EricLeFort/Capstone-Project/README.md

Check out a [demo](https://www.youtube.com/watch?v=lD4AIjvDnsE) of the final project!
