EricLeFort/Capstone-Project/doc/requirements/requirements.tex

\documentclass[titlepage]{article}
\usepackage[left=15mm,right=15mm,top=1in,bottom=1in]{geometry}
\usepackage{framed}
\usepackage{caption}
\usepackage{imakeidx}
\usepackage{graphicx}
\usepackage{array}

\newcolumntype{C}[1]{>{\centering\arraybackslash} m{#1cm}}
\graphicspath{{./img/}}

\makeindex

\title{Autonomous Pool Playing Robot\\~\\\textbf{\Huge{Requirements Specification}}}
\author{
	Ernest Selman\\selmae@mcmaster.ca\\1201291\\~\\\and
	Eric Le Fort\\leforte@mcmaster.ca\\1308609\\~\\\and
	Guy Meyer\\meyerg@mcmaster.ca\\1320231\\~\\\and
	Andrew Danha\\danhaas@mcmaster.ca\\1223881\\~\\\and
	Max Moore\\moorem8@mcmaster.ca\\1320009\\~\\\and
	Derek Savery\\saverydj@mcmaster.ca\\1219142\\~\\
}
 
\begin{document}
\maketitle
\tableofcontents
~\\[15mm]
\listoftables

\vfill
\begin{table}[!htbp]
\centering
\begin{tabular}{| C{3} | C{2} | C{5} | C{2.5} |}\hline
	Date			&Revision \#	&Comments						&Authors\\\hline
	03/06/2016		&0				&- Initial document creation	&Eric Le Fort\newline Max Moore\newline Guy Meyer\newline Ernest Selman\newline Andrew Danha\newline Derek Savery\\\hline
	07/03/2017		&1				&- Added context and functional decomposition diagrams\newline -Added description of normal operation and error handling\newline -Revised requirements	&Eric Le Fort\\\hline
\end{tabular}
\caption{Revision History}
\end{table}
\newpage
 
\section{Introduction}
\subsection{Project Overview}
The purpose of this project is to provide the client with an autonomous solution for a pool playing partner. The system will utilize Visual Recognition (VR) to make its own decisions regarding shot selection and then move accordingly to take that shot.

\subsection{Product Perspective}
This section will outline various interfacing requirements as well as memory constraints of the system.
\subsubsection{System Interfaces}
The only system level interface in this project will be a simple user-facing one for obtaining commands such as: take a shot, move out of the way, or stop motion.
\subsubsection{Hardware Interfaces}
The user will have the ability to interface with the system using hardware either through buttons, sensors or other hardware solutions. This functionality will allow the user to give the system trivial commands relating to the status of the game.
\subsubsection{Software Interfaces}
The software will have two major interfacing requirements. The first will be in the formatting of the table state data that will be passed from the VR program to the core programming language. The second will be in the formatting of instruction sets to be used by the $\mu$C. These formats must be designed to be syntactically consistent so that they can be understood by both subsystems.
\subsubsection{Communications Interfaces}
This system will have two inter-system communication interfaces:
\begin{enumerate}
	\item VR to PC\\\\
	The communication between the VR and the PC will require the system to output the image takes by the VR to the PC for further computation.
	\item PC to $\mu$C\\\\
	This method of communications defines the method of transferring information from the PC to the $\mu$C that will control the hardware.
	\item $\mu$C to PC\\\\
	The $\mu$C will communicate a response back to the PC so that the PC can be sure that the message was both received and that the command is valid.
\end{enumerate}
\subsubsection{Memory Constraints}
The PC will not be very limited in terms of memory since it will have large memory storage. The limitations of the PC will arise from its RAM memory which may cause the computations to take time.\\\\
The $\mu$C is more heavily constrained by its memory since most $\mu$C use chip memory that is generally in the order of Kilobytes.

\subsection{Description of Operation}
This section will describe both normal operation and how the system will handle unexpected events.
\subsubsection{Normal Operation}
First the system must be started. This is done by starting the Android application, starting the PC program, and then starting the $\mu$C program (in that order). Once the system is ready, there are two standard events that this system can take: moving out of the way and taking a shot. Both of these will be described here.\\~\\
Moving involves receiving a request from the user indicating that a move is required. Once this request is received, the system will determine where to move and generate the appropriate control signals to move the machine to that location. After movement has finished, the system will return to an idle state.\\~\\
Taking a shot is the most complicated event that this system will handle. In this case, the machine will first receive a request from the user indicating that the machine should take a shot. The $\mu$C will receive that command and then communicate it to the PC. The PC will first acknowledge that request and then pass on the request to the camera application. The camera application will receive this request, capture an image, and communicate that image back to the PC. Upon receipt of the image, the PC will initiate the VR program. Once the VR program writes its results to the output file, the PC will read its contents into memory. The PC will then determine which shot is the best to take and communicate that shot to the $\mu$C. The $\mu$C will then acknowledge receipt of the shot. Once the $\mu$C has the shot specification, it will compute which signals will move the machine appropriately and then generate those signals.
\subsubsection{Error Handling}
As with all complicated systems, it is possible that certain errors may arise during operation. For example, successful inter-program communication is never taken for granted and so acknowledgements are in place to make sure the communication actually happens. Also, in case of danger or harm being caused by the physical machine, there will be emergency stops to force the machine to cease its operation at any stage of the process.

\newpage
\subsection{Naming Conventions \& Definitions}
This section outlines the various definitions, acronyms and abbreviations that will be used throughout this document in order to familiarize the reader prior to reading.
\subsubsection{Definitions}
Table \ref{tab:Definitions} lists the definitions used in this document. The definitions given below are specific to this document and may not be identical to definitions of these terms in common use. The purpose of this section is to assist the user in understanding the requirements for the system.
\begin{table}[h!]
\centering
\caption{Definitions}
\begin{tabular}{| C{6} | p{6cm} |}\hline
	\textbf{Term}	&\textbf{\centering Meaning}\\\hline
	X-axis					&Distance along length of pool table\\\hline
	Y-axis					&Distance across width of pool table\\\hline
	Z-axis					&Height above pool table\\\hline
	End-effector			&The end of the arm that will strike the cue ball.\\\hline
	$\theta$				&Rotational angle of end-effector\\\hline
	Cue 					&End-effector\\\hline
	Direct shot				&No obstacles between cue ball and target ball\\\hline
	Straight shot			&A direct shot in which the cue ball, target ball, and target hole form a straight line\\\hline
	Break					&This refers to the first shot at the beginning of a game of pool when the cue ball is used to strike and separate the rest of the arranged balls\\\hline
	Jump					&In reference to a pool ball, this means that the ball loses contact with the table surface\\\hline
	Personal Computer		&A laptop that will be used to run the more involved computational tasks such as visual recognition and the shot selection algorithm.\\\hline
	Camera					&Some form of image capture device (e.g. a digital camera, smartphone with a camera, etc.)\\\hline
	Table State				&The current positions of all the balls on the table.\\\hline
	Standard Shot			&A shot that does not involve backspin, jumps, curving, etc. (i.e. trick shots)\\\hline
\end{tabular}
\label{tab:Definitions}
\end{table}

\newpage
\subsubsection{Acronyms \& Abbreviations}
Table \ref{tab:Acronyms} lists the acronyms and abbreviations used in this document.
\begin{table}[h!]
\centering
\caption{Acronyms and Abbreviations}
\begin{tabular}{| p{6cm} | p{6cm} |}\hline
	\textbf{Acronym/Abbreviation}	&\textbf{Meaning}\\\hline
	VR								&Visual Recognition\\\hline
	PC								&Personal Computer\\\hline
	$\mu$C							&Micro-Controller\\\hline
\end{tabular}
\label{tab:Acronyms}
\end{table}

\section{Project Drivers}
\subsection{The Purpose of the Project}
The purpose of this project is to provide pool players with an automated system that they can play against.

\subsection{The Clients, the Customers, and Other Stakeholders}
\subsubsection{The Clients}
\begin{itemize}
	\item[-] Dr. Wassyng
\end{itemize}
\subsubsection{The Customers}
\begin{itemize}
	\item[-] Professional pool players
	\item[-] Amateur pool players
	\item[-] Pool hall owners
\end{itemize}
\subsubsection{Other Stakeholders}
\begin{itemize}
	\item[-] Team Members
	\item[-] Pool Table Manufacturers
\end{itemize}

\subsection{Users of the Product}
\begin{itemize}
	\item[-] Control test group
	\item[-] Professional pool players
	\item[-] Amateur pool players
	\item[-] Demonstrators
\end{itemize}

\section{Project Constraints}
\subsection{Mandated Constraints}
These are the constraints that are outside of the control of the development team:
\begin{itemize}
	\item[-] 750 dollars investment limit
	\item[-] Must create a functional prototype
	\item[-] The group will be required to complete the entirety of this project by April 4\textsuperscript{th}, 2017
\end{itemize}

\subsection{Other Constraints}
Other constraints that the development team decided would be necessary:
\begin{itemize}
	\item[-] System will be customized for a specific table
	\item[-] The system should not be required to break the balls
	\item[-] The system shall only perform standard shots
	\item[-] No motion further than 2ft away from table (in the plane of the table surface)
	\item[-] No motion/components further than 4ft above the table surface
	\item[-] Cannot move at a dangerous speed other than striking the pool ball
	\item[-] The system shall adhere to the rules of pool (e.g. only moving balls by taking shots with a cue, only striking the cue ball, etc.)
	\item[-] Application of chalk to the cue will be handled manually
	\item[-] The system will only operate in regular pool playing environments (i.e. indoors at room temperature with sufficient space and lighting)
\end{itemize}

\subsection{Scope}
The scope of the project includes only the components of pool that require the player to attempt and take a shot. In other words, the system will not handle freely placing a ball on the table, breaking at the beginning of the game, or automatically knowing when it should take its shot.

\subsection{Relevant Facts \& Assumptions}
This section will outline various facts and assumptions that will be leveraged in the design of this system.
\subsubsection{Facts}
\begin{itemize}
	\item[-] Weight, size, and colour of the balls
	\item[-] Table dimensions
	\item[-] Table-ball static and dynamic coefficients of friction
	\item[-] Ball-ball static coefficient of friction
	\item[-] The spring constant of the table wall
\end{itemize}
\subsubsection{Assumptions}
\begin{itemize}
	\item[-] Table surface and walls are uniform
	\item[-] Table plane is completely perpendicular to the force of gravity
	\item[-] Balls are uniform in shape and density
	\item[-] No interference will occur mid-shot (e.g. user moves a ball, stops a balls motion, etc.)
	\item[-] Balls never jump
\end{itemize}

\section{Context Diagram}
\begin{center}
	
\captionof{figure}{System Context Diagram}
\label{fig:context diagram}
\end{center}

\section{Functional Decomposition Diagram}
\begin{center}
	
\captionof{figure}{Functional Decomposition Diagram}
\label{fig:functional decomposition diagram}
\end{center}
\newpage

\section{Requirements}
The following section outlines the various requirements of this system. For each requirement, a description of the requirement, the rationale behind the requirement, and a fit criterion for when the requirement is satisfied are provided. The values given for customer satisfaction and dissatisfaction are from 0-5. The values for requirement priority are either high, medium or low.\\\\
Requirement types will correspond to the following table:
\begin{table}[!htbp]
\centering
\begin{tabular}{| C{2.2} | C{5} |}\hline
	\textbf{Requirement Type}	&\textbf{Description}\\\hline
	1							&Software Capability\\\hline
	2							&Software Communication\\\hline
 	3							&Mechanical\\\hline
	4							&Electrical\\\hline
	LF							&Look \& Feel\\\hline
	UH							&Usability \& Humanity\\\hline
 	P							&Performance\\\hline
	OE							&Operation \& Environmental\\\hline
	MS							&Maintainability \& Support\\\hline
	S							&Safety \& Security\\\hline
	CP							&Cultural \& Political\\\hline
	L							&Legal\\\hline
\end{tabular}
\caption{Requirement Types}
\end{table}
 
\subsection{Functional Requirements}
The following is a collection of the functional requirements of this system:
\begin{framed}
	\noindent\textbf{Requirement \#}: 1 \hfill \textbf{Requirement Type}: 1 \hfill\\\\
	\noindent\textbf{Description}: The system will capture an overhead image of the table.\\
	\textbf{Rationale}: The system must be able to take in data to be used in the VR algorithm.\\
	\textbf{Fit Criterion}: This requirement will be considered satisfied if the image obtained is of sufficient quality to be successfully used by the VR algorithm.\\\\
	\textbf{Originator}: Eric Le Fort\\\\
	\noindent\textbf{Customer Satisfaction}: 0 \hfill 	\textbf{Customer Dissatisfaction}: 0 \hfill\\
	\textbf{Priority}: High \hfill \textbf{Conflicts}: None \hfill 		\\
	\textbf{Supporting Material}: None\\\\
	\noindent\textbf{History}: Created 01-NOV-2016
\end{framed}

\newpage
\begin{framed}
	\noindent\textbf{Requirement \#}: 2 \hfill \textbf{Requirement Type}: 2 \hfill\\\\
	\noindent\textbf{Description}: The system will communicate image data from the camera to the PC.\\
	\textbf{Rationale}: The system will have a separate device for image capture. It is imperative that that device can communicate its data to the PC in order to be used in the VR algorithm.\\
	\textbf{Fit Criterion}: This requirement will be considered satisfied if the data received by the PC is 99.9\% identical to the data transmitted by the camera.\\\\
	\textbf{Originator}: Eric Le Fort\\\\
	\noindent\textbf{Customer Satisfaction}: 0 \hfill 	\textbf{Customer Dissatisfaction}: 0 \hfill\\
	\textbf{Priority}: High \hfill \textbf{Conflicts}: None \hfill\\
	\textbf{Supporting Material}: None\\\\
	\noindent\textbf{History}: Created 01-NOV-2016
\end{framed}

\begin{framed}
	\noindent\textbf{Requirement \#}: 3 \hfill \textbf{Requirement Type}: 1 \hfill\\\\
	\noindent\textbf{Description}: The system will create a model of the table state in software using VR.\\
	\textbf{Rationale}: The table must be modelled such that the shot selection algorithm has information to work off of.\\
	\textbf{Fit Criterion}: This requirement will be considered satisfied if the modelling of each ball on the table is accurate to within 1 centimetre of their actual position.\\\\
	\textbf{Originator}: Eric Le Fort\\\\
	\noindent\textbf{Customer Satisfaction}: 0 \hfill 	\textbf{Customer Dissatisfaction}: 0 \hfill\\
	\textbf{Priority}: High \hfill \textbf{Conflicts}: None \hfill\\
	\textbf{Supporting Material}: None\\\\
	\noindent\textbf{History}: Created 01-NOV-2016
\end{framed}

\begin{framed}
	\noindent\textbf{Requirement \#}: 4 \hfill \textbf{Requirement Type}: 1 \hfill\\\\
	\noindent\textbf{Description}: The system will select an optimal shot based off a series of simulations using the table state.\\
	\textbf{Rationale}: The system must be able to come up with a shot to make given the table state.\\
	\textbf{Fit Criterion}: This requirement will have various degrees of success. It will be considered satisfied on its simplest level if the system comes up with a shot that can sink a target ball. Further success includes selecting shots that are more likely to be successful, can sink multiple balls or can avoid sinking unwanted balls.\\\\
	\textbf{Originator}: Eric Le Fort\\\\
	\noindent\textbf{Customer Satisfaction}: 2 \hfill 	\textbf{Customer Dissatisfaction}: 4 \hfill\\
	\textbf{Priority}: Medium \hfill \textbf{Conflicts}: None \hfill\\
	\textbf{Supporting Material}: None\\\\
	\noindent\textbf{History}: Created 01-NOV-2016
\end{framed}

\newpage
\begin{framed}
	\noindent\textbf{Requirement \#}: 5 \hfill \textbf{Requirement Type}: 2 \hfill\\\\
	\noindent\textbf{Description}: The system will communicate the model of the table state from the VR program to the system's core programming language.\\
	\textbf{Rationale}: The VR program will only be used to compute VR calculations and a more suitable language will be utilized to handle the rest of the program's functionality. Therefore, the results that the VR program arrives at is likely to be passed to another language.\\
	\textbf{Fit Criterion}: This requirement will be considered satisfied if the data received by the core programming language is identical to that computed in the VR program.\\\\
	\textbf{Originator}: Eric Le Fort\\\\
	\noindent\textbf{Customer Satisfaction}: 0 \hfill 	\textbf{Customer Dissatisfaction}: 0 \hfill\\
	\textbf{Priority}: High \hfill \textbf{Conflicts}: None \hfill\\
	\textbf{Supporting Material}: None\\\\
	\noindent\textbf{History}: Created 01-NOV-2016
\end{framed}

\begin{framed}
	\noindent\textbf{Requirement \#}: 6 \hfill \textbf{Requirement Type}: 1 \hfill\\\\
	\noindent\textbf{Description}: The system will create an instruction set for the embedded system based on the selected shot.\\
	\textbf{Rationale}: Once a shot is selected, the system must then determine the necessary steps to take in order for the machine to be able to make the shot. This will include motion of all elements to position the end-effector at a suitable location from machine's current location as well as how the end-effector should strike the cue ball.\\
	\textbf{Fit Criterion}: This requirement will be considered satisfied if the instruction set provided contains all necessary information and that information does in fact instruct the embedded system on how to go about making the selected shot.\\\\
	\textbf{Originator}: Eric Le Fort\\\\
	\noindent\textbf{Customer Satisfaction}: 0 \hfill 	\textbf{Customer Dissatisfaction}: 0 \hfill\\
	\textbf{Priority}: High \hfill \textbf{Conflicts}: None \hfill\\
	\textbf{Supporting Material}: None\\\\
	\noindent\textbf{History}: Created 01-NOV-2016
\end{framed}

\newpage
\begin{framed}
	\noindent\textbf{Requirement \#}: 7 \hfill \textbf{Requirement Type}: 2 \hfill\\\\
	\noindent\textbf{Description}: The system will communicate the selected shot to the $\mu$C.\\
	\textbf{Rationale}: The PC must be able to communicate the selected shot to the $\mu$C in order to operate the machine.\\
	\textbf{Fit Criterion}: This requirement will be considered satisfied if the data received by the $\mu$C is identical to that computed in the PC 99.9\% of the time.\\\\
	\textbf{Originator}: Eric Le Fort\\\\
	\noindent\textbf{Customer Satisfaction}: 0 \hfill 	\textbf{Customer Dissatisfaction}: 0 \hfill\\
	\textbf{Priority}: High \hfill \textbf{Conflicts}: None \hfill\\
	\textbf{Supporting Material}: None\\\\
	\noindent\textbf{History}: Created 01-NOV-2016
\end{framed}

\begin{framed}
	\noindent\textbf{Requirement \#}: 8 \hfill \textbf{Requirement Type}: 2 \hfill\\\\
	\noindent\textbf{Description}: The $\mu$C will communicate an acknowledgement back to the PC.\\
	\textbf{Rationale}: The PC should be able to verify that the $\mu$C received the message.\\
	\textbf{Fit Criterion}: This requirement will be considered satisfied if the response received is identical to the response sent and if the response is correct given the current state of the system 99.9\% of the time.\\\\
	\textbf{Originator}: Eric Le Fort\\\\
	\noindent\textbf{Customer Satisfaction}: 0 \hfill 	\textbf{Customer Dissatisfaction}: 2 \hfill\\
	\textbf{Priority}: Low \hfill \textbf{Conflicts}: None \hfill\\
	\textbf{Supporting Material}: None\\\\
	\noindent\textbf{History}: Created 01-NOV-2016
\end{framed}

\begin{framed}
	\noindent\textbf{Requirement \#}: 9 \hfill \textbf{Requirement Type}: 1 \hfill\\\\
	\noindent\textbf{Description}: The $\mu$C will be able to interpret a shot instruction to control signals.\\
	\textbf{Rationale}: The embedded system must encode the instruction set it generates into the equivalent electrical signals.\\
	\textbf{Fit Criterion}: This requirement will be considered satisfied if the control signals generated from the instruction set would move the machine to the correct location.\\\\
	\textbf{Originator}: Eric Le Fort\\\\
	\noindent\textbf{Customer Satisfaction}: 0 \hfill 	\textbf{Customer Dissatisfaction}: 0 \hfill\\
	\textbf{Priority}: High \hfill \textbf{Conflicts}: None \hfill\\
	\textbf{Supporting Material}: None\\\\
	\noindent\textbf{History}: Created 01-NOV-2016
\end{framed}

\newpage
\begin{framed}
	\noindent\textbf{Requirement \#}: 10 \hfill \textbf{Requirement Type}: 4 \hfill\\\\
	\noindent\textbf{Description}: The system will be able to detect the machine's current physical state at certain locations.\\
	\textbf{Rationale}: If the system has a way of verifying the machine's current physical state, it will be able to detect unexpected disturbances. This will lead to higher accuracy of instructions being generated in certain cases as well as enabling the machine to self-correct as necessary.\\
	\textbf{Fit Criterion}: This requirement will have various degrees of success. It will be considered satisfied on its simplest level if it can be used to calibrate the system within negligible error (i.e. a default starting point to return to when in doubt). Other levels of success would include more set points that can be used as reference.\\\\
	\textbf{Originator}: Eric Le Fort\\\\
	\noindent\textbf{Customer Satisfaction}: 0 \hfill 	\textbf{Customer Dissatisfaction}: 0 \hfill\\
	\textbf{Priority}: Low \hfill \textbf{Conflicts}: None \hfill\\
	\textbf{Supporting Material}: None\\\\
	\noindent\textbf{History}: Created 01-NOV-2016
\end{framed}

\begin{framed}
	\noindent\textbf{Requirement \#}: 11 \hfill \textbf{Requirement Type}: 1 \hfill\\\\
	\noindent\textbf{Description}: The system will keep track of the machine's current physical state.\\
	\textbf{Rationale}: In order to determine how to move the machine to take its next shot, the system must know the starting physical state of the machine.\\
	\textbf{Fit Criterion}: This requirement will be considered satisfied if the physical state of the machine is updated correctly as expected movements are made by the machine.\\\\
	\textbf{Originator}: Eric Le Fort\\\\
	\noindent\textbf{Customer Satisfaction}: 0 \hfill 	\textbf{Customer Dissatisfaction}: 0 \hfill\\
	\textbf{Priority}: High \hfill \textbf{Conflicts}: None \hfill\\
	\textbf{Supporting Material}: None\\\\
	\noindent\textbf{History}: Created 01-NOV-2016
\end{framed}

\begin{framed}
	\noindent\textbf{Requirement \#}: 12 \hfill \textbf{Requirement Type}: 3 \hfill\\\\
	\noindent\textbf{Description}: The machine will be able to move the end-effector to the determined location and orientation.\\
	\textbf{Rationale}: The system must be able to relocate the end-effector in order to make a shot.\\
	\textbf{Fit Criterion}: This requirement will be considered satisfied if the machine moves close enough to the location specified by the system such that the shot can be made successfully 95\% of the time.\\\\
	\textbf{Originator}: Eric Le Fort\\\\
	\noindent\textbf{Customer Satisfaction}: 5 \hfill 	\textbf{Customer Dissatisfaction}: 5 \hfill\\
	\textbf{Priority}: High \hfill \textbf{Conflicts}: None \hfill\\
	\textbf{Supporting Material}: None\\\\
	\noindent\textbf{History}: Created 01-NOV-2016
\end{framed}

\begin{framed}
	\noindent\textbf{Requirement \#}: 13 \hfill \textbf{Requirement Type}: 3 \hfill\\\\
	\noindent\textbf{Description}: The machine will be able to actuate the end-effector to strike the cue ball, taking a shot.\\
	\textbf{Rationale}: The system must be able to strike the cue ball in order to actually take a shot. The force required will likely vary and therefore the system must be able to adjust accordingly.\\
	\textbf{Fit Criterion}: This requirement will be considered satisfied if the machine actuates the end-effector within 5\% of the specified speed and the maximum force is powerful enough to have the cue ball travel the full length of the table, bounce off the far wall, and then return halfway.\\\\
	\textbf{Originator}: Eric Le Fort\\\\
	\noindent\textbf{Customer Satisfaction}: 5 \hfill 	\textbf{Customer Dissatisfaction}: 5 \hfill\\
	\textbf{Priority}: High \hfill \textbf{Conflicts}: None \hfill\\
	\textbf{Supporting Material}: None\\\\
	\noindent\textbf{History}: Created 01-NOV-2016
\end{framed}

\begin{framed}
	\noindent\textbf{Requirement \#}: 14 \hfill \textbf{Requirement Type}: 3 \hfill\\\\
	\noindent\textbf{Description}: The machine will be able to take user input to indicate options such as: take a shot, move out of the way, or stop operation.\\
	\textbf{Rationale}: The user will need to indicate to the system what it needs it to do. Automatically knowing what the user would desire from the machine is outside of the scope of this project.\\
	\textbf{Fit Criterion}: This requirement will be considered satisfied if the embedded system can react to signals from the user signifying the specified functionalities within 5 seconds 90\% of the time.\\\\
	\textbf{Originator}: Eric Le Fort\\\\
	\noindent\textbf{Customer Satisfaction}: 2 \hfill 	\textbf{Customer Dissatisfaction}: 5 \hfill\\
	\textbf{Priority}: High \hfill \textbf{Conflicts}: None \hfill\\
	\textbf{Supporting Material}: None\\\\
	\noindent\textbf{History}: Created 01-NOV-2016
\end{framed}

\begin{framed}
	\noindent\textbf{Requirement \#}: 15 \hfill \textbf{Requirement Type}: 3 \hfill\\\\
	\noindent\textbf{Description}: The machine will be capable of moving out of the way to pre-determined locations upon user request.\\
	\textbf{Rationale}: The system must be able to move the machine out of the way if the machine is in the user's way while they are attempting to make a shot.\\
	\textbf{Fit Criterion}: This requirement will be considered satisfied if after the machine is instructed to move out of the user's way it moves to a pre-determined location.\\\\
	\textbf{Originator}: Eric Le Fort\\\\
	\noindent\textbf{Customer Satisfaction}: 4 \hfill 	\textbf{Customer Dissatisfaction}: 3 \hfill\\
	\textbf{Priority}: Low \hfill \textbf{Conflicts}: None \hfill\\
	\textbf{Supporting Material}: None\\\\
	\noindent\textbf{History}: Created 01-NOV-2016
\end{framed}

\begin{framed}
	\noindent\textbf{Requirement \#}: 16 \hfill \textbf{Requirement Type}: 3 \hfill\\\\
	\noindent\textbf{Description}: The system will be able to move the machine around the table as necessary. \\
	\textbf{Rationale}: In order to make shots, the machine must first be able to move into place.\\
	\textbf{Fit Criterion}: This requirement is satisfied if the system is able to move into any position required to take a shot.\\\\
	\textbf{Originator}: Ernest Selman\\\\
	\noindent\textbf{Customer Satisfaction}: 0 \hfill 	\textbf{Customer Dissatisfaction}: 0 \hfill\\
	\textbf{Priority}: Medium \hfill \textbf{Conflicts}: None \hfill\\
	\textbf{Supporting Material}: None\\\\
	\noindent\textbf{History}: Created 03-NOV-2016
\end{framed}

\begin{framed}
	\noindent\textbf{Requirement \#}: 17 \hfill \textbf{Requirement Type}: 3 \hfill\\\\
	\noindent\textbf{Description}: The machine will be able to take a shot regardless of the table state.\\
	\textbf{Rationale}: The machine needs to hit the cue ball without moving the other balls even if the cue ball is on the edge of the table or surrounded by other balls.\\
	\textbf{Fit Criterion}: This requirement is satisfied if the machine is able to hit the cue ball in 99\% of situations while adhering to the rules of the game.\\\\
	\textbf{Originator}: Ernest Selman\\\\
	\noindent\textbf{Customer Satisfaction}: 3 \hfill 	\textbf{Customer Dissatisfaction}: 4 \hfill\\
	\textbf{Priority}: Medium \hfill \textbf{Conflicts}: None \hfill\\
	\textbf{Supporting Material}: None\\\\
	\noindent\textbf{History}: Created 03-NOV-2016
\end{framed}

\begin{framed}
	\noindent\textbf{Requirement \#}: 18 \hfill \textbf{Requirement Type}: 4 \hfill\\\\
	\noindent\textbf{Description}: The power supply for the system must be transformed from AC to DC as necessary.\\
	\textbf{Rationale}: Certain components will rely on DC power and the power source will only provide AC current.\\
	\textbf{Fit Criterion}: This requirement will be considered satisfied if the necessary components can be successfully powered using an AC to DC converter.\\\\
	\textbf{Originator}: Andrew Danha\\\\ 
	\noindent\textbf{Customer Satisfaction}: 0 \hfill 	\textbf{Customer Dissatisfaction}: 0 \hfill\\
	\textbf{Priority}: High \hfill \textbf{Conflicts}: None \hfill\\
	\textbf{Supporting Material}: None\\\\
	\noindent\textbf{History}: Created 02-NOV-2016
\end{framed}

\newpage
\subsection{Non-Functional Requirements}
The following is a collection of the non-functional requirements of this system:
\subsubsection{Look \& Feel Requirements}
\begin{framed}
	\noindent\textbf{Requirement \#}: 2 \hfill \textbf{Requirement Type}: LF \hfill\\\\
	\noindent\textbf{Description}: The general look and feel of the setup must sufficiently resemble a standard pool table.\\
	\textbf{Rationale}: The setup must be familiar to the player such that they feel comfortable playing against the robot.\\
	\textbf{Fit Criterion}: 90\% of users should conclude that the look and feel of the setup sufficiently resembles a standard pool table.\\\\
	\textbf{Originator}: Derek Savery\\\\
	\noindent\textbf{Customer Satisfaction}: 1\hfill 	\textbf{Customer Dissatisfaction}: 4 \hfill\\
	\textbf{Priority}: Low \hfill \textbf{Conflicts}: None \hfill\\
	\textbf{Supporting Material}: None\\\\
	\noindent\textbf{History}: Created 04-NOV-2016
\end{framed}

\subsubsection{Usability \& Humanity Requirements}
\begin{framed}
	\noindent\textbf{Requirement \#}: 1 \hfill \textbf{Requirement Type}: UH \hfill\\\\
	\noindent\textbf{Description}: Players must be able to see the table setup upon their turn.\\
	\textbf{Rationale}: The users must be able to see the table in order to make decisions about future shots.\\
	\textbf{Fit Criterion}: 90\% of users should conclude that the position of the machine does not inhibit their ability to see the game-state when it is their turn.\\\\
	\textbf{Originator}: Maxwell Moore\\\\
	\noindent\textbf{Customer Satisfaction}: 2 \hfill 	\textbf{Customer Dissatisfaction}: 4 \hfill\\
	\textbf{Priority}: High \hfill \textbf{Conflicts}: None \hfill\\
	\textbf{Supporting Material}: None\\\\
	\noindent\textbf{History}: Created 03-NOV-2016
\end{framed}

\newpage
\begin{framed}
	\noindent\textbf{Requirement \#}: 2 \hfill \textbf{Requirement Type}: UH \hfill\\\\
	\noindent\textbf{Description}: The design of the machine shall not greatly inhibit a players ability to make a shot.\\
	\textbf{Rationale}: The users must be able to play alongside the machine.\\
	\textbf{Fit Criterion}: 90\% of users should conclude that the position of the machine does not inhibit their ability to make shots as well as they would be able to on a regular pool table.\\\\
	\textbf{Originator}: Maxwell Moore\\\\
	\noindent\textbf{Customer Satisfaction}: 1 \hfill 	\textbf{Customer Dissatisfaction}: 5 \hfill\\
	\textbf{Priority}: High \hfill \textbf{Conflicts}: None \hfill\\
	\textbf{Supporting Material}: None\\\\
	\noindent\textbf{History}: Created 03-NOV-2016
\end{framed}

\begin{framed}
	\noindent\textbf{Requirement \#}: 3 \hfill \textbf{Requirement Type}: UH \hfill\\\\
	\noindent\textbf{Description}: The robot should not interrupt the player's turn.\\
	\textbf{Rationale}: If the user chooses to stop the robot, or if the robot has completed its movement, the robot should remain stopped until activated by the user.\\
	\textbf{Fit Criterion}: The robot shall not interrupt the player's turn 99.9\% of the time.\\\\
	\textbf{Originator}: Derek Savery\\\\
	\noindent\textbf{Customer Satisfaction}: 1 \hfill 	\textbf{Customer Dissatisfaction}: 3 \hfill\\
	\textbf{Priority}: Medium \hfill \textbf{Conflicts}: Possibly with enforcing rules of game \hfill\\
	\textbf{Supporting Material}: None\\\\
	\noindent\textbf{History}: Created 04-NOV-2016
\end{framed}

\subsubsection{Performance Requirements}
\begin{framed}
	\noindent\textbf{Requirement \#}: 1 \hfill \textbf{Requirement Type}: P\hfill\\\\
	\noindent\textbf{Description}: The system will take shots within a reasonable amount of time.\\
	\textbf{Rationale}: The user should not have to wait too long to play their turn.\\
	\textbf{Fit Criterion}: The machine will make a shot in under 90 seconds after being instructed to 90\% of the time.\\\\
	\textbf{Originator}: Maxwell Moore\\\\
	\noindent\textbf{Customer Satisfaction}: 1 \hfill 	\textbf{Customer Dissatisfaction}: 4 \hfill\\
	\textbf{Priority}: Medium \hfill \textbf{Conflicts}: None \hfill\\
	\textbf{Supporting Material}: None\\\\
	\noindent\textbf{History}: Created 03-NOV-2016
\end{framed}

\newpage
\begin{framed}
	\noindent\textbf{Requirement \#}: 2 \hfill \textbf{Requirement Type}: P\hfill\\\\
	\noindent\textbf{Description}: The system will take shots precisely.\\
	\textbf{Rationale}: The user should feel challenged by the system.\\
	\textbf{Fit Criterion}: This requirement will be considered satisfied if the system performs to the minimum standards in terms of successful shots as set forth in the \textit{Summary and Goals} document associated with this project.\\\\
	\textbf{Originator}: Maxwell Moore\\\\
	\noindent\textbf{Customer Satisfaction}: 4 \hfill 	\textbf{Customer Dissatisfaction}: 3\hfill\\
	\textbf{Priority}: Low \hfill \textbf{Conflicts}: None \hfill\\
	\textbf{Supporting Material}: Summary and Goals document.\\\\
	\noindent\textbf{History}: Created 03-NOV-2016
\end{framed}

\begin{framed}
	\noindent\textbf{Requirement \#}: 3 \hfill \textbf{Requirement Type}: P \hfill\\\\
	\noindent\textbf{Description}: The machine will be light.\\
	\textbf{Rationale}: If the machine is light it will be easier to relocate, be handled by the user, and it will require less power to move components.\\
	\textbf{Fit Criterion}: This requirement is satisfied if the components are light enough to be moved by the system fast enough to meet timing requirements.\\\\
	\textbf{Originator}: Ernest Selman\\\\
	\noindent\textbf{Customer Satisfaction}: 0 \hfill 	\textbf{Customer Dissatisfaction}: 5 \hfill\\
	\textbf{Priority}: High \hfill \textbf{Conflicts}: None \hfill\\
	\textbf{Supporting Material}: None\\\\
	\noindent\textbf{History}: Created 03-NOV-2016
\end{framed}

\begin{framed}
	\noindent\textbf{Requirement \#}: 4 \hfill \textbf{Requirement Type}: P \hfill\\\\
	\noindent\textbf{Description}: The body of the machine will be rigid. \\
	\textbf{Rationale}: The body of the machine will be rigid in order to support the components necessary for taking shots.\\
	\textbf{Fit Criterion}: This requirement is satisfied if the machine is rigid enough not to buckle excessively or be displaced by taking a shot.\\\\
	\textbf{Originator}: Ernest Selman\\\\
	\noindent\textbf{Customer Satisfaction}: 0 \hfill 	\textbf{Customer Dissatisfaction}: 4 \hfill\\
	\textbf{Priority}: High \hfill \textbf{Conflicts}: None \hfill\\
	\textbf{Supporting Material}: None\\\\
	\noindent\textbf{History}: Created 03-NOV-2016
\end{framed}

\newpage
\subsubsection{Operational \& Environmental Requirements}
\begin{framed}
	\noindent\textbf{Requirement \#}: 1 \hfill \textbf{Requirement Type}: OE \hfill\\\\
	\noindent\textbf{Description}: The system will be able to be powered by a standard 120V AC 60Hz outlet.\\
	\textbf{Rationale}: The system should be simple to power.\\
	\textbf{Fit Criterion}: This requirement will be considered satisfied if all components of the system can be powered using a standard outlet.\\\\
	\textbf{Originator}: Andrew Danha\\\\
	\noindent\textbf{Customer Satisfaction}: 4 \hfill 	\textbf{Customer Dissatisfaction}: 5 \hfill\\
	\textbf{Priority}: Medium \hfill \textbf{Conflicts}: None \hfill\\
	\textbf{Supporting Material}: None\\\\
	\noindent\textbf{History}: Created 02-NOV-2016
\end{framed}

\subsubsection{Maintainability \& Support Requirements}
\begin{framed}
	\noindent\textbf{Requirement \#}: 1 \hfill \textbf{Requirement Type}: MS \hfill\\\\
	\noindent\textbf{Description}: The system software should separate safety critical components from other components.\\
	\textbf{Rationale}: The system will be designed to allow for updates without compromising previously tested safety-critical software components.\\
	\textbf{Fit Criterion}: All safety critical operations are encapsulated within their own modules.\\\\
	\textbf{Originator}: Eric Le Fort\\\\
	\noindent\textbf{Customer Satisfaction}: 0 \hfill 	\textbf{Customer Dissatisfaction}: 0\hfill\\
	\textbf{Priority}: Low \hfill \textbf{Conflicts}: None\hfill\\
	\textbf{Supporting Material}: None\\\\
	\noindent\textbf{History}: Created 02-NOV-2016
\end{framed}

\begin{framed}
	\noindent\textbf{Requirement \#}: 2 \hfill \textbf{Requirement Type}: MS \hfill\\\\
	\noindent\textbf{Description}: The machine will be able to stay in full working order over a reasonable amount of time.\\
	\textbf{Rationale}: The machine is not of much use if it cannot last for some amount of time.\\
	\textbf{Fit Criterion}: The machine remains in full working order or can be sufficiently repaired 6 months after construction.\\\\
	\noindent\textbf{Customer Satisfaction}: 3 \hfill 	\textbf{Customer Dissatisfaction}: 5\hfill\\
	\textbf{Priority}: High \hfill \textbf{Conflicts}: None\hfill\\
	\textbf{Supporting Material}: None\\\\
	\noindent\textbf{History}: Created 02-NOV-2016
\end{framed}
\newpage

\subsubsection{Security \& Safety Requirements}
\begin{framed}
	\noindent\textbf{Requirement \#}: 1 \hfill \textbf{Requirement Type}: S \hfill\\\\
	\noindent\textbf{Description}: High voltage components will be safely secured from users.\\
	\textbf{Rationale}: The system should not present electrical hazards.\\
	\textbf{Fit Criterion}: This requirement will be considered satisfied if all high voltage components are not readily accessible to users without tampering.\\\\
	\textbf{Originator}: Andrew Danha\\\\
	\noindent\textbf{Customer Satisfaction}: 0 \hfill 	\textbf{Customer Dissatisfaction}: 5 \hfill\\
	\textbf{Priority}: High \hfill \textbf{Conflicts}: None \hfill\\
	\textbf{Supporting Material}: None\\\\
	\noindent\textbf{History}: Created 02-NOV-2016
\end{framed}

\begin{framed}
	\noindent\textbf{Requirement \#}: 2 \hfill \textbf{Requirement Type}: S \hfill\\\\
	\noindent\textbf{Description}: Users will not be able to modify system to perform unsafe actions such as setting the power of a shot beyond a certain safe value.\\
	\textbf{Rationale}: The machine will not be able to be used in a dangerous fashion.\\
	\textbf{Fit Criterion}: This requirement is satisfied if 99.9\% of users must not be able to figure out a way of making the system perform an unsafe action.\\\\
	\textbf{Originator}: Maxwell Moore\\\\
	\noindent\textbf{Customer Satisfaction}: 0 \hfill 	\textbf{Customer Dissatisfaction}: 0 \hfill\\
	\textbf{Priority}: Low \hfill \textbf{Conflicts}: none \hfill\\
	\textbf{Supporting Material}: None\\\\
	\noindent\textbf{History}: Created 03-NOV-2016
\end{framed}

\begin{framed}
	\noindent\textbf{Requirement \#}: 3 \hfill \textbf{Requirement Type}: S \hfill\\\\
	\noindent\textbf{Description}: Sensitive electrical equipment will be isolated from high voltage.\\
	\textbf{Rationale}: Certain equipment like the $\mu$C and sensors can be damaged if connected to high voltage sources.\\
	\textbf{Fit Criterion}: This requirement is satisfied if sensitive electrical equipment is not connected to high voltage sources that would cause damage.\\\\
	\textbf{Originator}: Ernest Selman\\\\
	\noindent\textbf{Customer Satisfaction}: 0 \hfill 	\textbf{Customer Dissatisfaction}: 0 \hfill\\
	\textbf{Priority}: High \hfill \textbf{Conflicts}: None \hfill\\
	\textbf{Supporting Material}: None\\\\
	\noindent\textbf{History}: Created 03-NOV-2016
\end{framed}

\begin{framed}
	\noindent\textbf{Requirement \#}: 4 \hfill \textbf{Requirement Type}: S \hfill\\\\
	\noindent\textbf{Description}: All high voltage components will have circuit breakers.\\
	\textbf{Rationale}: The system should be safe to use.\\
	\textbf{Fit Criterion}: This requirement will be considered satisfied if the power supply is cut to all high voltage components of the system when the circuit is overloaded.\\\\
	\textbf{Originator}: Andrew Danha\\\\
	\noindent\textbf{Customer Satisfaction}: 0 \hfill 	\textbf{Customer Dissatisfaction}: 3 \hfill\\
	\textbf{Priority}: High \hfill \textbf{Conflicts}: None \hfill\\
	\textbf{Supporting Material}: None\\\\
	\noindent\textbf{History}: Created 13-NOV-2016
\end{framed}

\begin{framed}
	\noindent\textbf{Requirement \#}: 5 \hfill \textbf{Requirement Type}: S \hfill\\\\
	\noindent\textbf{Description}:The $\mu$C will have a voltage regulator.\\
	\textbf{Rationale}: The $\mu$C requires sufficient voltage/current to operate but may be damaged if too much voltage or current is supplied.\\
	\textbf{Fit Criterion}: This requirement will be considered satisfied if the $\mu$C is provided with a regulated amount of voltage and current to operate.\\\\
	\textbf{Originator}: Andrew Danha\\\\ 
	\noindent\textbf{Customer Satisfaction}: 0 \hfill 	\textbf{Customer Dissatisfaction}: 5 \hfill\\
	\textbf{Priority}: High \hfill \textbf{Conflicts}: None \hfill\\
	\textbf{Supporting Material}: None\\\\
	\noindent\textbf{History}: Created 13-NOV-2016
\end{framed}

\begin{framed}
	\noindent\textbf{Requirement \#}: 6 \hfill \textbf{Requirement Type}: S \hfill\\\\
	\noindent\textbf{Description}: Users standing at least 2ft outside the perimeter of the setup will be in no danger of being harmed by any action taken by the mechanism.\\
	\textbf{Rationale}: The robot shall not be able to harm users.\\
	\textbf{Fit Criterion}: No user standing at least 2ft outside of the perimeter of the setup shall come to harm by any action taken by the mechanism.\\\\
	\textbf{Originator}: Derek Savery\\\\
	\noindent\textbf{Customer Satisfaction}: 1 \hfill 	\textbf{Customer Dissatisfaction}: 5 \hfill\\
	\textbf{Priority}: High \hfill \textbf{Conflicts}: none \hfill\\
	\textbf{Supporting Material}: None\\\\
	\noindent\textbf{History}: Created 04-NOV-2016
\end{framed}
\newpage

\begin{framed}
	\noindent\textbf{Requirement \#}: 7 \hfill \textbf{Requirement Type}: S \hfill\\\\
	\noindent\textbf{Description}: There will be shutdown buttons located near any moving parts.\\
	\textbf{Rationale}: Users should be able to signal the system to stop if they feel they are in danger.\\
	\textbf{Fit Criterion}: Shutdown switches are located within reach of any possible dangerous location.\\\\
	\textbf{Originator}: Derek Savery\\\\
	\noindent\textbf{Customer Satisfaction}: 1 \hfill 	\textbf{Customer Dissatisfaction}: 4 \hfill\\
	\textbf{Priority}: High \hfill \textbf{Conflicts}: none \hfill\\
	\textbf{Supporting Material}: None\\\\
	\noindent\textbf{History}: Created 04-NOV-2016
\end{framed}

\subsubsection{Cultural \& Political Requirements}
\begin{framed}
	\noindent\textbf{Requirement \#}: 1 \hfill \textbf{Requirement Type}: CP \hfill\\\\
	\noindent\textbf{Description}: There will be no direct references to any political or religious groups.\\
	\textbf{Rationale}: This will avoid accidentally offending certain members of society.\\
	\textbf{Fit Criterion}: This requirement will be considered satisfied if 99\% of users say there is no noticeable political or cultural relevance.\\\\
	\textbf{Originator}: Maxwell Moore\\\\
	\noindent\textbf{Customer Satisfaction}: 0 \hfill 	\textbf{Customer Dissatisfaction}: 2 \hfill\\
	\textbf{Priority}: low \hfill \textbf{Conflicts}: none \hfill\\
	\textbf{Supporting Material}: None\\\\
	\noindent\textbf{History}: Created 03-NOV-2016
\end{framed}

\subsubsection{Legal Requirements}
\begin{framed}
	\noindent\textbf{Requirement \#}: 1 \hfill \textbf{Requirement Type}: L\hfill\\\\
	\noindent\textbf{Description}: There will be no copyright infringement, unlicensed usage of software, or services that have not been properly licensed.\\
	\textbf{Rationale}: This will avoid academic dishonesty and maintain the moral integrity of the group.\\
	\textbf{Fit Criterion}: An outside consultant will verify that there has been no copyright infringement, unlicensed usage of software, or services that have not been properly licensed.\\\\
	\textbf{Originator}: Maxwell Moore\\\\
	\noindent\textbf{Customer Satisfaction}: 1 \hfill 	\textbf{Customer Dissatisfaction}: 1 \hfill\\
	\textbf{Priority}: low \hfill \textbf{Conflicts}: none \hfill\\
	\textbf{Supporting Material}: None\\\\
	\noindent\textbf{History}: Created 03-NOV-2016
\end{framed}

\section{Project Issues}
The issues to be addressed consider marketability, competition, safety, liabilities, or any other noticeable concerns.\\
Furthermore, visual recognition, creating a pool table and the structural stability of the machine will be major challenges that must be overcome.
\subsection{Existing Products}
All known existing products are not publicly available. Nevertheless, these projects may affect the clients' view of the product and the overall marketability of the product.

\subsection{Off-the-Shelf Solutions}
Certain concerns involved in the development of this project can be addressed by using what has been created by others. There are various libraries that can be leveraged in order to aid in the visual recognition segment of this project. A pool table can be purchased to avoid difficulties in creating a high quality table environment. The structure of the system can be optimized by purchasing high quality metals that are already machined in the appropriate fashion.

\subsection{Risks}
The risks found in this project generally describe the safety considerations found with both the creation and operation of the product. This machine may have quite strong motor and actuators that may be high current or high voltage devices. It is imperative that the user's safety is taken into account and that even a player without any electrical experience will be able to at least be around the table. Another risk is achieving high enough precision to actually make successful shots.

\subsection{User Documentation \& Training}
In order to market the product the user will need to be provided with documentation regarding the operation, safety, and maintenance of the system. Although the product should be designed in a way that promotes ease of use, there must be some form of training required before the user can comfortably use the product. This may include a user manual or videos.
\end{document}
