EricLeFort/Capstone-Project/doc/Presentation/Electrical Presentation.pptx

## Electrical and Controls Summary

- Arduino Mega 2560 interfaced with RAMPS 1.4
  - Design is simplified with modular motor drives
- Endstops for controlling motors within bounds
- Simple UI
  - 2 buttons: user control button and move button
  - Colour changing LED to indicate system’s current mode

## White Line Sensors

- 2 used in the rotational system
  - 1 for each gear
  - When both sensors read low rotational system is at origin

## Pneumatic End-effector

- BJTs used to control extension
and retraction motion of piston

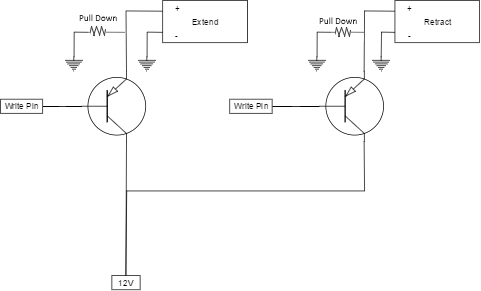
[picture p22: figure]

## Electrical and Controls Improvements

- Speed Up Slow Down

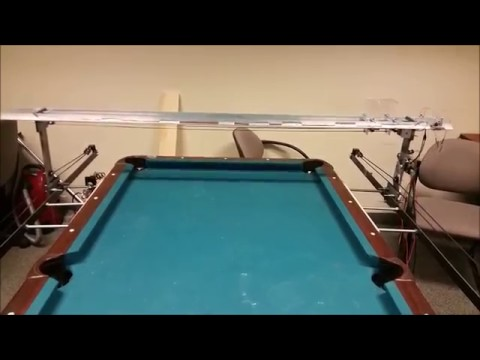
[picture p23: figure]

- End Stop Anticipation

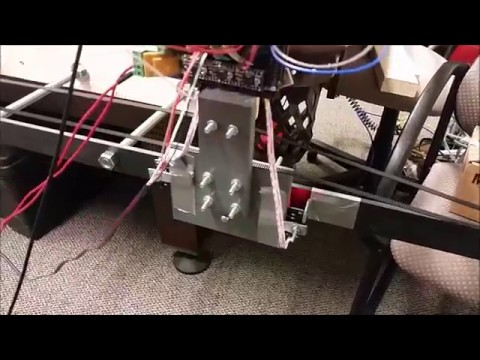
[picture p24: figure]

## Electrical and Controls Improvements #2

- Simultaneous Motion

## Electrical and Controls Hurdles

- Wire management → MCU

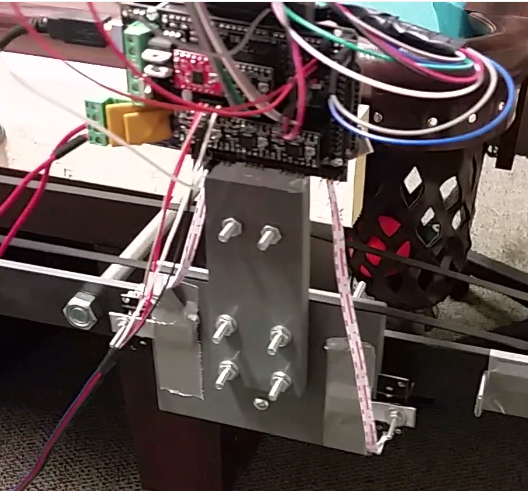
[picture p25: figure]

- Wire management → X rails

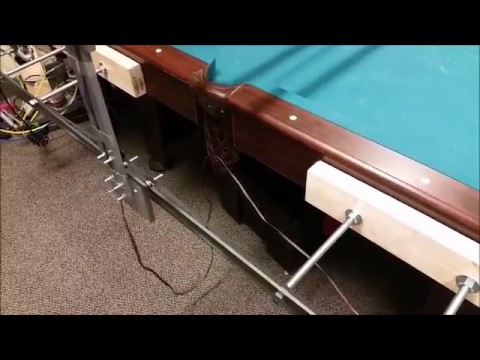
[picture p26: figure]
