EricLeFort/Capstone-Project/doc/SoftwareDesign/fullDesign/softwareDesign.pdf

# Autonomous Pool Playing Robot

# Software Design

Eric Le Fort
leforte@mcmaster.ca
1308609

March 27, 2017

## Contents

1 Introduction | 4
2 Use Cases | 7
3 Architectural Design | 8
4 Class Responsibility Collaboration (CRC) Cards | 11
5 Module Guide | 16
6 Program Diagrams | 28
7 Physics Simulations | 33

8 Error Handling | 34
8.1 µC Error Handling | 34
8.1.1 | Pseudo-Simultaneous Button Presses | 34
8.1.2 | Dangerous Physical Operation | 34
8.1.3 | Button Cooldown | 34
8.1.4 | Improper Shot Specifications | 34
8.2 PC Error Handling | 35
8.2.1 | Invalid Table State | 35
8.2.2 | Unsuccessful Shot Selection | 35
9 Communication Protocols | 35
9.1 µC - PC Controller | 35
9.2 PC VR - PC Controller | 35
9.3 Camera - PC Controller | 36
10 Scheduling of Tasks | 36
10.1 Allocation of Time | 36
10.2 Sequence Diagrams | 37

## List of Tables

1 | Revision History | | 3
2 | Definitions | | 6
3 | Acronyms and Abbreviations | | 6

## List of Figures

1 | System Block Diagram | | 4
2 | Use Case Diagram | | 7
3 | Sensor-Controller-Actuator Architecture | | 9
4 | PC VR Architecture | 11
5 | A state chart for the EventHandler module | 17
6 | A state chart for the TableStateVR module | 18
7 | A state chart for the InferenceEngine module | 20
8 | A state chart for the PCCommunicator module | 23
9 | A state chart for the Controller module | 25
10 | A state chart for the SensorMonitor module | 26
11 | A state chart for the ShotInterpreter module | 27
12 | A state chart for the µCCommunicator module | 28
13 | The system’s detailed class diagram | 29
14 | µC Program Uses Hierarchy Diagram | 30
15 | PC Controller Program Uses Hierarchy Diagram | 30
16 | PC VR Program Uses Hierarchy Diagram | 31
17 | Android Program Uses Hierarchy Diagram | 31
18 | µC Analysis Class Diagram | 32
19 | PC Controller Analysis Class Diagram | 32
20 | A sequence diagram for the “move” operation | 37
21 | A sequence diagram for the “cancel” operation | 37
22 | A sequence diagram for the “take shot” operation | 38

Date | Revision # | Comments | Authors
14/11/2016 | 0 | - High Level Design document creation | Eric Le Fort
28/11/2016 | 0 | - High Level Design first draft completion | Eric Le Fort
16/12/2016 | 0 | - Added System Block Diagram | Eric Le Fort
25/12/2016 | 0 | - Low Level Design document creation | Eric Le Fort
14/01/2017 | 0 | - Low Level Design first draft completion | Eric Le Fort
17/01/2017 | 0 | - Added Physics and Communication sections | Eric Le Fort
20/03/2017 | 1 | - Consolidated design document creation | Eric Le Fort

Table 1: Revision History

## 1 Introduction

This document’s purpose is to describe the architectural and low-level design of the software controlling the Autonomous Pool Playing Robot. Both the architecture for the encompassing system as well as architectures for distinct subsystems will be discussed. The purpose of this document will be to document the decisions made concerning the system’s design as well as provide enough detail so that the programming of the system can be as trivial as possible.

### 1.1 System Description

This system will provide a control system for an autonomous pool playing robot. It will include three separate computational units and four separate programs.

The first computational unit will be a camera (likely a camera phone). This device will be responsible for reacting to a request, taking an image and then relaying that image.

The next computational unit will be the PC. This device will have two separate programs that must execute for the system to be successful. One program will handle the VR and the other will handle shot selection as well as message passing between devices. The VR program will handle processing the image from the camera into a table state that can be used by the shot selection algorithm. The other program on the PC will handle performing an algorithm to determine which shot should be taken, where to move the cue in order to take that shot, instructing the camera to take pictures, receiving the image from the camera, receiving a signal to take a shot from the µC and communicating the shot that must be taken back to the µC.

The last computational unit, the µC, will be responsible for interpreting the shot instructions provided by the PC into signals to control the machine accordingly, receiving control signals from the system, providing signals to move the machine out of the way to predetermined locations when requested, and sending the signal to take a shot back to the PC.

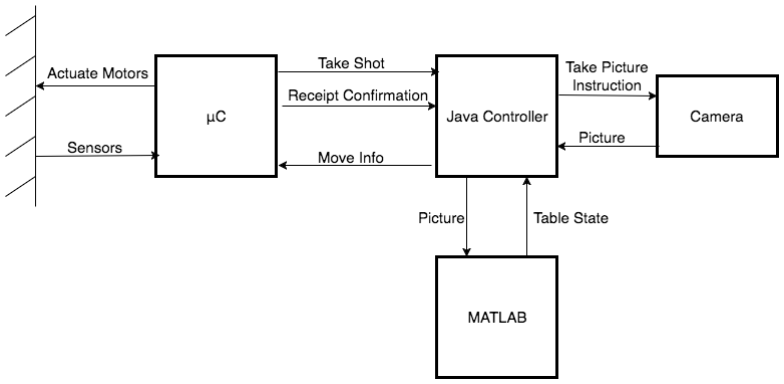
[picture p35: figure]

Figure 1: System Block Diagram

### 1.2 Overview

This document has nine sections not including this one. Each section contains either design diagrams or further explana-tions to further describe the architecture of this system and is intended to prepare the software team to implement the design.

- Use Cases: This section describes possible user interactions with the system as well as the intended results of those interactions through the use of simple diagrams. A Use Case Diagram is also provided for reference.
- Architectural Design: This section defines the overall system architecture as well as the architectures of all sub-programs. It will also discuss which components are likely to change in future versions.
- CRC Cards: Each program will be broken up into their specific classes. The responsibilities of each class as well as any collaboration required with other classes to fulfill each responsibility (if any) will be listed.
- Module Guide: This section will outline the responsibilities and secrets of each module as well as each module’s MIS and MID. Lastly, for each module, a state chart will be provided to illustrate the flow of that module.
- Program Diagrams: The section will provide a detailed class diagram to define the contents of each class in the program as well as uses hierarchy diagrams and analysis class diagrams for each program. The detailed class diagram will provide a breakdown of the contents of each class and program as well as how the various classes and programs are interconnected. The uses hierarchy diagrams will illustrate the hierarchy among the different programs, modules, and hardware. The analysis class diagrams define the various classes in each program, the direction of the flow of data between them, and their type (boundary, controller, or entity).
- Physics Simulations: This section will describe the method by which the pool table physics simulations will be performed as well as the various equations and constants involved.
- Communication Protocols: This section will describe inter-process communication protocols necessary in this system.
- Scheduling of Tasks: This section defines various timing constraints for various operations as well as sequence diagrams for the typical use cases.

### 1.3 Naming Conventions & Definitions

This section outlines the various definitions, acronyms and abbreviations that will be used throughout this document in order to familiarize the reader prior to reading.

### 1.3.1 Definitions

Table 2 lists the definitions used in this document. The definitions given below are specific to this document and may not be identical to definitions of these terms in common use. The purpose of this section is to assist the user in understanding the requirements for the system.

Table 2: Definitions

Term | Meaning
X-axis | Distance along the length of the pool table
Y-axis | Distance across the width of the pool table
Z-axis | Height above the pool table
End-effector | The end of the arm that will strike the cue ball
θ | Rotational angle of end-effector
Cue | End-effector
Personal Computer | A laptop that will be used to run the more involved computational tasks such as visual recognition and the shot selec-tion algorithm
Camera | Some form of image capture device (e.g. a digital camera, smartphone with a camera, etc.)
Table State | The current positions of all the balls on the table
Entity | Classes that have a state, behaviour and identity (e.g. Book, Car, Person, etc.)
Boundary | Classes that interact with users or ex-ternal systems
Double | Double-precision floating point num-bers

### 1.3.2 Acronyms & Abbreviations

Table 3 lists the acronyms and abbreviations used in this document.

Table 3: Acronyms and Abbreviations

Acronym/Abbreviation | Meaning
VR | Visual Recognition
PC | Personal Computer
µC | Micro-Controller
CRC | Class Responsibility Collaboration

## 2 Use Cases

This section will outline the use cases that this system will be expected to handle. A Use Case Diagram will also be provided to help illustrate these cases. All use cases are initiated by the user interacting with a physical interface that will send a signal to the µC. Between operations, the various programs will revert to a dormant state to await the next instruction.

### 2.1 Use Case Diagram

The following diagram depicts the use cases of this system.

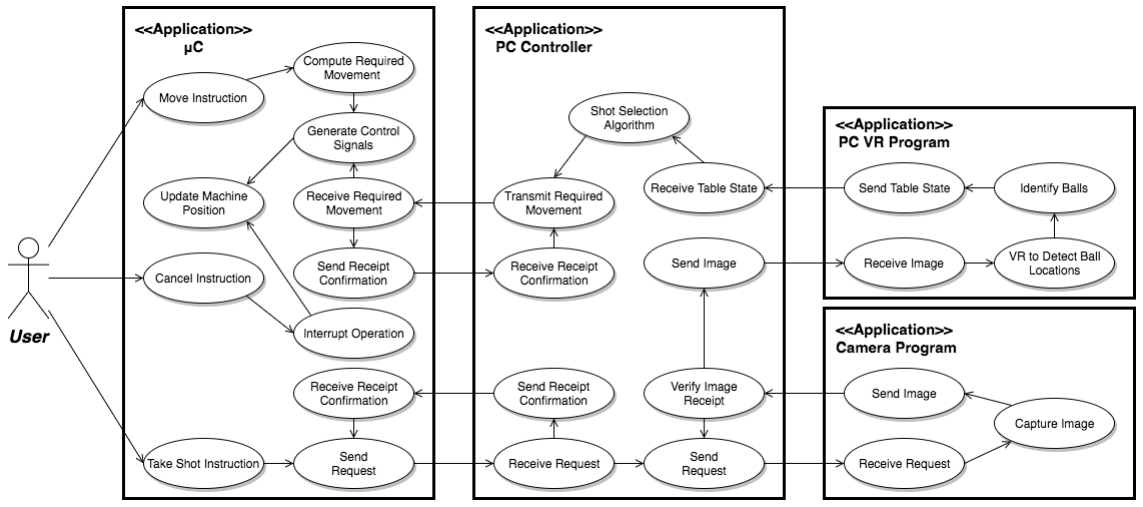
[picture p36: figure]

Figure 2: Use Case Diagram

### 2.2 Move Instruction

This use case involves only the µC. The user presses the move button. Once the signal has been received, the µC will decide which predetermined set point to move to based on the current position of the machine that is stored in its memory. The µC will then determine the signals required to relocate the machine to the appropriate location and then send them to the machine. Once those signals are sent, the µC will update its memory to store the new position of the machine.

### 2.3 Cancel Instruction

This use case involves only the µC. The user presses the cancel button. Once the signal has been received, the µC will immediately stop the machine’s motion. It will then update its memory to store the current position of the machine.

### 2.4 Take a Shot Instruction

This use case involves all four programs: the µC, the PC Controller Program, the Camera Program, and the PC VR Program in that order. The user presses the take a shot button. Once the signal has been received, the µC will send a request to the PC to begin its process and wait a small amount of time for the PC to send a receipt response. If the µC does not receive a response within the specified timeframe, it will resend its request. This process will be repeated until a response is received. The PC Controller Program will then send a signal to the camera to take a photo. Upon receiving this signal, the camera will take a picture of the table and send this back to the PC. If the picture was received correctly, the PC Controller Program will then start the PC VR Program and provide the picture to be used. Otherwise, the PC Controller Program will continue to resend the request to take a picture as necessary. The PC VR Program will utilize object detection to determine where the balls are on the table and which ball is which. Once collecting this information, it is provided to the PC Controller Program through an intermediate file. The PC Controller Program will then use its shot selection algorithm to determine how to strike the pool ball to take based on the table state provided and transmit that shot to the µC. After that, the µC will send a receipt signal back to the PC Controller Program. The µC will interpret the shot information to create an instruction set of signals to move the machine appropriately and take the shot.

### 2.5 Take a Shot Operation Interrupted During PC Computation

This use case involves all four programs: the µC, the PC Controller Program, the Camera Program, and the PC VR Program in that order. The user presses the take a shot button. Once the signal has been received, the µC will send a request to the PC to begin its process and wait a small amount of time for the PC to send a receipt response. If the µC does not receive a response within the specified timeframe, it will resend its request. This process will be repeated until a response is received. Sometime between this point and getting the selected shot communicated back to the µC, the user presses the cancel button. The PC will complete its normal operation but once the shot is communicated back to the µC, it will simply be ignored.

## 3 Architectural Design

This section will discuss the architectures that are to be used while designing this system. The goal of these architectures is to promote the overall quality of the software for this system. In particular, the software should be more efficient, robust, and maintainable as a result of this architectural design.

### 3.1 System Architecture

The architecture of this system as a whole will be modelled using the Batch Sequential style. This architecture involves sending chunks of data after each program is completely done processing and promotes simple division of subsystems that can operate as independent programs. This creates a strong separation of concerns within the larger system.

The shortcomings of this system are that it does not allow for concurrency and it has low throughput. Luckily, in this situation, the throughput is not intended to be very high. Also, each subsystem must wait for the previous system to fully complete its task in order to proceed regardless. Therefore, since this system does not even allow for concurrent operation, there is no loss in potential efficiency.

### 3.2 Subsystems

The subsystems will follow the batch sequential architecture on a system level but that architecture does not make sense for the subsystems themselves. This section will discuss the architectures that will be utilized on the subsystem level.

### 3.2.1 µC Architecture

This subsystem will utilize a Sensor-Controller-Actuator architecture style. This style is well-suited to embedded systems that deal with hardware which is optimal for this subsystem. The style breaks the subsystem up into four types of components: interfaces, sensors, actuators, and a controller. An illustration of the architecture is provided below:

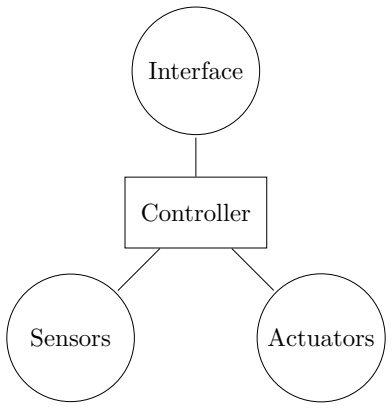
[picture p37: figure]
Controller; Interface; Sensors; Actuators

Figure 3: Sensor-Controller-Actuator Architecture

In the case of this subsystem, the breakdown of the components into these types will be as follows:

- Sensors - System State

– Calibration sensors (quantity yet to be determined)

- Sensors - Interface

– Stop buttons (multiple located throughout machine, quantity yet to be determined)

– Move button

– Take shot button

- Logic

– Motion logic

– Current state info

- Actuators

– Translational motors (×2)

– Rotational motor

– Pneumatic end-effector

### 3.2.2 PC Controller Architecture

This subsystem will utilize a Rule-Based architecture style. This style is well suited to making strategic moves while playing a game with rigid rules constraining actions. In other words, for deciding which shot is the best to take given the current state of table and the rules of the game of pool. This style breaks down the subsystem into four types of modules: an interface, a rule-set, working memory, and an inference engine. The interface will be where the system gets its input and sends its output. The rule-set is a particular sort of knowledge base that contains the rules constraining the acceptable actions. The working memory is temporary memory used by the subsystem. Lastly, the inference engine is what ties the subsystem together. Its job is to apply the rules appropriately and, using the working memory as a tool, generate the appropriate result to send as output.
In the case of this subsystem, the breakdown of these modules into these types will be as follows:
- Interface

– Input – table state
– Output – specification of shot (position, angle, and force)
- Rule-Set

– Rules of pool

– Mechanical constraints
– Physical constants (i.e. ball weight, table friction, spring constant of table cushions, etc.)
- Working Memory

– Table state

– Current optimal shot

- Inference Engine

– Simulate results of shots

– Check rules against shot simulations at some incremental angle

– Score shots based on weighted application of rules

### 3.2.3 Camera Architecture

This subsystem will utilize an Event-Driven architectural style. This will likely be the simplest subsystem present in the system. The role of this program is to sit idle waiting for a request to take a picture. Once it receives that request, it should take a picture and then communicate that image back to the PC Controller program. This request is the only event this program must respond to.

### 3.2.4 PC VR Program Architecture

This subsystem will also utilize a Batch Sequential architecture style. This style has already been discussed in the system architecture and so will not be discussed again here. In this subsystem, the process is begun upon receipt of the request to start operation. The subsystem will then utilize a VR library to detect the balls as objects on the table using the image provided. The results of this will be passed to the next step which will use the positions of the identified objects to determine which specific ball is which using colour comparison. Once this step completes, the table state has been computed and is then sent back to the PC Controller program. The issues of low throughput and lack of concurrency are not an issue in this case as the system would have to wait for the previous step to complete in order to begin the next step anyway.

An illustration of the specific implementation of this architecture is provided below:

in image
−−−−→ object detection

image &
object positions
−−−−−−−−−−→ ball identification table state −−−−−−−→ out

Figure 4: PC VR Architecture

### 3.3 Likely Changes

Due to the nature of this project and the condensed time frame in which the development team must produce a prototype, certain aspects in this document are likely to change. Firstly, regarding the physics engine, various physical constants require the system be complete in order to be accurately measured. Currently, any marked TBM are filled with estimated “placeholder” values. Also, the method of determining the parallel velocity component after a ball-wall collision should be improved. Secondly, regarding inter-program communication, either a module to adapt given the user’s internet settings or a different method of communication would likely be necessary to improve the modularity of the system.

## 4 Class Responsibility Collaboration (CRC) Cards

This section provides CRC cards for all classes in each of the programs. Each card will list the responsibilities as well as any classes the must be collaborated with to perform that responsibility.

### 4.1 µC CRC Cards

The following are the CRC cards for the µC program:

SensorMonitor

Responsibilities | Collaborators
- Sensing signals from buttons - Sensing signals from calibration sensors | (None) (None)

Communicator

Responsibilities | Collaborators
- Send shot calculation request to the PC Controller Program - Receive request receipt confirmation from PC Controller Program - Send shot receipt confirmation to PC Controller Program - Receive shot specification from PC Controller Program | Communicator (PC) Communicator (PC) Communicator (PC) Communicator (PC)

SignalGenerator

Responsibilities | Collaborators
- Control translational motors - Control rotational motor - Control pneumatic end-effector | Shot Interpreter Shot Interpreter Shot Interpreter

ShotInterpreter

Responsibilities | Collaborators
Translate shot instruction into list of appropriate signals | State, Communicator (µC)

State

Responsibilities | Collaborators
Store and allow access to data regarding the current physical position of the machine | Communicator (µC)

Controller

Responsibilities | Collaborators
Interrupt operation if that instruction is received Control flow of program operation | SensorMonitor (None)

### 4.2 PC Controller CRC Cards

The following are the CRC cards for the PC Controller program:

Communicator

Responsibilities | Collaborators
- Listens for request from µC - Sends confirmation of receipt to µC - Sends shot specification to µC - Listen for receipt confirmation from µC - Sends image capture request to camera - Listens for response from camera - Initiate the PC VR program - Read table state from file | Communicator (µC) Communicator (µC) Communicator (µC), Shot, Vector Communicator (µC) EventHandler EventHandler (None) (None)

Vector

Responsibilities | Collaborators
- Stores and allows access to an x- and y-component of a vector | (None)

Ball

Responsibilities | Collaborators
- Store and allow access to its position - Store and allow access to the value representing its identity | Vector (None)

Shot

Responsibilities | Collaborators
- Store and allow access to the position from which to take this shot - Store and allow access to the angle from which to take this shot - Store and allow access to the amount of power to use to take this shot - Store and allow access to the scoring assigned to this shot | Vector (None) (None) (None)

TableState

Responsibilities | Collaborators
- Store and allow access to the positions of the balls present on the table - Store and allow access to the number of both types of ball on the table | Ball, Vector Ball

SimulationInstance

Responsibilities | Collaborators
- Maintain the positions and velocities of balls on the table at the current time step - Update the positions and velocities of balls after one time step - Keep track of whether there is still movement occurring - Keep track of the scoring of the simulation (of a shot) | TableState, Vector TableState, Vector Vector TableState

InferenceEngine

Responsibilities | Collaborators
- Calculate the shot to be made | SimulationInstance, TableState, Shot, Vector

### 4.3 Camera CRC Cards

The following is the CRC card for the Camera program:

Event Handler

Responsibilities | Collaborators
- Listen for request from PC Controller - Take a photo - Communicate the photo | Communicator (PC) (None) Communicator (PC)

### 4.4 PC VR Program CRC Cards

The following is the CRC card for the PC VR program:

TableStateVR

Responsibilities | Collaborators
- Read image from a file - Locate balls using VR - Determine ball identities - Write table state to a file | (None) (None) (None) (None)

## 5 Module Guide

This section discusses the various modules that this system is comprised of. The modules are divided based on which program they belong to. For each module, its responsibilities, secrets, MIS, and MID will be outlined.

### 5.1 Camera Modules

The following is the module contained within the Camera subsystem.

### 5.1.1 EventHandler

Responsibilities

- Listen for request from PC Communicator
- Take a photo
- Communicate photo to PC Communicator

Secrets

- Picture-taking process

MIS

This module is an always-running program which executes the function of taking a picture and communicating it back to the requesting program. It’s only “input” is the request to take a picture. While this module is not performing the previous function, it will be listening for a request to be made.

MID

The state chart below provide a succinct depiction of this module’s internal design.

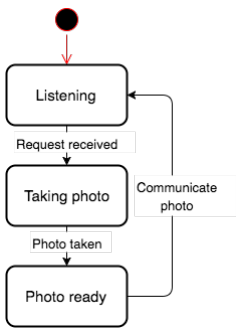
[picture p38: figure]

Figure 5: A state chart for the EventHandler module.

### 5.2 PC VR Program Modules

The following is the module contained within the PC VR subsystem.

### 5.2.1 TableStateVR

Responsibilities

- Read image from a file
- Locate balls using VR
- Determine ball identities
- Write table state to a file

Secrets

- Object detection algorithm
- Ball identification algorithm

MIS

This module takes in an image of a pool table and analyzes it in order to return the locations and identities of each of the pool balls on the table. This is returned in the form of an output file where the nth line contains the x- and y-coordinates for the nth ball.

MID

This module has 4 main steps. First it must read in the image from a predetermined file location. Then it locates the pool balls in that picture using a Visual Recognition object detection algorithm (supplied by a VR library). Next, it will identify which ball is which according to comparing pixel colours within the detected objects to the colours of different pool balls using a LAB colour space. Lastly it will write these results to a file.

The following pseudocode better describes this process:

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

r e t u r n r e s u l t s ;

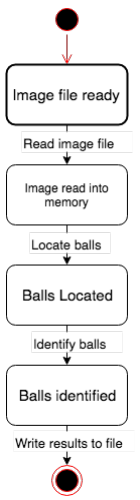
[picture p39: figure]

Figure 6: A state chart for the TableStateVR module.

### 5.3 PC Controller Modules

The following are the modules contained within the PC Controller subsystem.

### 5.3.1 InferenceEngine

Responsibilities

- Calculate the best shot to be made

Secrets

- Algorithm to choose which shots to simulate
- The computer’s ball type (i.e. stripes or solids)
- The rules of pool

MIS

This module allows for specification of a TableState through the use of a 2-D array of doubles. Using that TableState, the module will simulate various potential shots in order to determine an optimal one which is then accessible to other classes in the form of a Shot object.

MID

This module iterates through shots that are to be simulated by SimulationInstances. In order to minimize computation, it only looks at shots that have a hope of directly hitting another legal ball (e.g. the eight ball cannot be struck first unless all of the player’s other balls are already sunk). Furthermore, it is assumed that there will only be three discrete power options available to select from. At the end of this computation, this module returns the specification of the optimal shot.

The following pseudocode better describes this process:

de te rmine b a l l s t o s h o o t ;

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

w hil e ( sim ul a ti o n not f i n i s h e d ){
sim ul a ti o n . update ( ) ; }

update c u r r e n t shot ’ s s c o r e ;

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

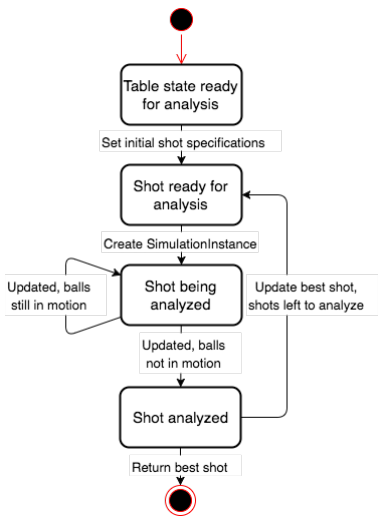
[picture p40: figure]

Figure 7: A state chart for the InferenceEngine module.

### 5.3.2 PCCommunicator

Responsibilities

- Listens for request from µC
- Sends confirmation of receipt to µC
- Sends shot specification to µC
- Listens for confirmation of receipt from µC
- Sends image capture request to camera
- Listens for response from camera
- Initiate the PC VR program
- Read table state from file

Secrets

- Receipt confirmation message contents
- Maximum time awaiting a response

MIS

This module is an always-running process which communicates with the various programs in this system while also providing control flow for the PC Controller program. The only “inputs” it receives is requests from the µC program and its “output” is the shot specification

MID

The state charts below provide a succinct depiction of this module’s internal design.

### 5.3.3 SimulationInstance

Responsibilities

- Maintain the positions and velocities of the balls on the table at the current time step
- Update the positions and velocities of the balls on the table after a time step
- Keep track of whether there is still movement happening
- Keep track of the scoring of the simulation (of a shot)

Secrets

- The method of calculating a shot’s score
- Shot simulation algorithm
- Physical constants
- Simulation time step

MIS

This module handles the physics simulation involved with taking a shot while also scoring the shot according to various criteria. It receives a 2-D array of doubles as ball positions, a double for the angle of the shot, and a double for the power of the shot. These inputs define the initial state of the physical system to simulate. The state is updated for a new time step by calling the appropriate command and an integer representing the resulting change in score from that time step is returned. The Once it returns false, there is no further motion and the simulation is complete.

MID

This module handles performing a discrete time step simulation of a shot according to a shot and initial state of the table. In order to achieve this, it updates to the next snapshot of the simulation until every ball remaining on the table is stationary.

First, the following pseudocode describes how this object is created:

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

inMotion = t r u e ;
s c o r e = 0 ;

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

The following pseudocode assumes a very fine time step but may not not be feasible given the imposed time constraints (which will be tested empirically):

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

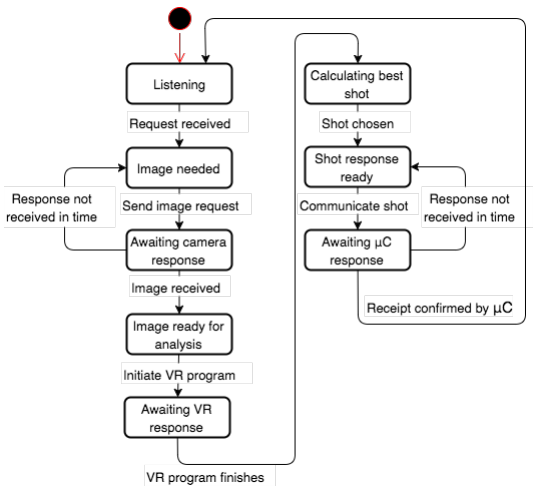
[picture p41: figure]

Figure 8: A state chart for the PCCommunicator module.

### 5.4 µC Modules

The following are the modules contained within the µC subsystem.

### 5.4.1 Controller

Responsibilities

- Control flow of program operation
- Interrupt operation if cancel instruction is received

Secrets

- Set movement positions (for “move” commands)
- Instruction dispatch process

MIS

This module handles the control flow for the µC Program including determining appropriate movement and creation of interrupts when necessary. Its “inputs” are when it is notified of state changes such as button presses or position updates from the Sensor Monitor or Signal Generator modules as well as shot specifications (doubles holding the x- and y-coordinates, angle, and power) from the Communicator. Its “outputs” are sending the shot request to the Communicator as well as passing on the shot specification to the Signal Generator.

MID

The state chart below provides a succinct depiction of most of this module’s internal design. The only other notable component in this module is how it selects where to move when a “move” command is received. In that event, it compares the current location to the two set locations at either end of the table. Whichever one is furthest is the one which the machine is moved towards. This is designed in a way such that the machine moves as far away as possible from where it was in the way of the user.

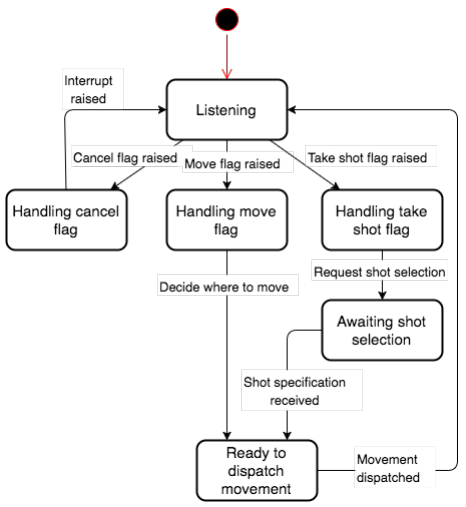
[picture p42: figure]

Figure 9: A state chart for the Controller module.

### 5.4.2 SensorMonitor

Responsibilities

- Sensing signals from buttons
- Sensing signals from calibration sensors

Secrets

- The method of noticing signals

MIS

This module monitors the control signals coming from the buttons and calibration sensors and notifies the Controller when one of these sensors are activated. It’s “inputs” are the control signals and its “outputs” are flags that are raised.

MID

The state chart below provides a succinct depiction of this module’s internal design.

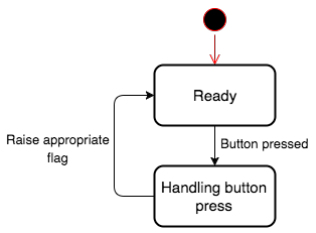
[picture p43: figure]

Figure 10: A state chart for the SensorMonitor module.

### 5.4.3 ShotInterpreter

Responsibilities

- Translate shot instruction into list of appropriate signals
- Control translational motors
- Control rotational motor
- Control pneumatic end-effector

Secrets

- Algorithm to determine appropriate movement
- Method of transmitting signals to machine

MIS

This module receives a shot specification (doubles holding the x- and y-coordinates, angle, and power) in order to compute and generate the signals necessary to have the machine perform the required motion. It’s “outputs” are the control signals that it generates.

MID

The state chart below provides a succinct depiction of this module’s internal design.

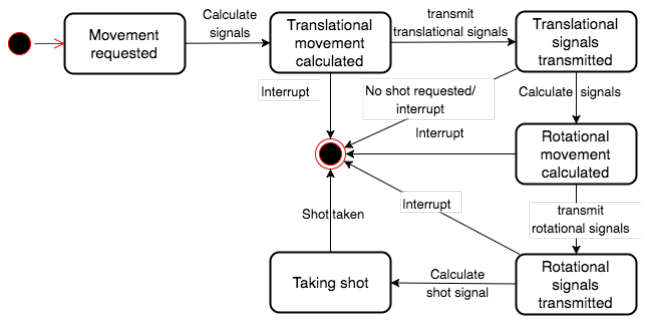
[picture p44: figure]

Figure 11: A state chart for the ShotInterpreter module.

### 5.4.4 µCCommunicator

Responsibilities

- Send shot calculation request to the PC Controller program
- Receive confirmation of receipt from PC Controller program
- Receive shot specification from PC Controller program
- Send confirmation of receipt to PC Controller program

Secrets

- Receipt confirmation message contents
- Maximum time awaiting a response

MIS

This module handles communicating with the PC Controller Program in order to compute the optimal shot to take. It’s “inputs” are the request from the Controller and the shot specification (doubles holding the x- and y-coordinates, angle, and power) from the PC. It then passes that shot specification on to the Controller.

MID

The state charts below provide a succinct depiction of this module’s internal design.

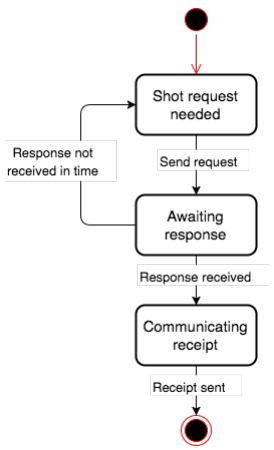
[picture p45: figure]

Figure 12: A state chart for the µCCommunicator module.

## 6 Program Diagrams

### 6.1 Detailed Class Diagram

(found on the next page)

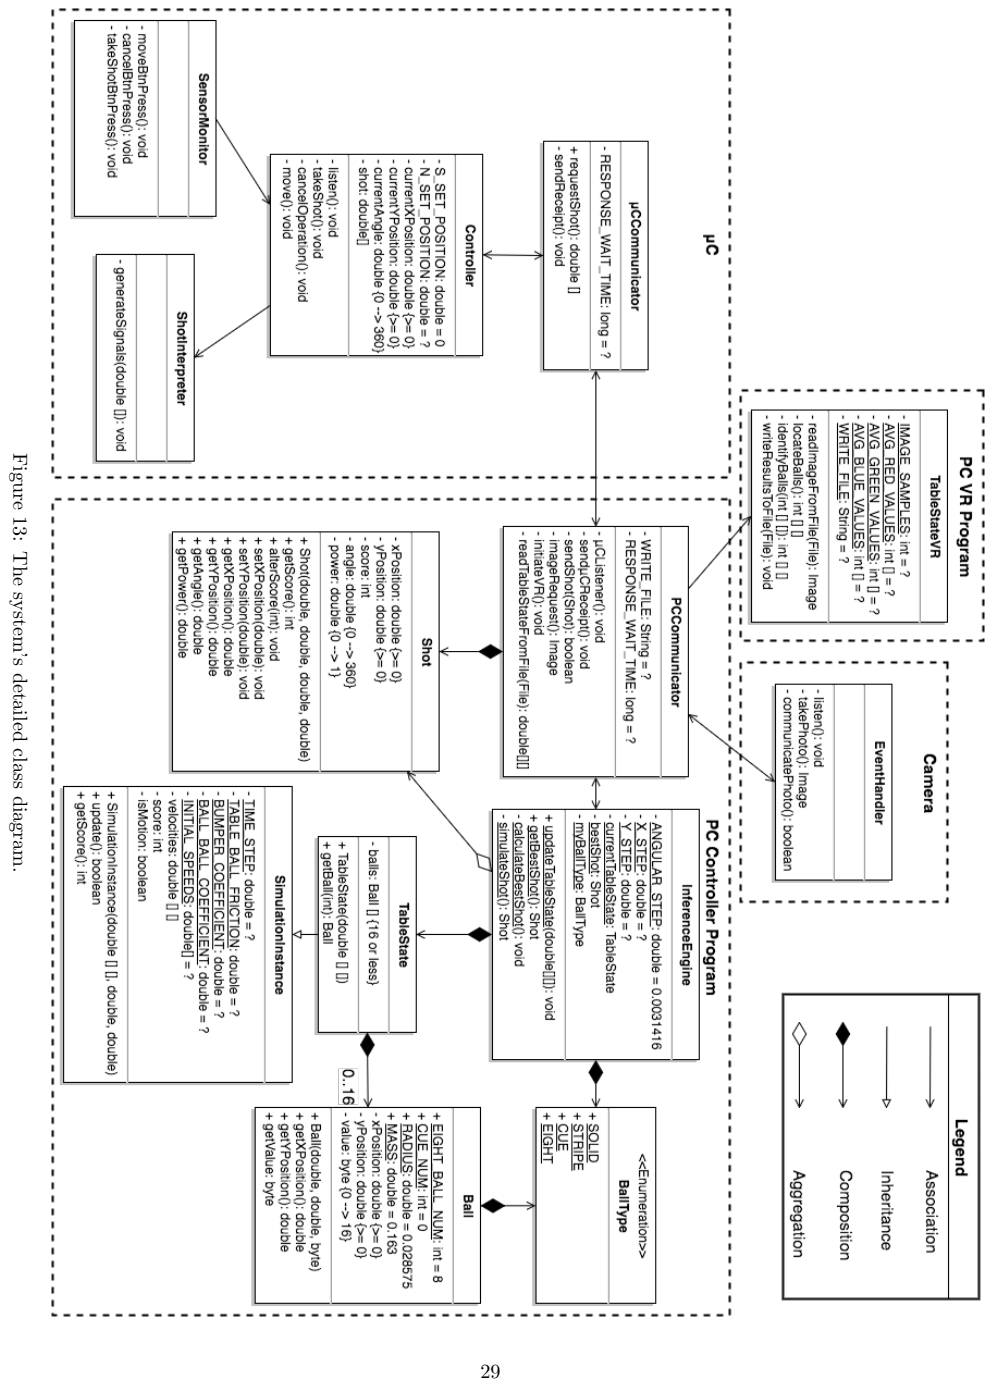
[picture p46: page 30]

Figure 13: The system’s detailed class diagram.

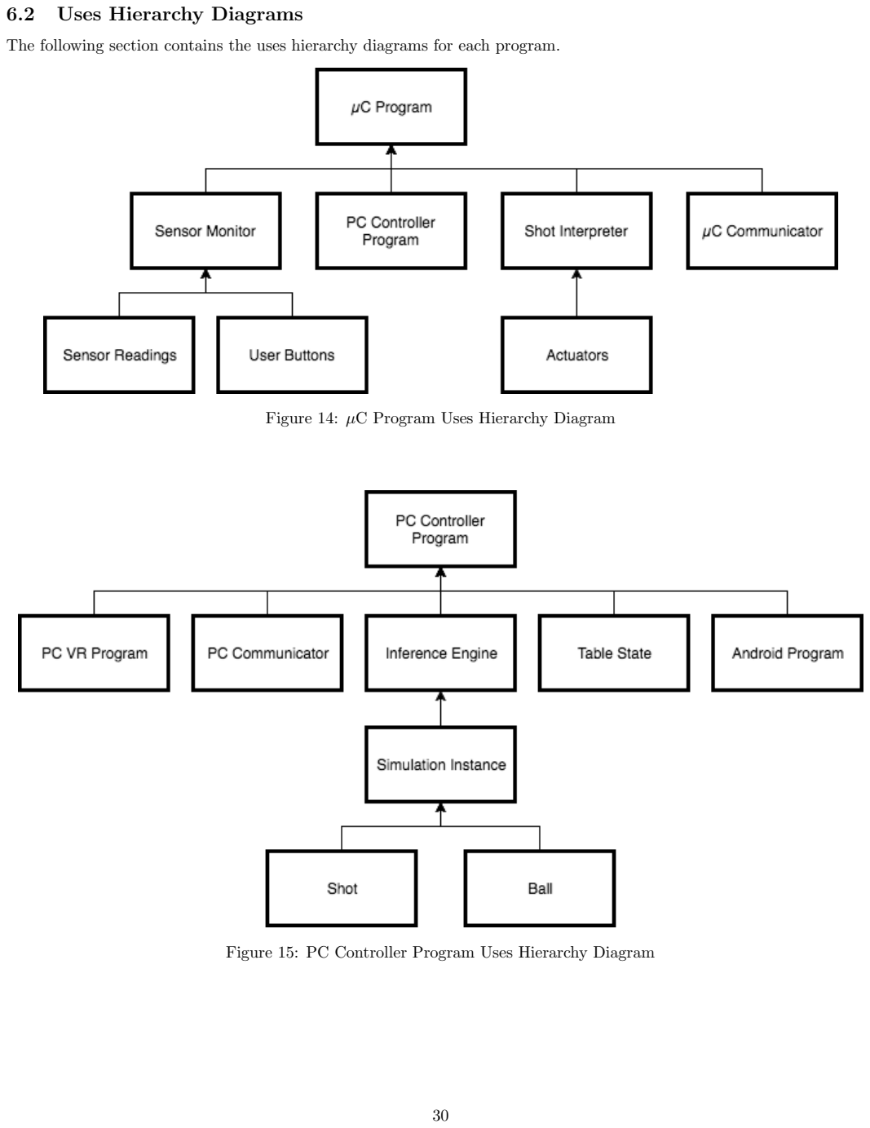
[picture p47: page 31]

### 6.2 Uses Hierarchy Diagrams

The following section contains the uses hierarchy diagrams for each program.

Figure 14: µC Program Uses Hierarchy Diagram

Figure 15: PC Controller Program Uses Hierarchy Diagram

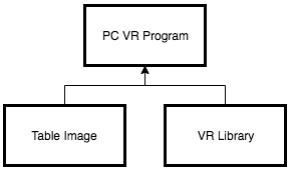
[picture p48: figure]

Figure 16: PC VR Program Uses Hierarchy Diagram

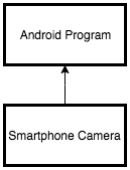
[picture p49: figure]

Figure 17: Android Program Uses Hierarchy Diagram

### 6.3 Analysis Class Diagrams

The following section contains the analysis class diagrams for the µC and the PC Controller program. The PC VR program and Camera are not complicated enough to require the inclusion of these diagrams.

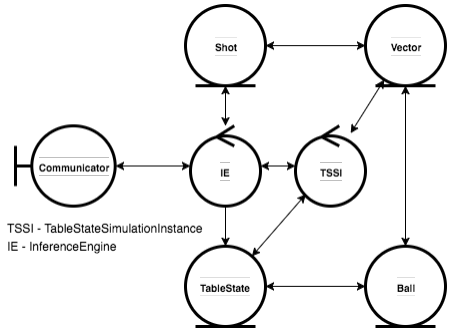
[picture p50: figure]

Figure 18: µC Analysis Class Diagram

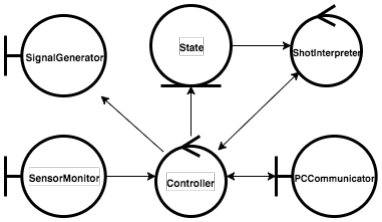
[picture p51: figure]

Figure 19: PC Controller Analysis Class Diagram

## 7 Physics Simulations

A substantial component of this system will be the ability to simulate and score a shot. Scoring will be determined by which balls are sunk (if any).

### 7.1 Constants

The following constants will be used by this system’s simulation engine. Certain values must be measured empirically and will be marked To Be Measured (TBM). All values will be in standard SI units.

Constant | Description | Value
CRb | Coefficient of Restitution, ball - ball | 0.96
CRw | Coefficient of Restitution, ball - wall | 0.866
g | Gravitational Acceleration | 9.807
vi1 | Initial Speed, soft hit | TBM
vi2 | Initial Speed, medium hit | TBM
vi3 | Initial Speed, hard hit | TBM
µk | Kinetic Friction, ball - cloth | TBM
mb | Mass, ball | 0.163
vsink | Maximum Speed to Sink Ball | TBM
xmax | Maximum x-coordinate | 1.848
ymax | Maximum y-coordinate | 0.921
rball | Radius (ball) | 0.0286
µs | Static Friction, ball - cloth | TBM
T | Time Step | 0.01
wc | Width, mouth of corner pocket | 0.1
ws | Width, mouth of side pocket | 0.114

### 7.2 Equations

The program will utilize the following equations to predict the evolution of the simulation.

Ball - Ball Collision

vaf =

CRbmb(vai − vbi

) + mavai + mbvbi
ma + mb

Since the masses are equivalent, this simplifies to..

vaf =

1
2

## (CRb

(vbi − vai

) + vai + vbi

) | (1)

Ball - Wall Collision (perpendicular component)

vf = −CRw vi | (2)

Ball - Wall Collision (parallel component)

Currently, this equation will not affect the velocity of the balls however this is just a simplification and is likely to be altered.

vf = vi | (3)

Ball Velocity Update

vf = vi

- µk · T | (4)

Ball Position Update
df = di + vT | (5)

## 8 Error Handling

This section will define how dangerous and/or erroneous operation will be handled. Any errors will be handled by the µC or the PC as appropriate. Any dangerous errors in the camera operation or in the VR program can be handled safely once the PC receives them. Errors such as incomplete image capture or an incorrect object detection would be very hard to detect and are not safety critical so they will be ignored at runtime. Obviously errors of this nature will hopefully be minimized if discovered during the testing phase.

Furthermore, both the µC and the PC rely on several different inter-program communications and so if any given process takes longer than the allowable timeout, the request will just be resent. If five unsuccessful requests are sent in a row, the system will cease attempting and the user will be notified of the issue.

### 8.1 µC Error Handling

### 8.1.1 Pseudo-Simultaneous Button Presses

In the case that multiple buttons are pressed before the software can register which was first (i.e. two or more flags are raised at a scheduled check), both flags will be reset and no operation will be performed. This will prevent accidental operation. However, if one of those flags is the cancel flag, that command will still be registered. In order to make the user aware of this functionality, it shall be described in the user manual.

### 8.1.2 Dangerous Physical Operation

In case of unsafe physical operation, stop buttons will be provided in strategic locations on the machine (as detailed in the hardware documentation). Before any step is signalled in the motors, the cancel flag is checked and if it has been raised the machine will not take another step until further commands are received.

### 8.1.3 Button Cooldown

To prevent accidental button presses, once the cancel button has been pressed, the system will wait a moment before accepting a new command. This allows the user to blindly activate the cancel button safely in the case of strenuous circumstances.In order to make the user aware of this functionality, it shall be described in the user manual.

### 8.1.4 Improper Shot Specifications

If a shot specification contains coordinates that are not reachable, an angle that is not between 0 and 2π, or a power that is not one of the allowed options, the µC will not attempt the shot. The user will be notified of this error.

### 8.2 PC Error Handling

### 8.2.1 Invalid Table State

It is possible that the camera will have returned an unusable image or perhaps the VR algorithm cannot correctly locate the balls on the table. In such a case where too many balls are found, if no balls are found, or if balls are found in impossible locations (such as off the table or excessively on top of another ball), the user will be notified of the error. The user will be provided troubleshooting instructions in the user manual such as ensuring there is sufficient lighting, there are no obstructions in the camera’s line of sight, that there are no balls in the camera’s line of sight but off the table, and so on. If none of these correct the issue, it is likely that the system cannot handle the specific case and must be improved when possible.

### 8.2.2 Unsuccessful Shot Selection

If the shot selection algorithm is unable to select a shot to make for whatever reason, the PC will simply not respond to the µC. The µC already operates upon a timeout system and so it can continue its normal operation. The user will be notified of this error and informed that they can press the cancel button in order to prematurely stop the process. This functionality should also be described in the user manual.

## 9 Communication Protocols

This section will outline the protocols used for communicating between the various devices and programs within this system. This is crucial as the different programs will rely on standard formats in order to understand the contents of messages.

### 9.1 µC - PC Controller

These programs must both be able to communicate message receipts, the µC must be able to make a shot request to the PC Controller, and the PC Controller program must be able to send shot specifications back to the µC. The receipts will be very simple messages, just containing an unsigned integer byte with the value 200. The shot request will also be an unsigned integer byte holding the value 55. Lastly, the shot specification will be sent as follows:

170, x, y, angle, power

where the number 170 is stored as an unsigned integer byte, x and y are the coordinates for the shot in double-precision floating point (8 bytes), angle is the angle of the shot in double-precision floating point, and power is the power of the shot stored in a single byte (either 1, 2, or 3).

The various numbers at the beginning of messages act as both checksums and indicators of the message’s contents. The numbers were chosen purposefully in a manner such that they have very different one byte binary representations (they share at most 4 common digits).

Communication will occur wirelessly using either bluetooth or Wi-Fi as determined by availability of hardware and software resources.

### 9.2 PC VR - PC Controller

The PC VR program must be able to communicate the table state to the PC Controller. This will be accomplished by writing results to a file with the following format:

Cue Ball x-coordinate, Cue Ball y-coordinate 1 Ball x-coordinate, 1 Ball y-coordinate 2 Ball x-coordinate, 2 Ball y-coordinate .
15 Ball x-coordinate, 15 Ball y-coordinate

where each set of coordinates is separated by a newline character and there are exactly 16 lines.

### 9.3 Camera - PC Controller

The PC Controller must be able to request a picture be taken and the camera must be able to communicate the image back to the PC Controller. Similar to the protocol between the µC and the PC Controller, the request will be a single unsigned integer byte holding the value 55 and the image data being sent will be preceded by a single unsigned integer byte holding the value 170. As mentioned previously, these values will act as checksums.

## 10 Scheduling of Tasks

The goal of this section is to outline the ordering and maximum allowable time frames of tasks in this program.

### 10.1 Allocation of Time

From the requirements document, there is only 90 seconds allowed between pressing a button and a shot being made. The most difficult computational step will be the shot simulations and so this section will deduce how much time the machine will have for that step.

Firstly we must account for how long the physical machine would need in the worst case (moving all the way across both axes and rotating 180 degrees). To be fair, we will allocate 20 seconds to this operation.

From here we can divvy up the remaining time among the various computational blocks. The smaller tasks such as communication, recognizing the button press, and other such operations will be allocated a total of 5 seconds. The process of object detection and identification will be given 15 seconds. This leaves 50 seconds to process the necessary simulations.

### 10.2 Sequence Diagrams

The following are various sequence diagrams for different actions the system is required to perform. These diagrams are meant to provide better context for how the classes interact with each other to perform certain tasks.

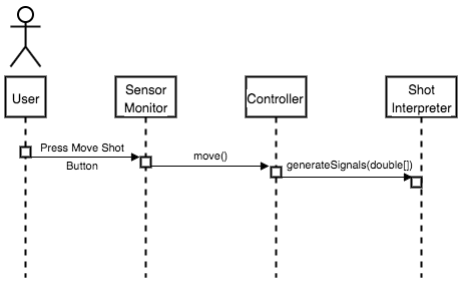
[picture p52: figure]

Figure 20: A sequence diagram for the “move” operation.

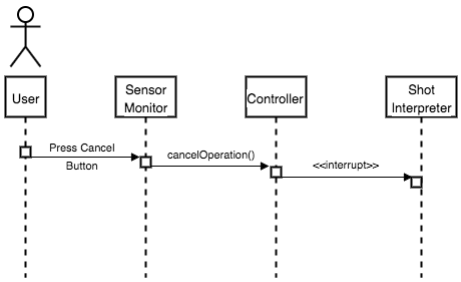
[picture p53: figure]

Figure 21: A sequence diagram for the “cancel” operation.

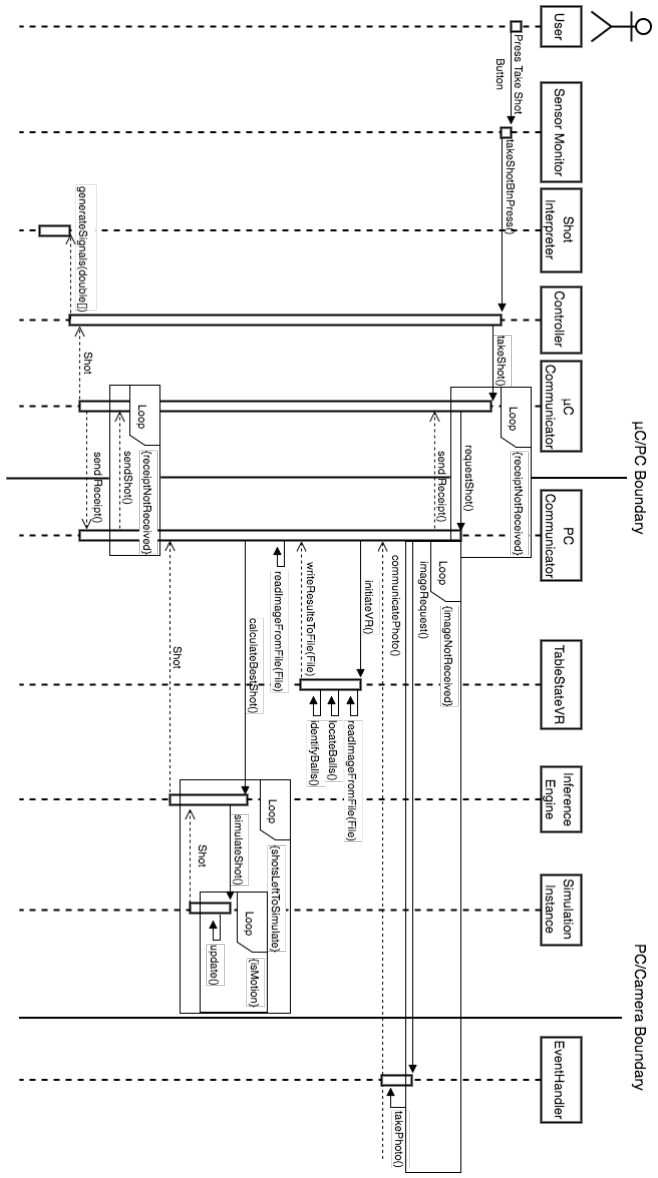
[picture p54: figure]

Figure 22: A sequence diagram for the “take shot” operation.
