EricLeFort/Capstone-Project/doc/CAD/Drawings/PDFs/EE_base_laser_cut.pdf

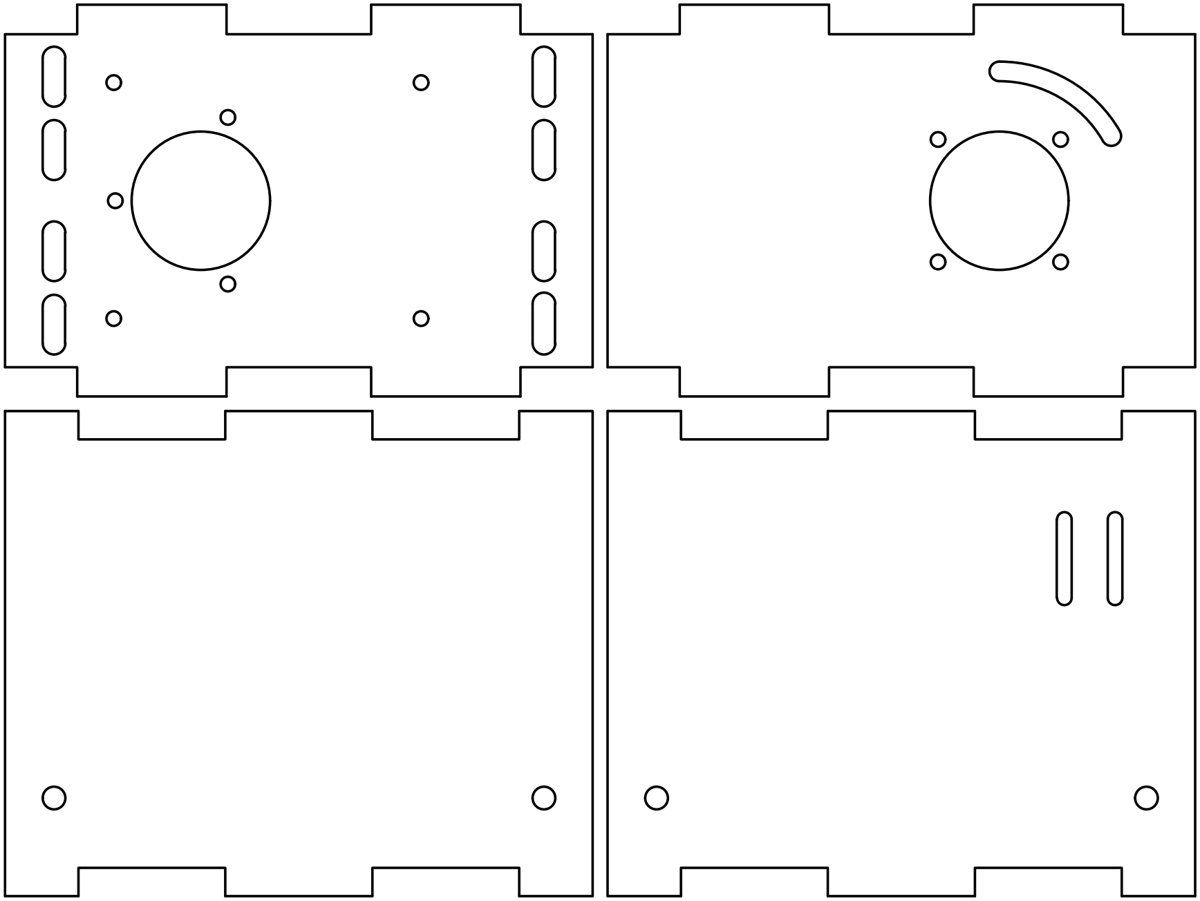
[picture p65: figure]
