EricLeFort/Capstone-Project/doc/CAD/Stepper Motor/NEMA 23/IMG_2020.JPG

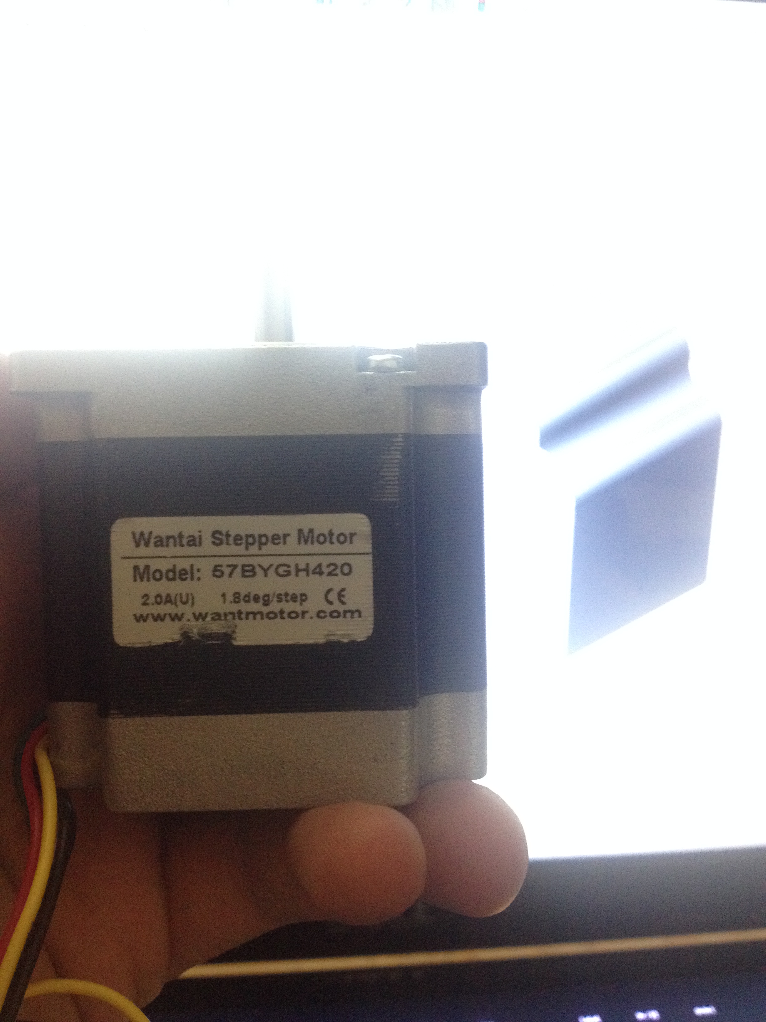
doc/CAD/Stepper Motor/NEMA 23/IMG_2020.JPG
