EricLeFort/Capstone-Project/doc/CAD/Stepper Motor/NEMA 23/NEMA23.png

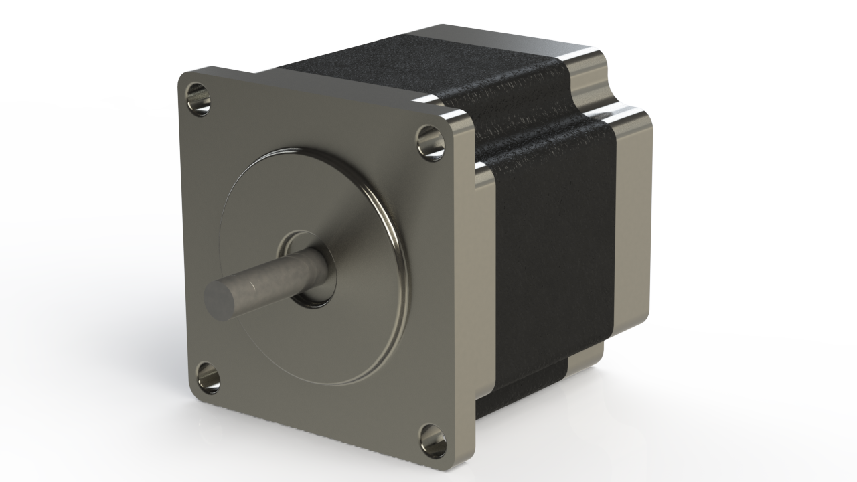
doc/CAD/Stepper Motor/NEMA 23/NEMA23.png
