EricLeFort/Capstone-Project/doc/HardwareDesign/fullDesign/img/exploded/sm2_exploded.PNG

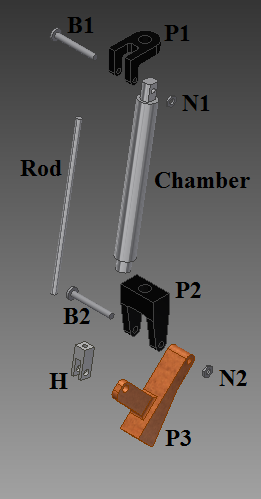
doc/HardwareDesign/fullDesign/img/exploded/sm2_exploded.PNG
