EricLeFort/Capstone-Project/doc/HardwareDesign/fullDesign/img/exploded/X_Rail/Arm_base__arm__xrail_exploded.PNG

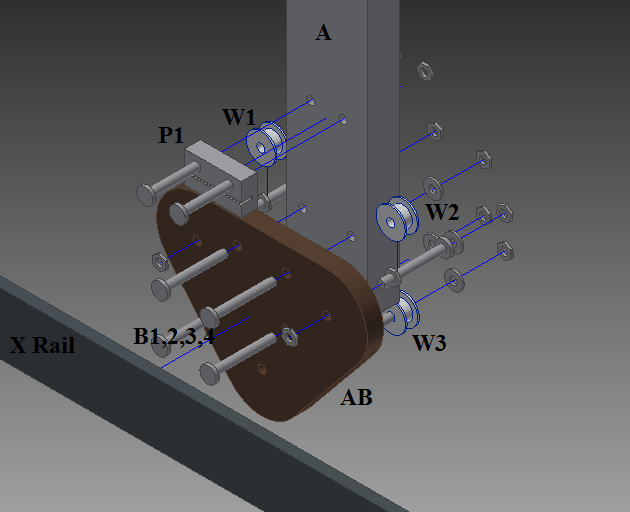
doc/HardwareDesign/fullDesign/img/exploded/X_Rail/Arm_base__arm__xrail_exploded.PNG
