EricLeFort/Capstone-Project/doc/HardwareDesign/fullDesign/img/exploded/X_Rail/Arm_base__yrail_exploded.PNG

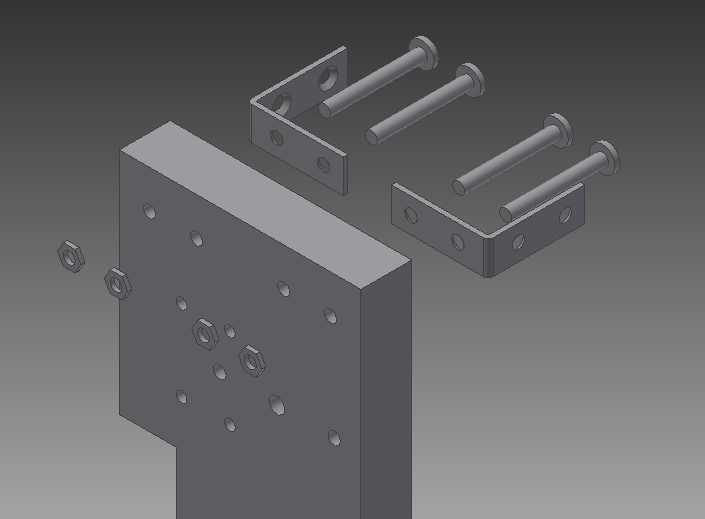
doc/HardwareDesign/fullDesign/img/exploded/X_Rail/Arm_base__yrail_exploded.PNG
