EricLeFort/Capstone-Project/doc/HardwareDesign/fullDesign/img/exploded/X_Rail/Pulley_holder_exploded.PNG

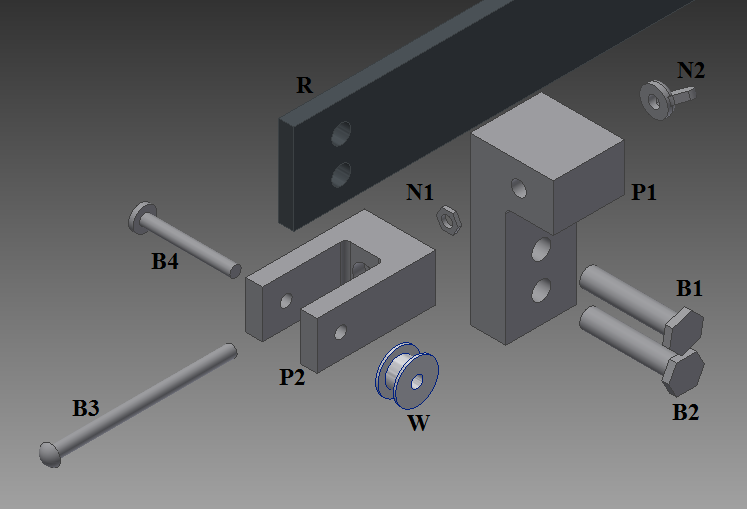
doc/HardwareDesign/fullDesign/img/exploded/X_Rail/Pulley_holder_exploded.PNG
