EricLeFort/Capstone-Project/doc/HardwareDesign/fullDesign/img/exploded/Y_Rail/yrail_standard.PNG

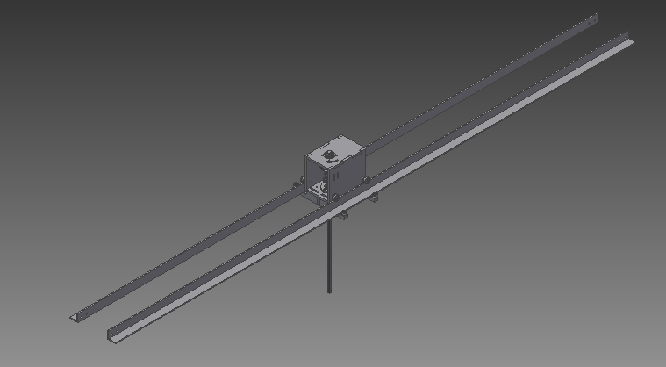
doc/HardwareDesign/fullDesign/img/exploded/Y_Rail/yrail_standard.PNG
