EricLeFort/Capstone-Project/doc/HardwareDesign/fullDesign/img/piston_visual.gif

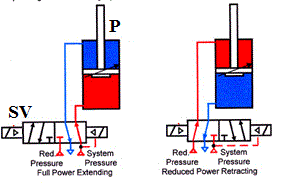
doc/HardwareDesign/fullDesign/img/piston_visual.gif
