EricLeFort/Capstone-Project/doc/HardwareDesign/fullDesign/img/shooting_mechanism_full.png

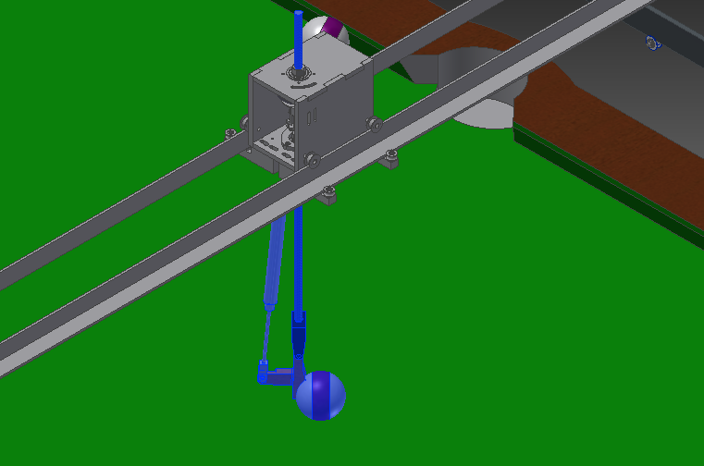
doc/HardwareDesign/fullDesign/img/shooting_mechanism_full.png
