EricLeFort/Capstone-Project/doc/HardwareDesign/fullDesign/img/sm2_standard.png

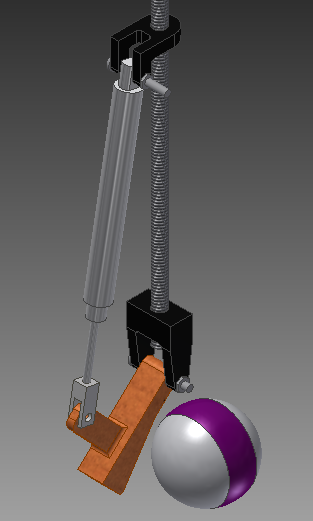
doc/HardwareDesign/fullDesign/img/sm2_standard.png
