EricLeFort/Capstone-Project/doc/HardwareDesign/fullDesign/img/system.png

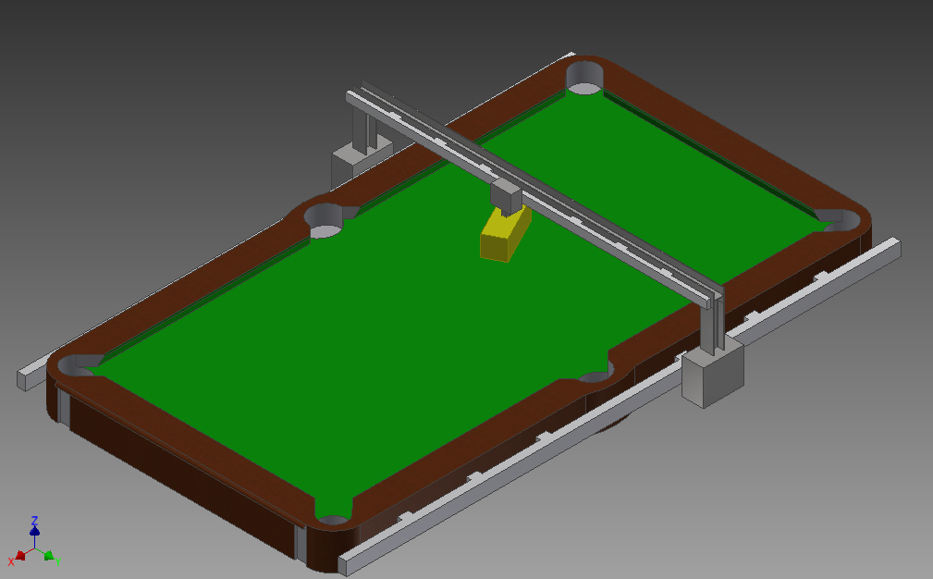
doc/HardwareDesign/fullDesign/img/system.png
