EricLeFort/Capstone-Project/doc/HardwareDesign/fullDesign/img/xrail_full.png

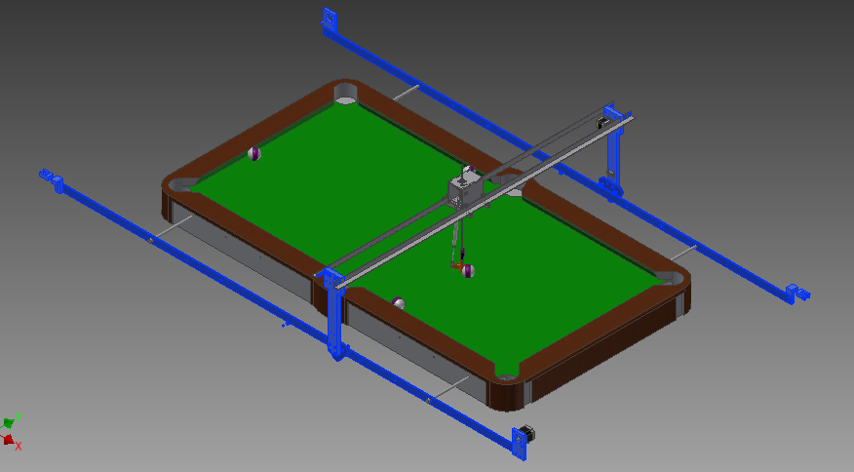
doc/HardwareDesign/fullDesign/img/xrail_full.png
