EricLeFort/Capstone-Project/doc/HardwareDesign/fullDesign/img/yrail_and_eebase_full.png

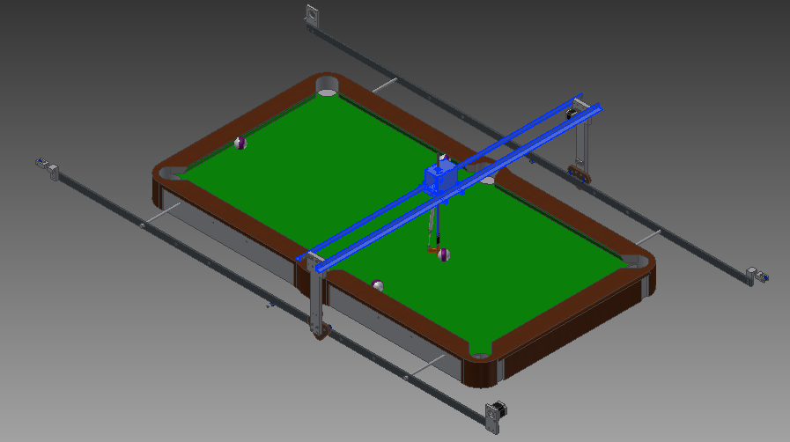
doc/HardwareDesign/fullDesign/img/yrail_and_eebase_full.png
