EricLeFort/Capstone-Project/doc/Presentation/Poster/pics/arudino mega.jpg

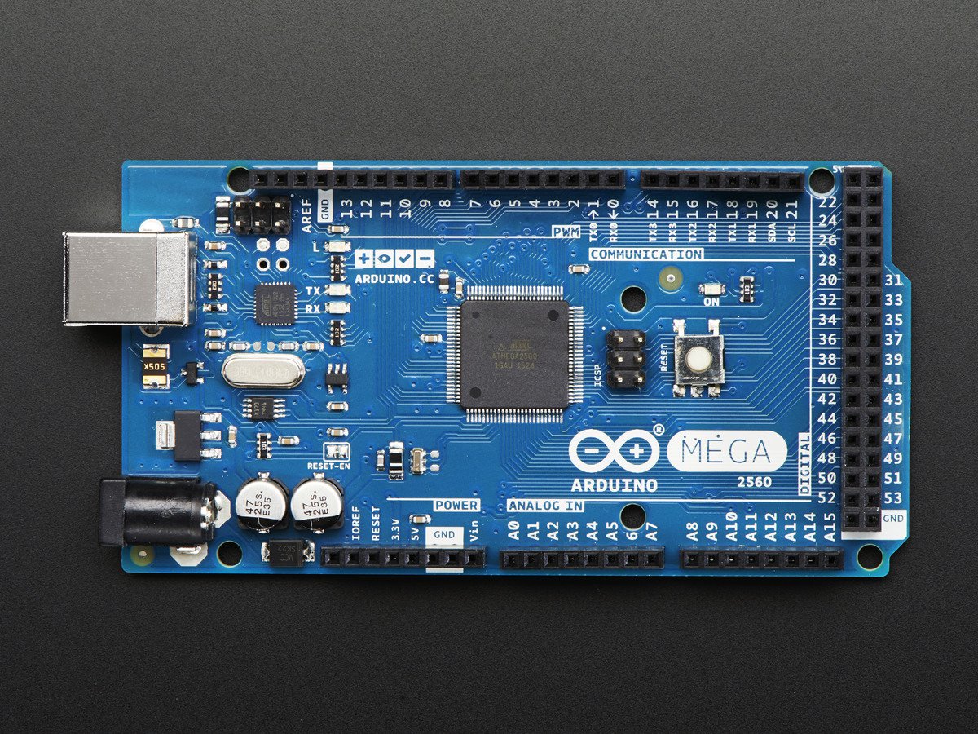
doc/Presentation/Poster/pics/arudino mega.jpg
