EricLeFort/Capstone-Project/doc/Presentation/Poster/pics/ee_1.PNG

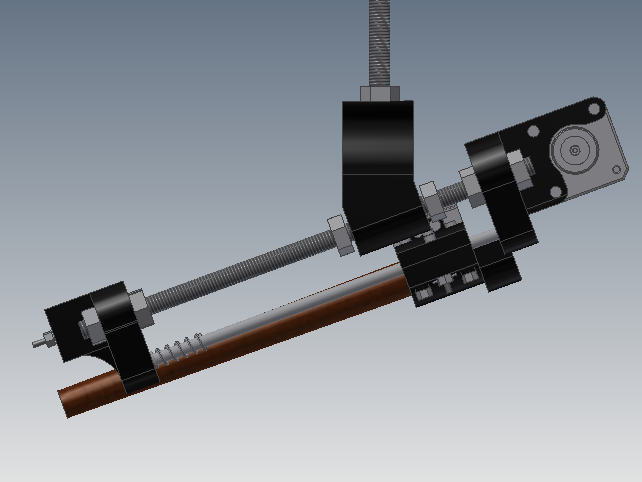
doc/Presentation/Poster/pics/ee_1.PNG
