EricLeFort/Capstone-Project/doc/Presentation/Poster/pics/ee_2.PNG

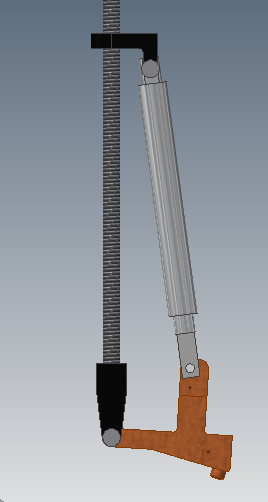
doc/Presentation/Poster/pics/ee_2.PNG
