EricLeFort/Capstone-Project/doc/Presentation/Poster/pics/piston _cut_out.jpg

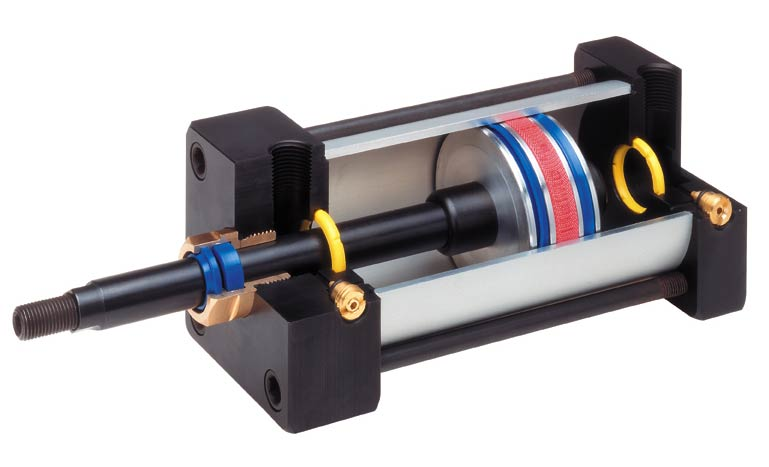
doc/Presentation/Poster/pics/piston _cut_out.jpg
