EricLeFort/Capstone-Project/doc/Presentation/Poster/pics/piston_animation.jpg

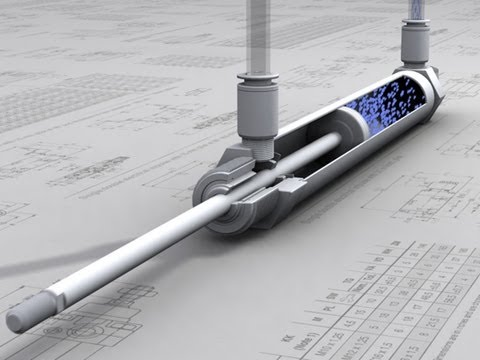
doc/Presentation/Poster/pics/piston_animation.jpg
