EricLeFort/Capstone-Project/doc/Presentation/Resources/16780697_10211921161642358_1690849625_n.png

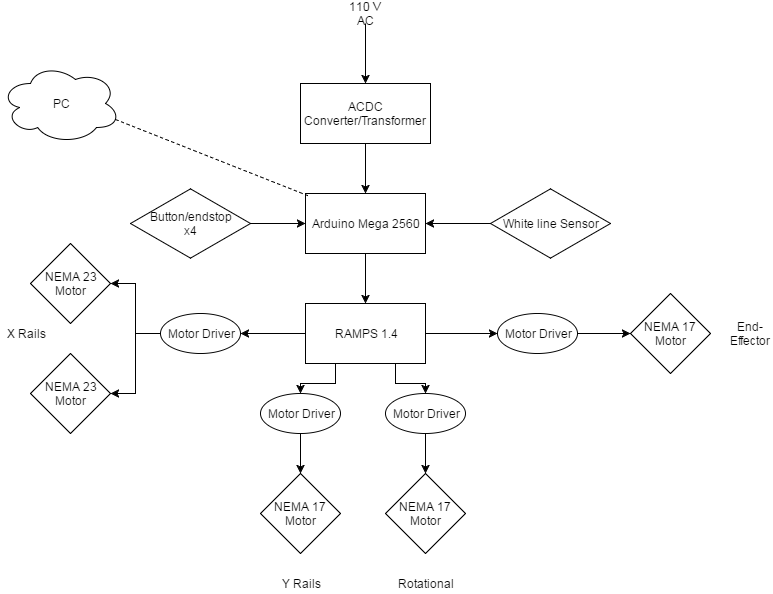
doc/Presentation/Resources/16780697_10211921161642358_1690849625_n.png
