EricLeFort/Capstone-Project/doc/Presentation/Resources/17758173_10209231515730378_519180243_n.jpg

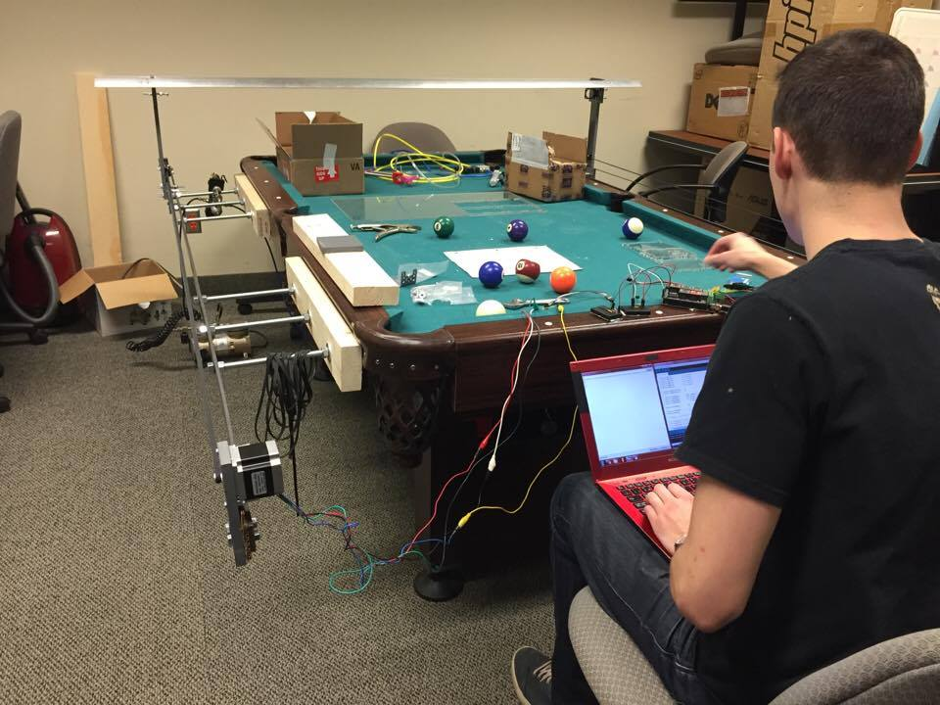
doc/Presentation/Resources/17758173_10209231515730378_519180243_n.jpg
