EricLeFort/Capstone-Project/doc/Presentation/Resources/17761676_1632188416799166_859378286_o.png

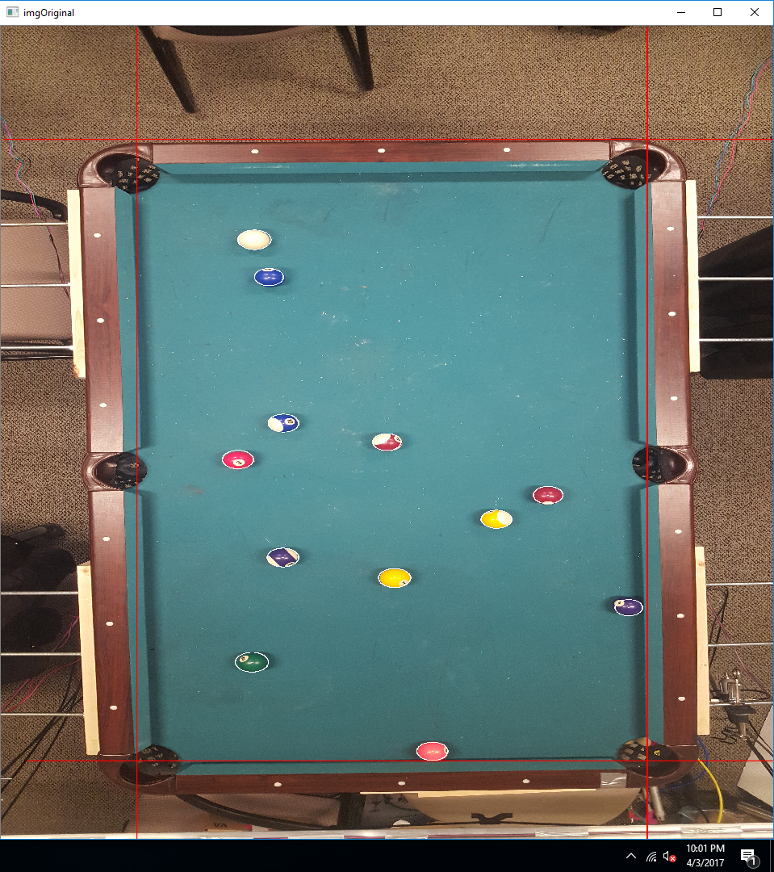
doc/Presentation/Resources/17761676_1632188416799166_859378286_o.png
