EricLeFort/Capstone-Project/doc/Presentation/Resources/android crash.jpg

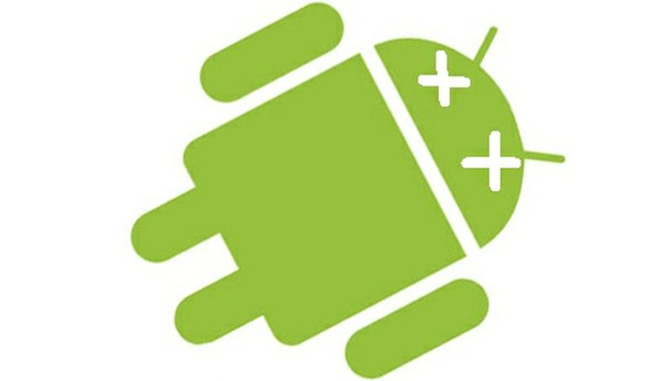
doc/Presentation/Resources/android crash.jpg
