EricLeFort/Capstone-Project/doc/Presentation/Resources/Arm_base.PNG

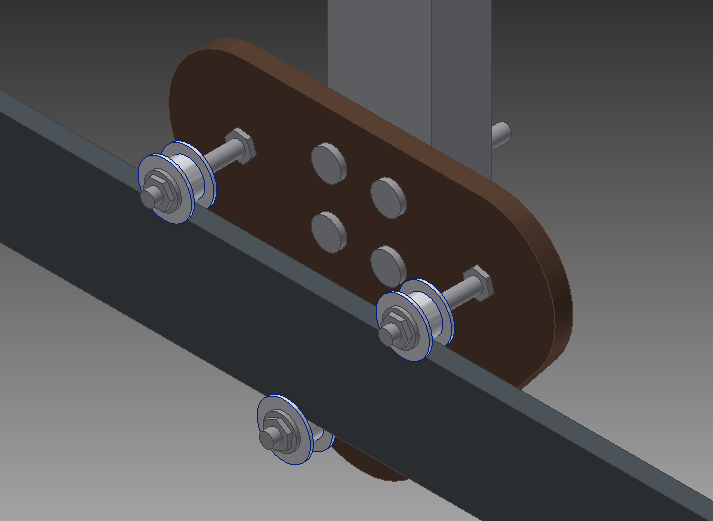
doc/Presentation/Resources/Arm_base.PNG
