EricLeFort/Capstone-Project/doc/Presentation/Resources/badballpic.png

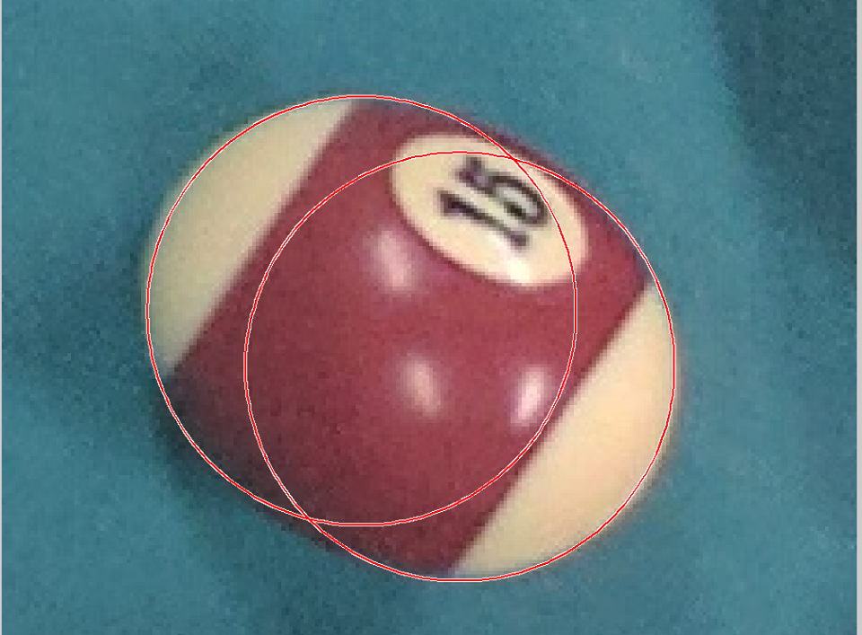
doc/Presentation/Resources/badballpic.png
