EricLeFort/Capstone-Project/doc/Presentation/Resources/billiard-table-and-balls.jpg

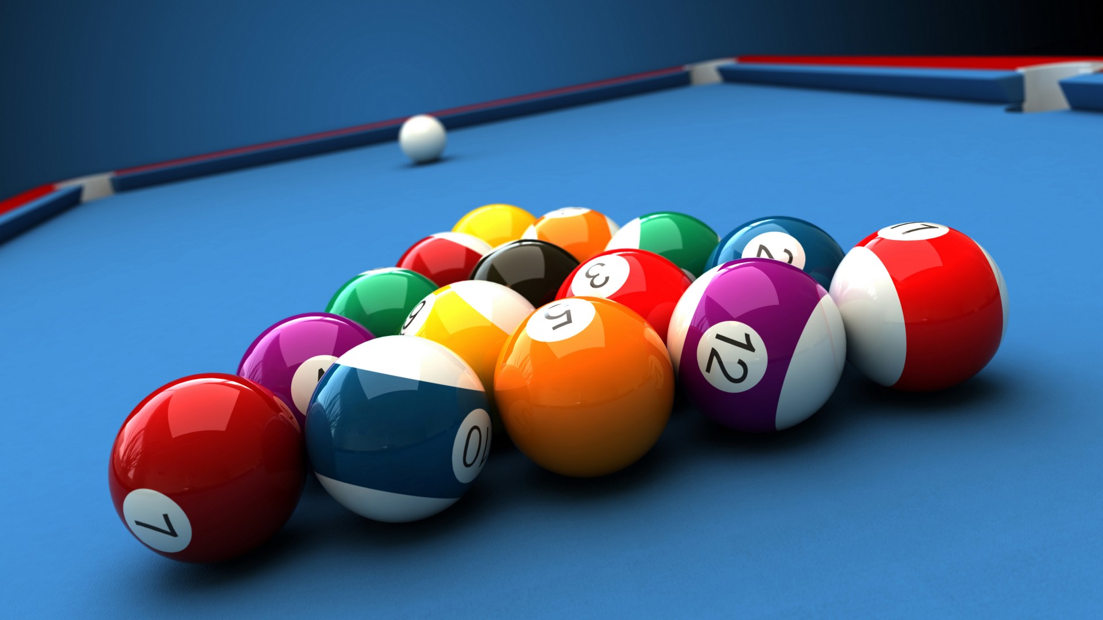
doc/Presentation/Resources/billiard-table-and-balls.jpg
