EricLeFort/Capstone-Project/doc/Presentation/Resources/eebase.PNG

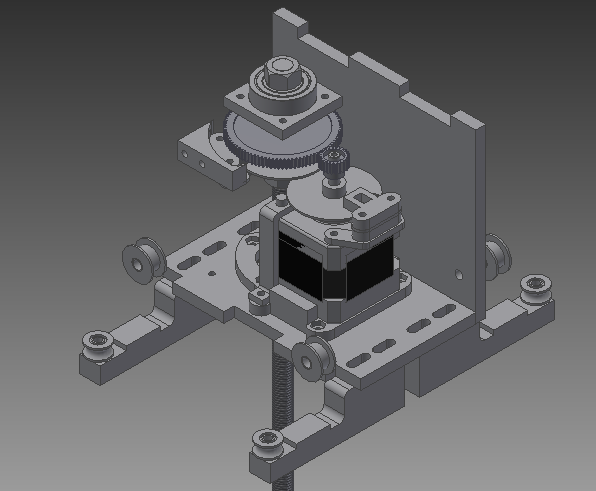
doc/Presentation/Resources/eebase.PNG
