EricLeFort/Capstone-Project/doc/Presentation/Resources/laptop_phone.jpg

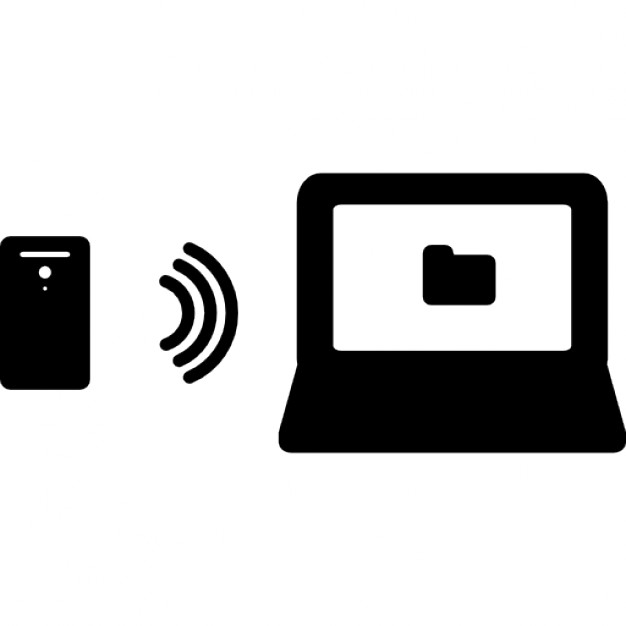
doc/Presentation/Resources/laptop_phone.jpg
