EricLeFort/Capstone-Project/doc/Presentation/Resources/Pic_overall.PNG

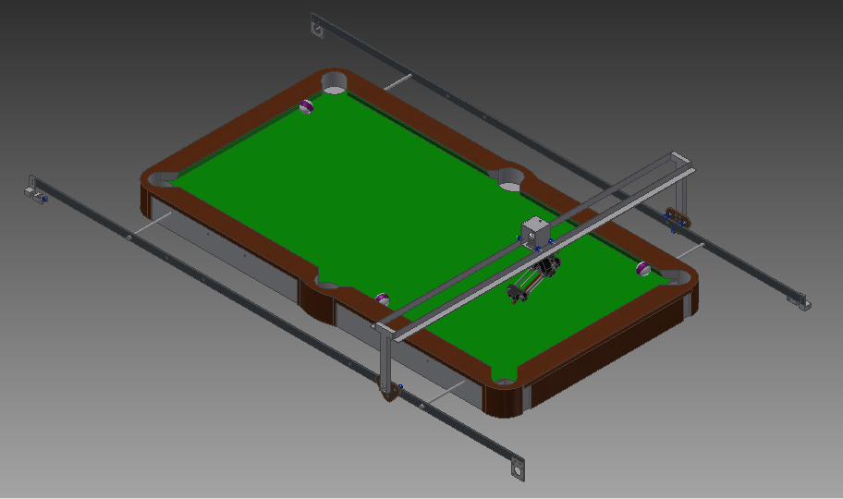
doc/Presentation/Resources/Pic_overall.PNG
