EricLeFort/Capstone-Project/doc/Presentation/Resources/rotating_mechanism.PNG

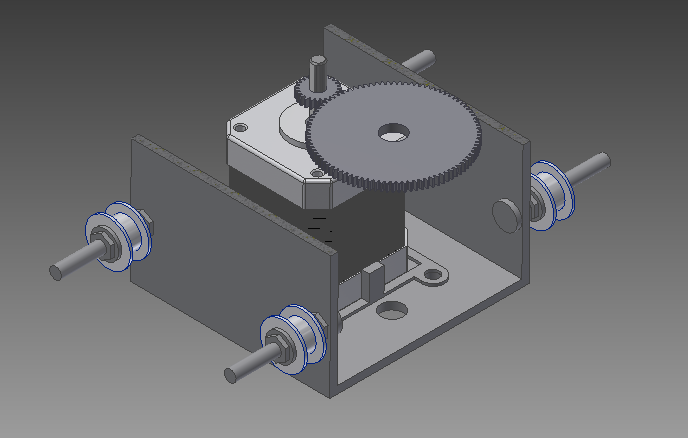
doc/Presentation/Resources/rotating_mechanism.PNG
