EricLeFort/Capstone-Project/doc/Presentation/Resources/set table.jpg

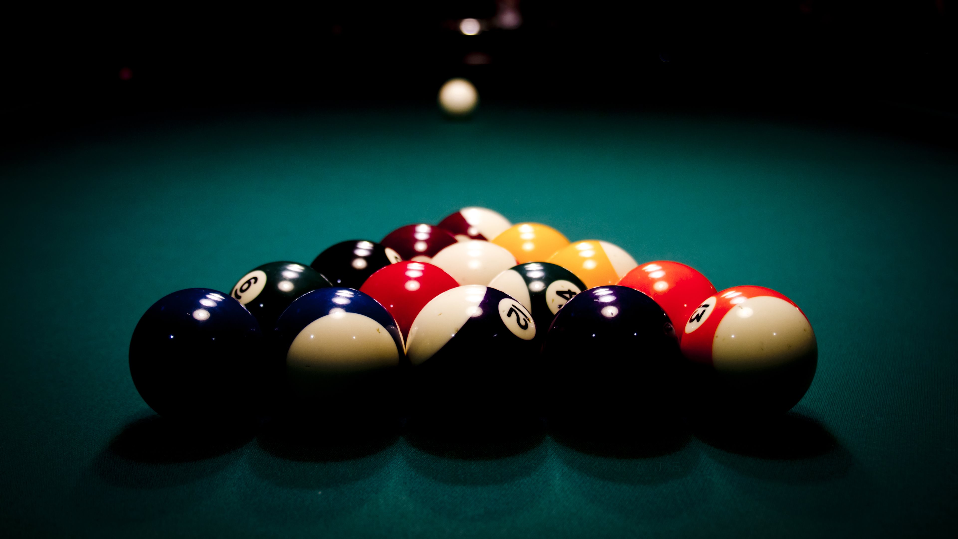
doc/Presentation/Resources/set table.jpg
