EricLeFort/Capstone-Project/doc/Presentation/Resources/Shooting_mechanism.PNG

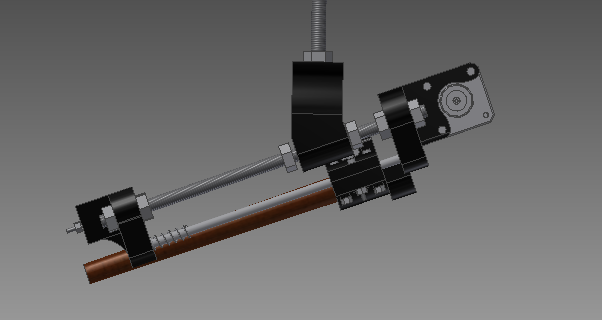
doc/Presentation/Resources/Shooting_mechanism.PNG
