EricLeFort/Capstone-Project/doc/Presentation/Resources/sm2.PNG

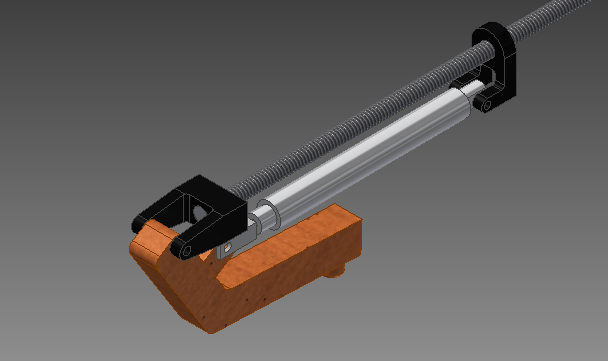
doc/Presentation/Resources/sm2.PNG
