EricLeFort/Capstone-Project/doc/Presentation/Resources/team_pic2.jpg

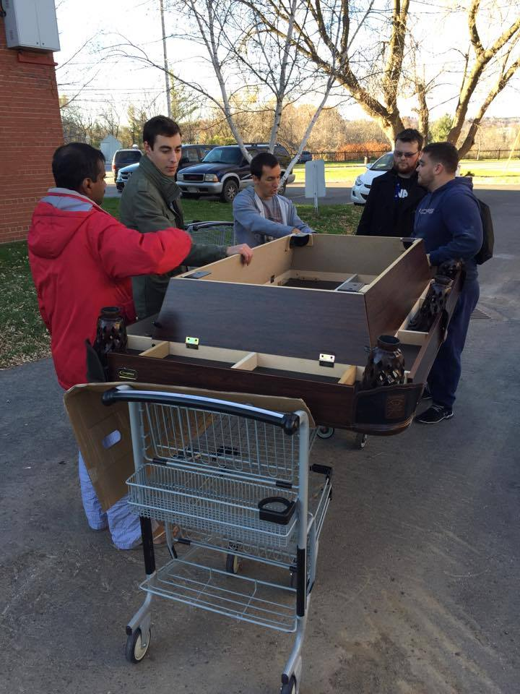
doc/Presentation/Resources/team_pic2.jpg
