EricLeFort/Capstone-Project/doc/Presentation/Resources/team_pic.jpg

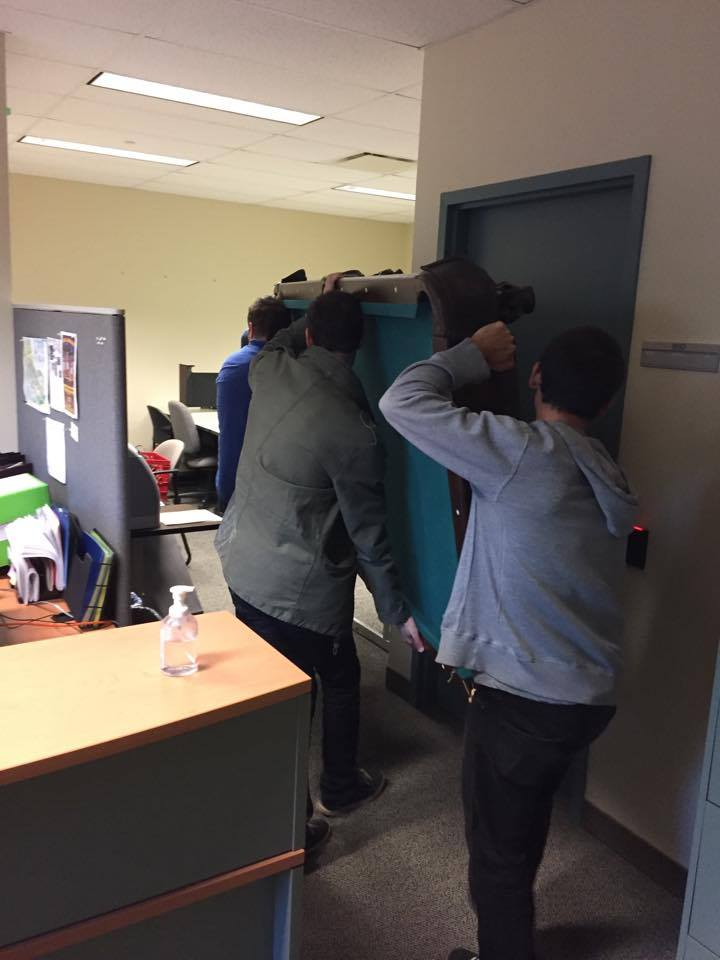
doc/Presentation/Resources/team_pic.jpg
