EricLeFort/Capstone-Project/doc/Presentation/Resources/VR pic.png

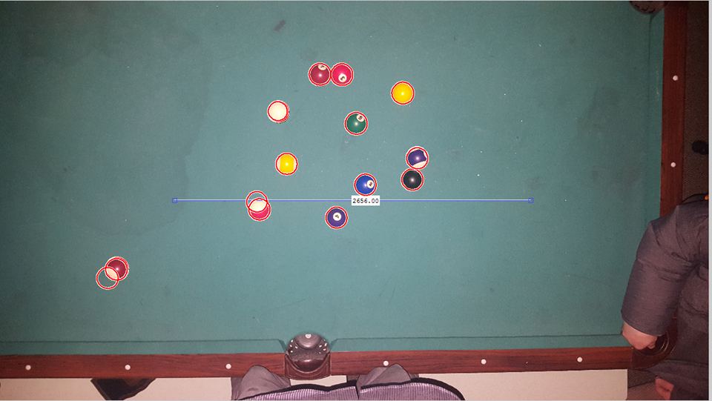
doc/Presentation/Resources/VR pic.png
