EricLeFort/Capstone-Project/doc/Presentation/Resources/white line sensor.jpg

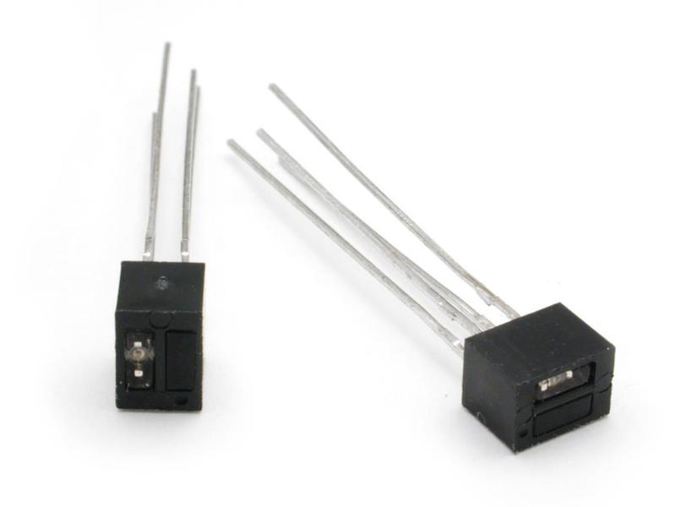
doc/Presentation/Resources/white line sensor.jpg
