EricLeFort/Capstone-Project/resources/referenceImages/1ball.jpg

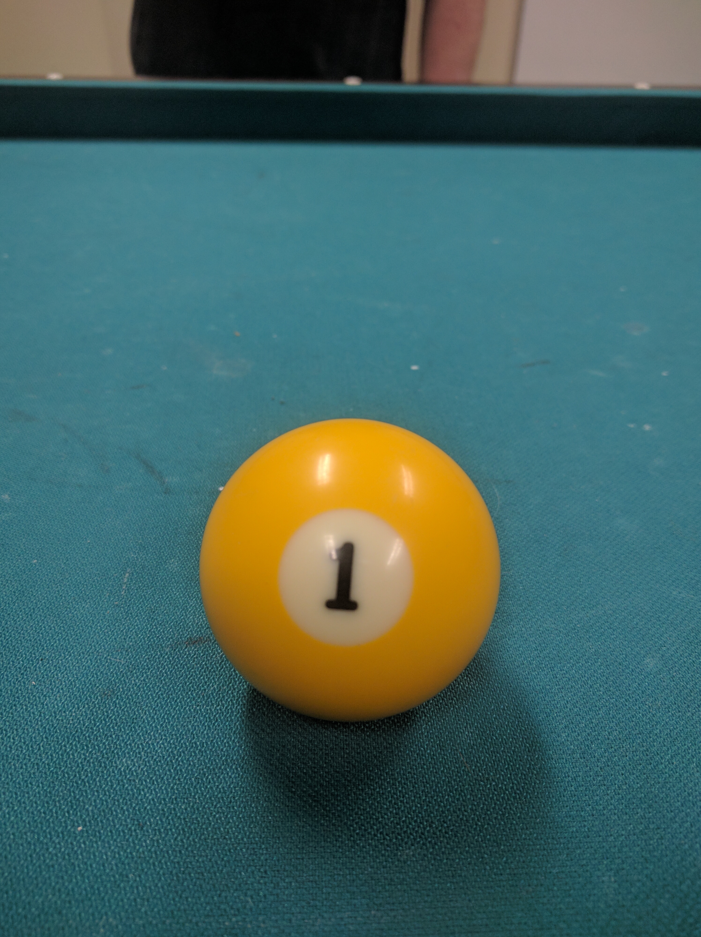
resources/referenceImages/1ball.jpg
