EricLeFort/Capstone-Project/resources/referenceImages/2ball.jpg

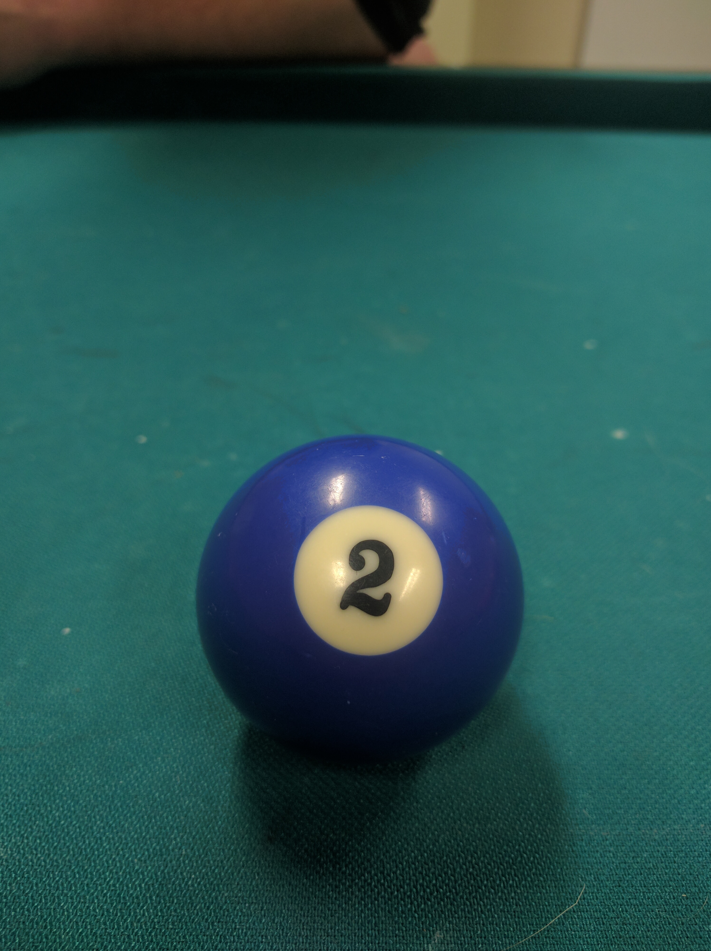
resources/referenceImages/2ball.jpg
