EricLeFort/Capstone-Project/resources/referenceImages/3ball.jpg

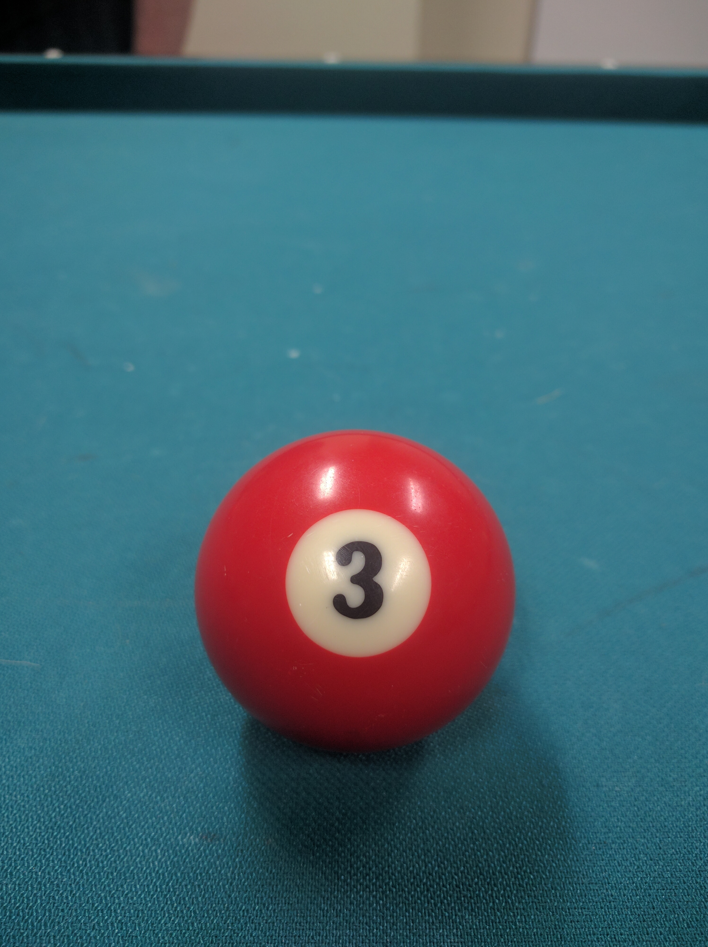
resources/referenceImages/3ball.jpg
