EricLeFort/Capstone-Project/resources/referenceImages/4ball.jpg

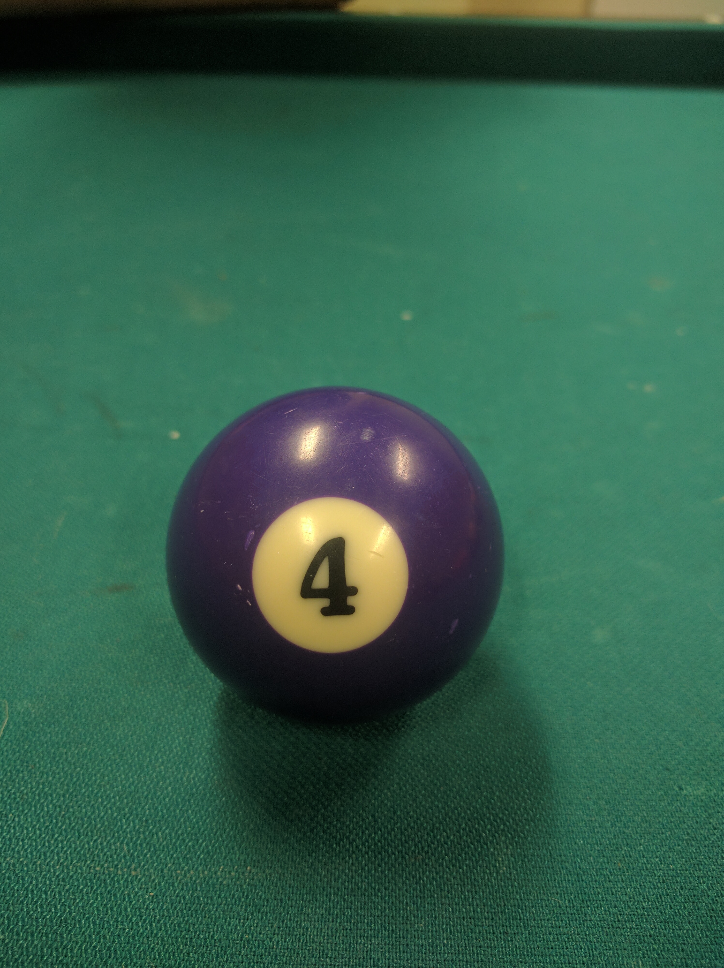
resources/referenceImages/4ball.jpg
