EricLeFort/Capstone-Project/resources/referenceImages/5ball.jpg

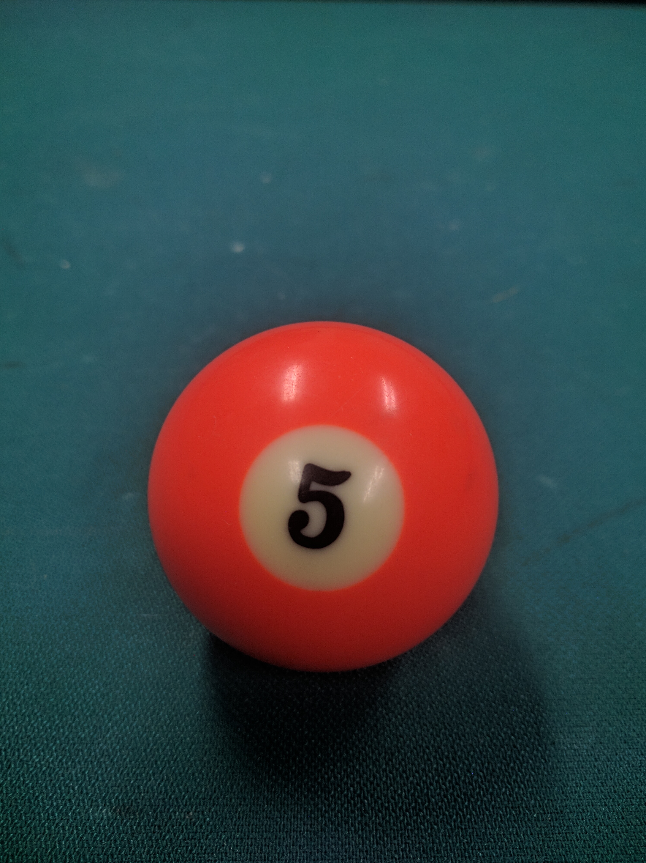
resources/referenceImages/5ball.jpg
