EricLeFort/Capstone-Project/resources/referenceImages/6ball.jpg

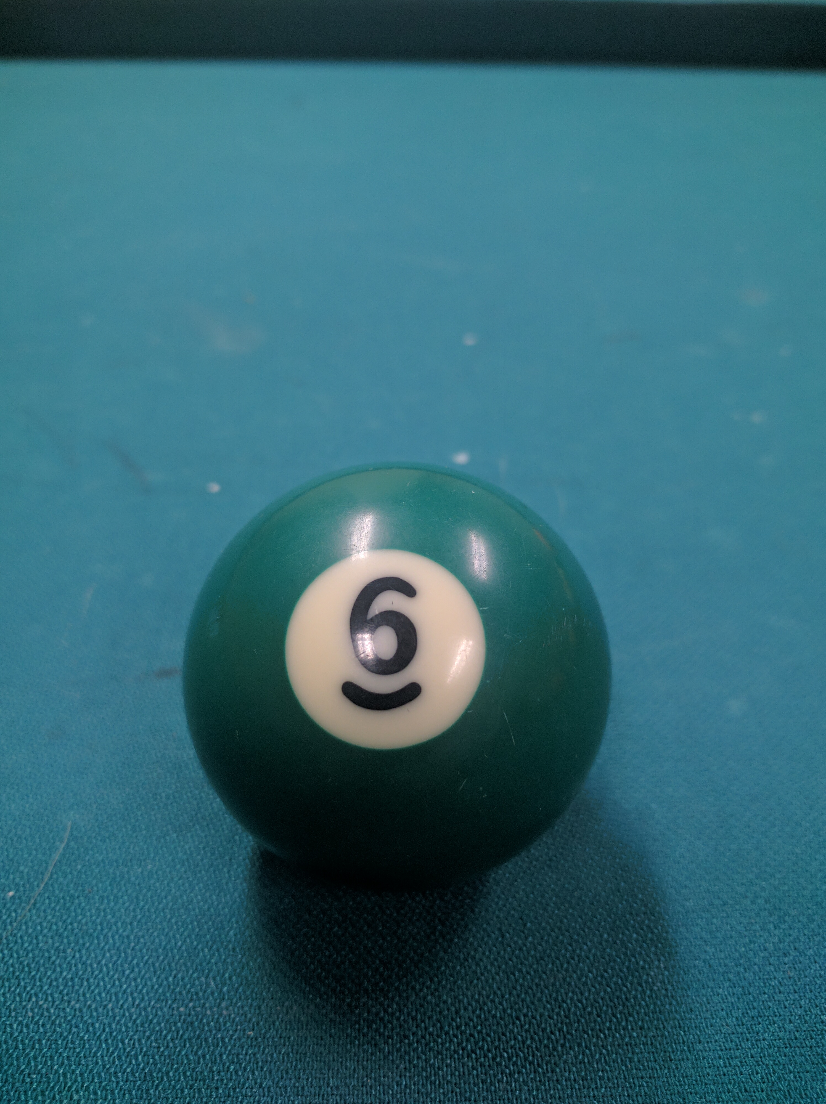
resources/referenceImages/6ball.jpg
