EricLeFort/Capstone-Project/resources/referenceImages/7ball.jpg

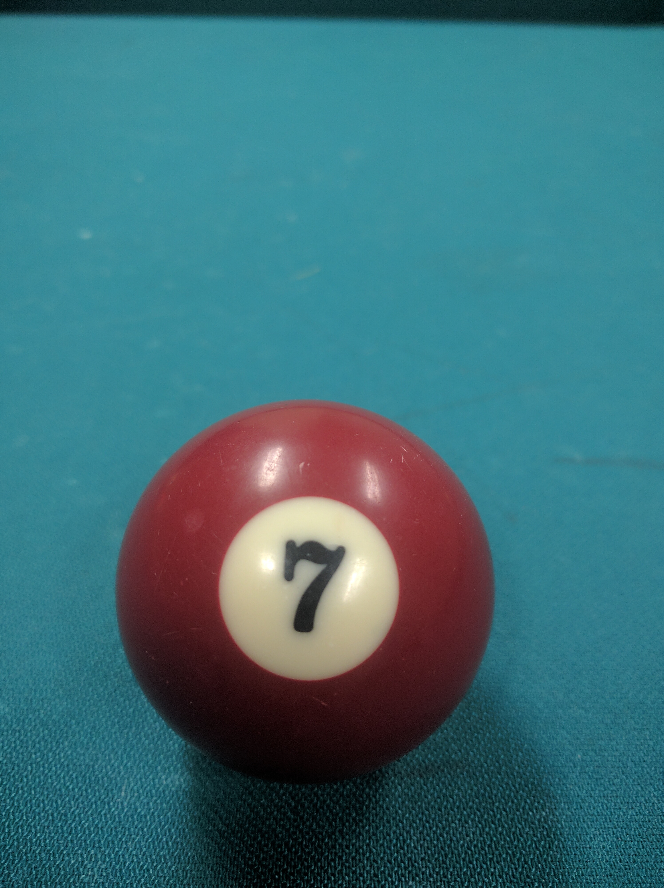
resources/referenceImages/7ball.jpg
