EricLeFort/Capstone-Project/resources/referenceImages/8ball.jpg

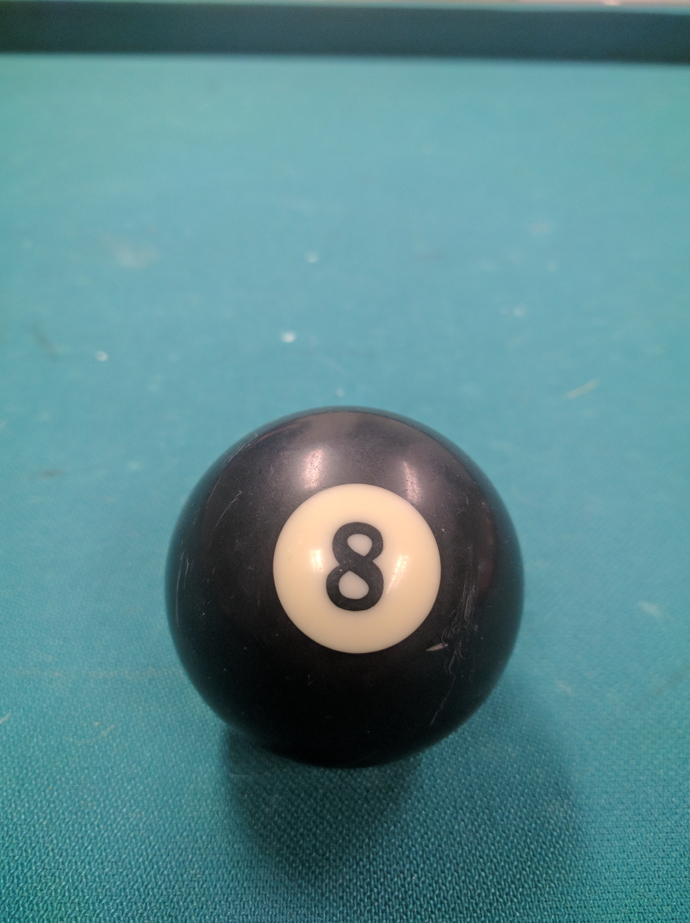
resources/referenceImages/8ball.jpg
