EricLeFort/Capstone-Project/resources/referenceImages/9ball.jpg

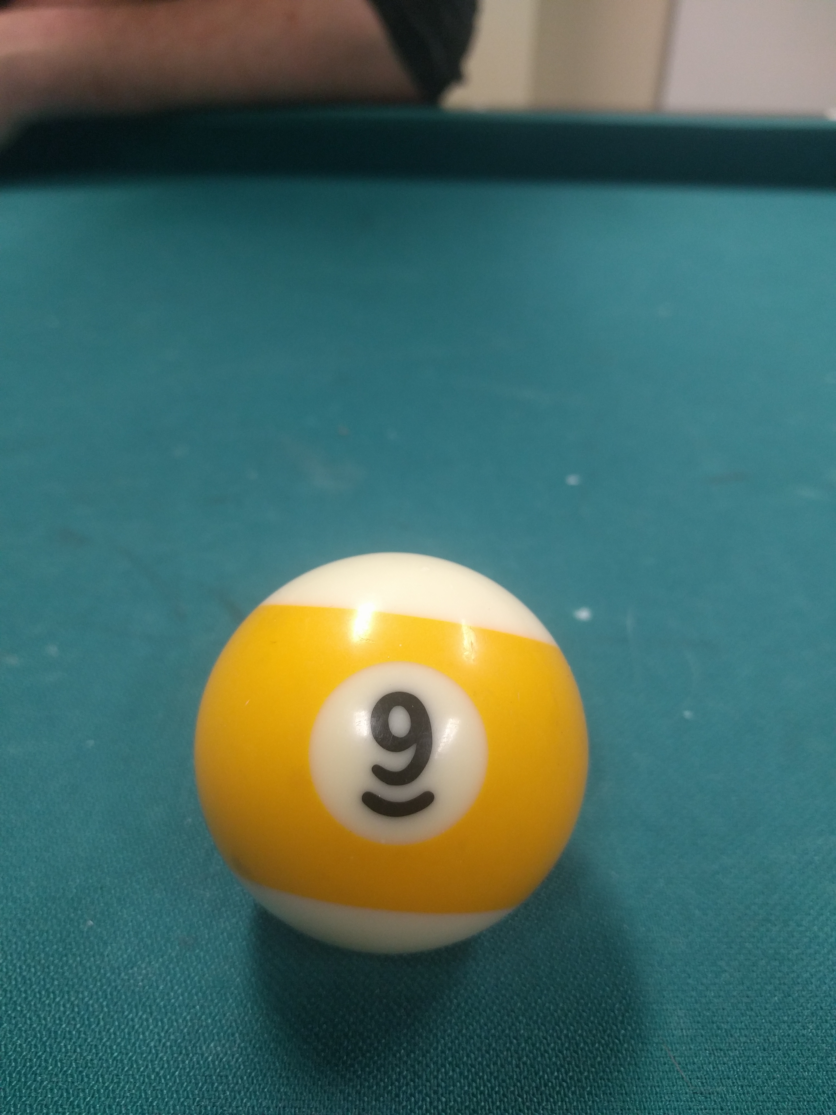
resources/referenceImages/9ball.jpg
