EricLeFort/Capstone-Project/resources/referenceImages/10ball.jpg

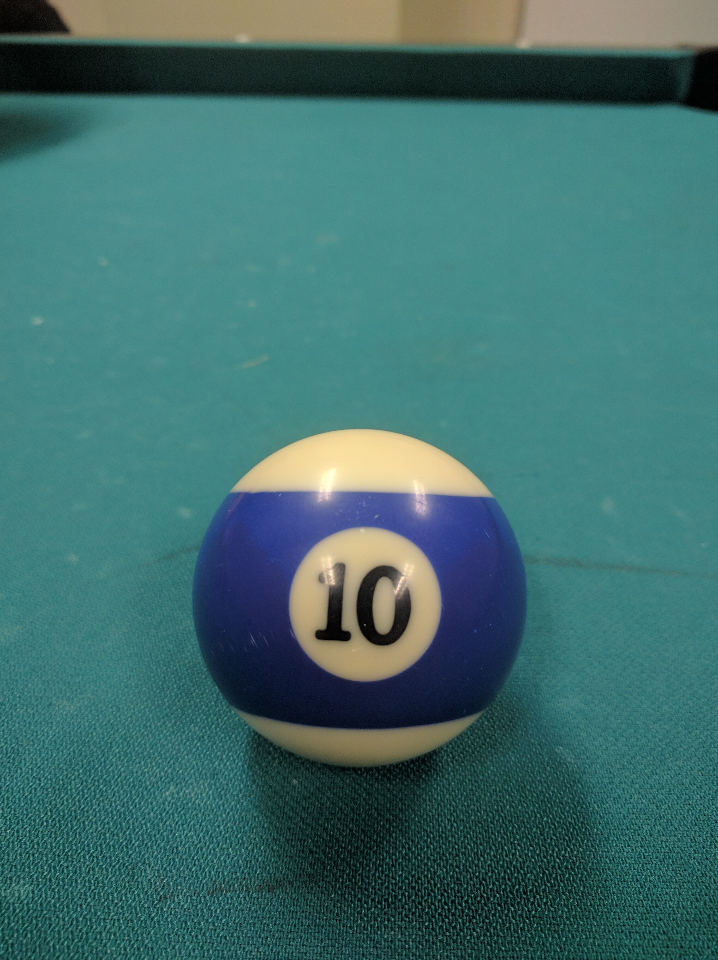
resources/referenceImages/10ball.jpg
