EricLeFort/Capstone-Project/resources/referenceImages/11ball2.jpg

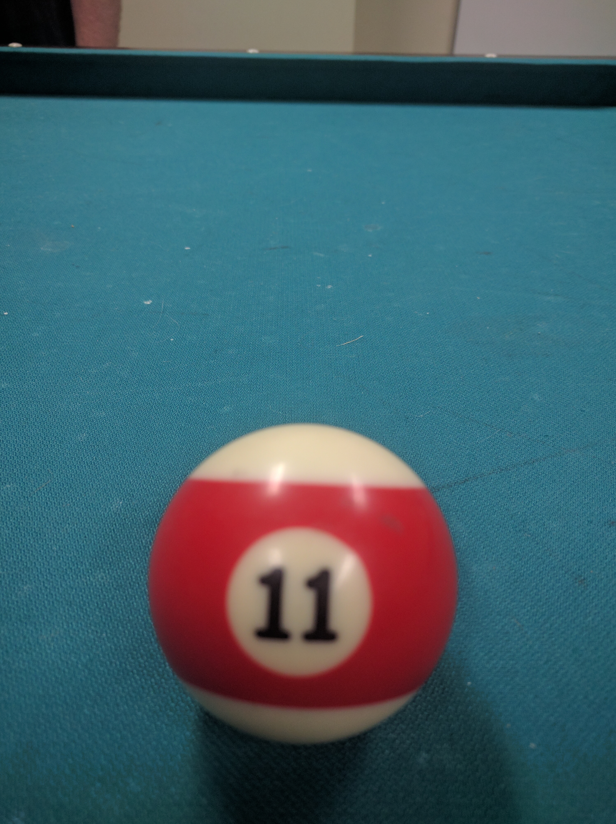
resources/referenceImages/11ball2.jpg
