EricLeFort/Capstone-Project/resources/referenceImages/11ball3.jpg

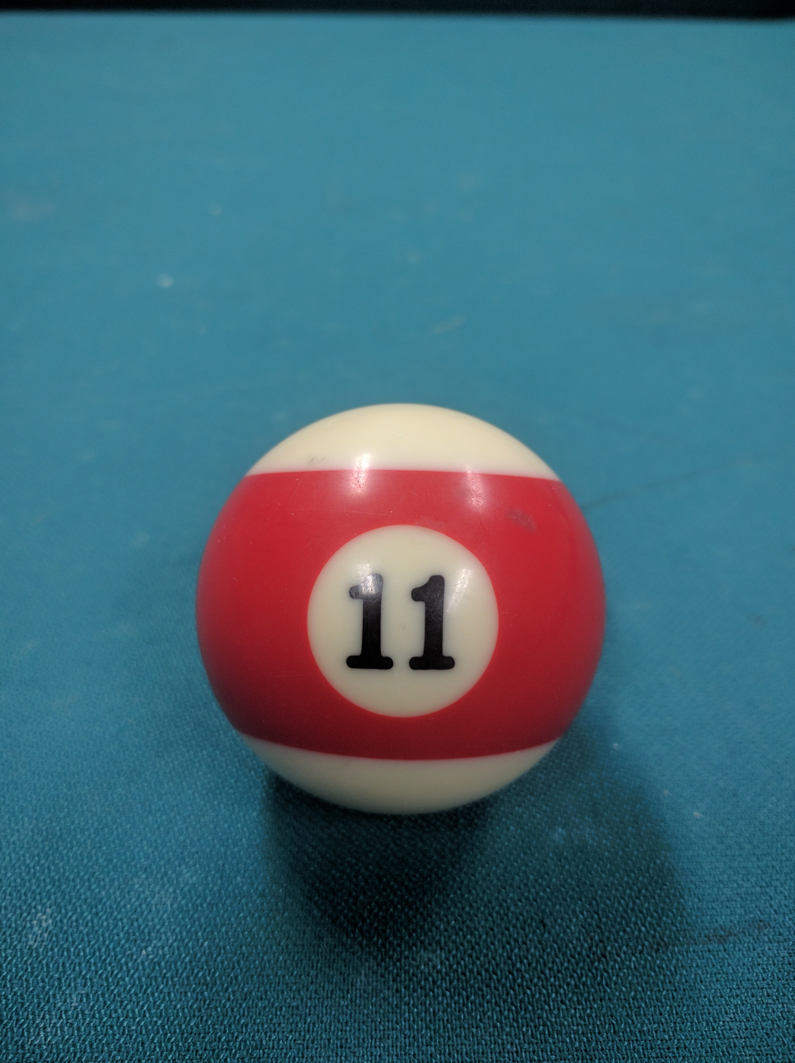
resources/referenceImages/11ball3.jpg
