EricLeFort/Capstone-Project/resources/referenceImages/12ball.jpg

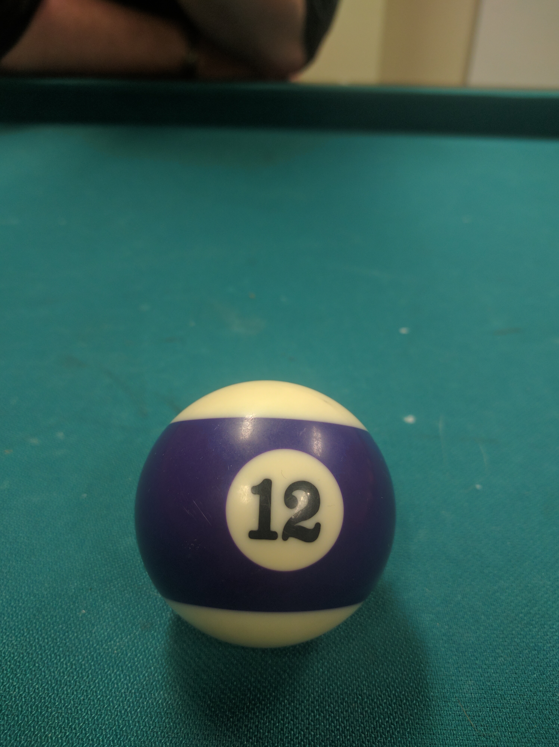
resources/referenceImages/12ball.jpg
