EricLeFort/Capstone-Project/resources/referenceImages/13ball.jpg

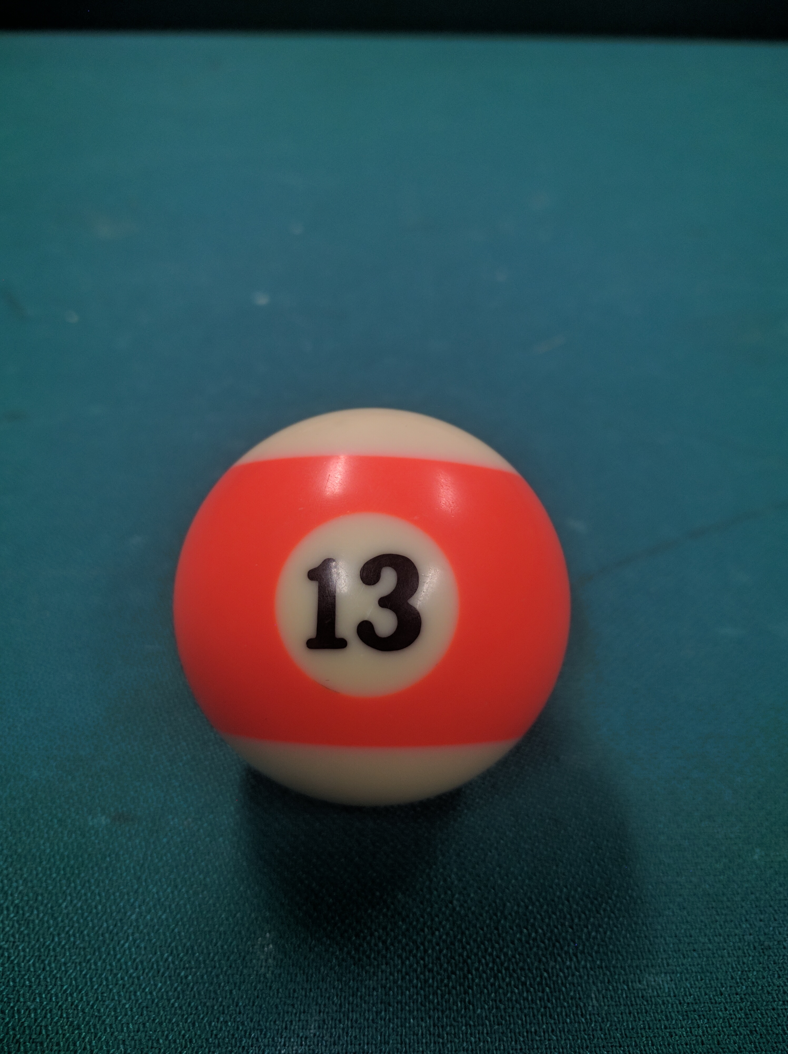
resources/referenceImages/13ball.jpg
