EricLeFort/Capstone-Project/resources/referenceImages/14ball.jpg

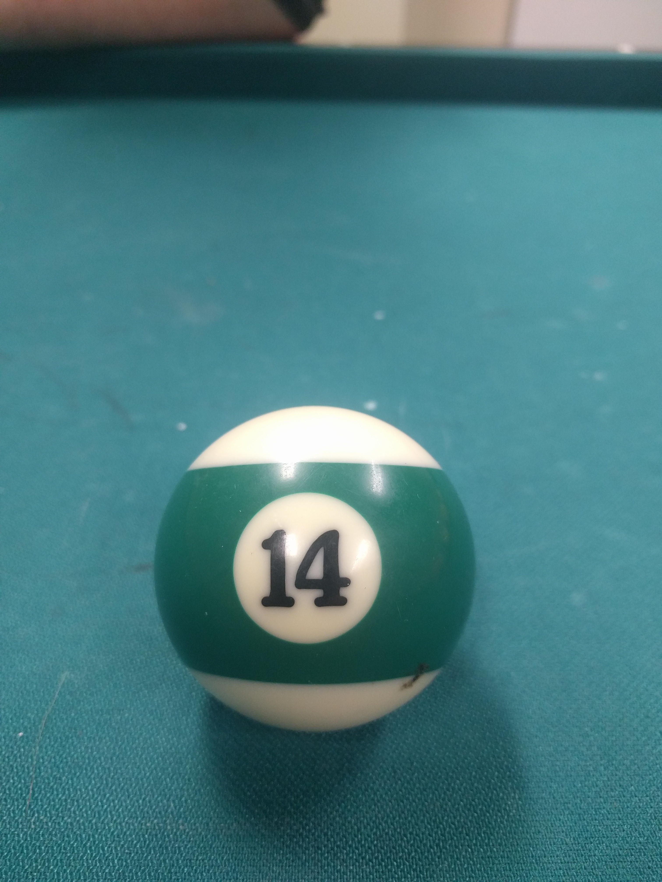
resources/referenceImages/14ball.jpg
