EricLeFort/Capstone-Project/resources/referenceImages/15ball.jpg

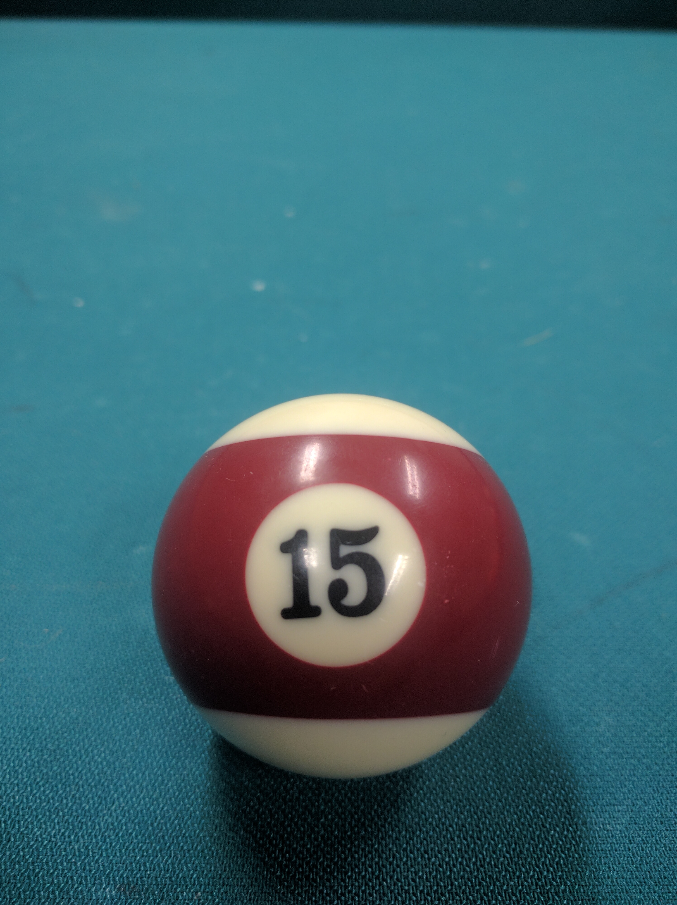
resources/referenceImages/15ball.jpg
