EricLeFort/Capstone-Project/resources/referenceImages/cueBall.jpg

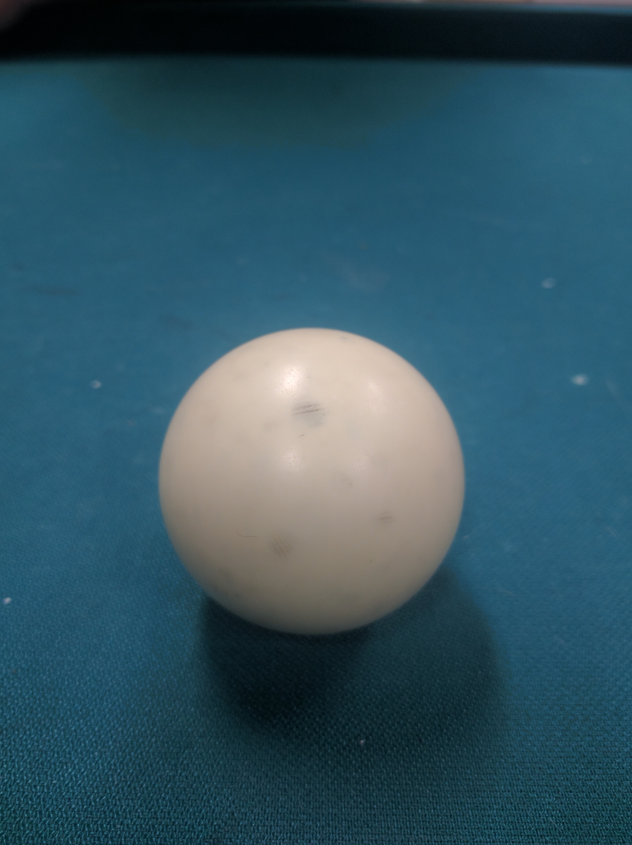
resources/referenceImages/cueBall.jpg
