EricLeFort/Capstone-Project/doc/CAD/SM2/stl/Imported Components/Piston_Holder/Piston_Holder.htm

Autodesk Inventor Translation Report | March 6, 2017 ( 1:12 AM)
Source File: | C:\Users\Guy\Documents\Fourth Year\Capstone\git\Capstone-Project\doc\CAD\SM2\stl\Piston_Holder.stl
Translator Type: | STL | Sending System:
Author: |  | Translation Time: | 00:00:00
Options
Import Type: | N/A
Entity Types to Import: | Meshes
Import into Repair Environment: | N/A
Import Assembly as Single Part: | N/A
Create Surfaces As: | N/A
Check Parts during Load: | N/A
Auto Stitch: | N/A
Enable Advanced Healing: | N/A
Color Red/Green/Blue Order: | RGB
+/- | Name | Inventor File | Status
[ ] | Piston_Holder.ipt | C:\Users\Guy\Documents\Fourth Year\Capstone\git\Capstone-Project\doc\CAD\SM2\stl\Imported Components\Piston_Holder\Piston_Holder.ipt | Successful
