EricLeFort/Capstone-Project/doc/CAD/Stepper Motor/NEMA 23/Imported Components/NEMA23/NEMA23.htm

Autodesk Inventor Translation Report | January 20, 2017 ( 3:10 PM)
Source File: | C:\Users\Guy\Documents\Fourth Year\Capstone\git\Capstone-Project\doc\CAD\Stepper Motor\NEMA 23\NEMA23.SLDPRT
Translator Type: | SolidWorks | Sending System: | SolidWorks 2013
Author: |  | Translation Time: | 00:00:00
Options
Import Type: | N/A
Entity Types to Import: | Solids, Surfaces, Wires
Import into Repair Environment: | Yes
Import Assembly as Single Part: | No
Create Surfaces As: | Single Composite Feature
Check Parts during Load: | No
Auto Stitch: | No
Enable Advanced Healing: | N/A
+/- | Name | Inventor File | Status
[ ] | NEMA23.ipt | C:\Users\Guy\Documents\Fourth Year\Capstone\git\Capstone-Project\doc\CAD\Stepper Motor\NEMA 23\Imported Components\NEMA23\NEMA23.ipt | Successful
