EricLeFort/Capstone-Project/doc/CAD/Drawings/STL/tubing_alignment_arm[3].stl

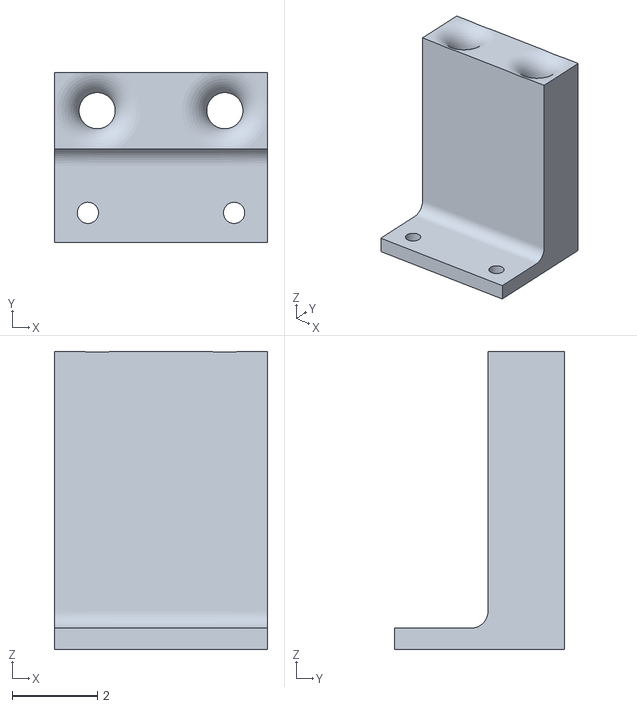
[picture p119: CAD file, 2017-04-15]
doc/CAD/Drawings/STL/tubing_alignment_arm[3].stl
5.01 x 4.00 x 7.00
