EricLeFort/Capstone-Project/doc/CAD/SM2/stl/EE_base_connection.stl

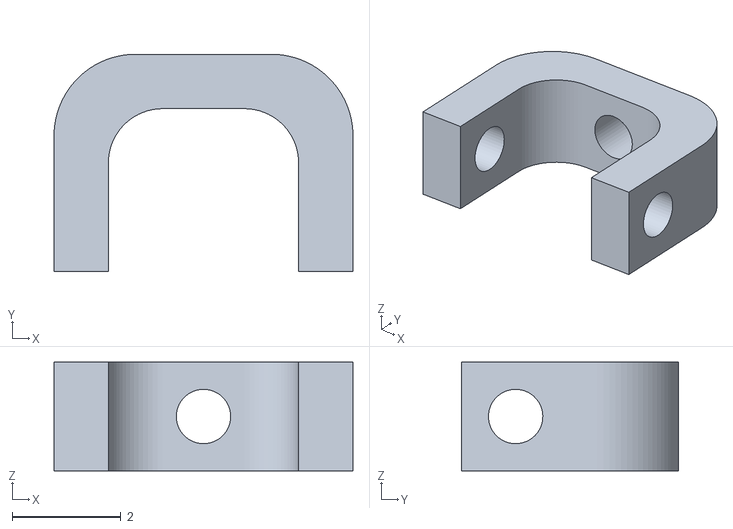
[picture p120: CAD file, 2017-04-15]
doc/CAD/SM2/stl/EE_base_connection.stl
5.50 x 4.00 x 2.00
