EricLeFort/Capstone-Project/doc/CAD/Drawings/STL/tubing_connection_holder.stl

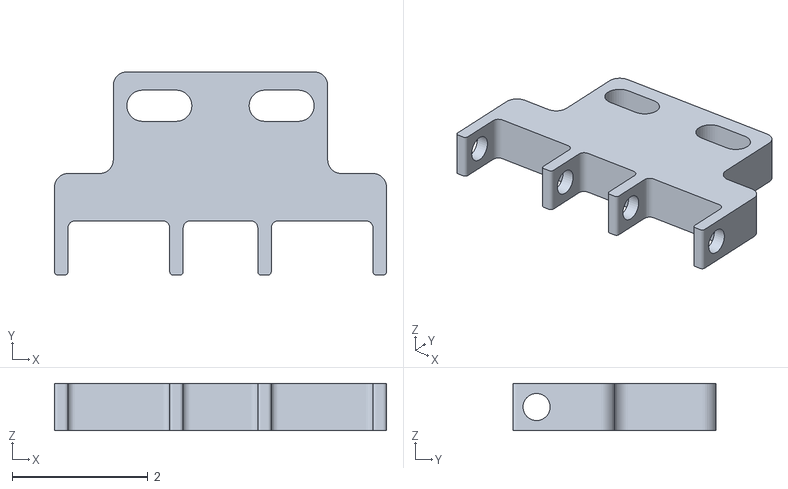
[picture p121: CAD file, 2017-04-15]
doc/CAD/Drawings/STL/tubing_connection_holder.stl
4.90 x 3.00 x 0.7
