EricLeFort/Capstone-Project/doc/CAD/SM2/stl/swing_con2.stl

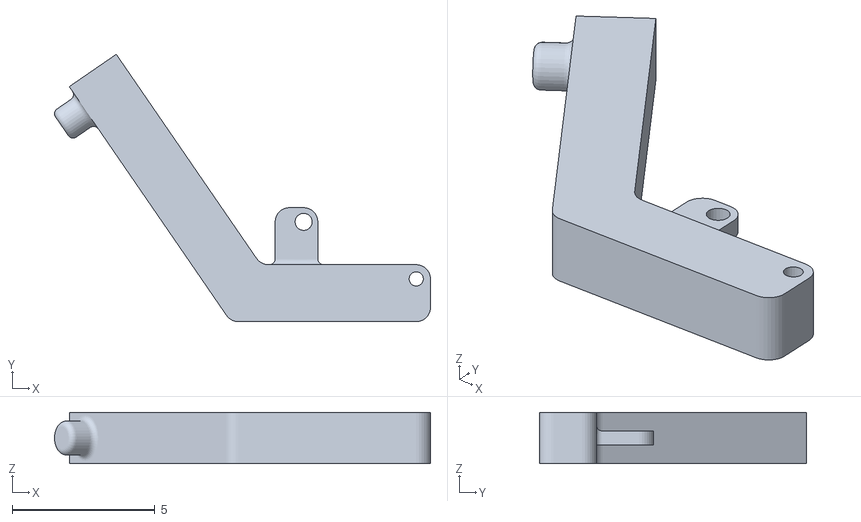
[picture p122: CAD file, 2017-04-15]
doc/CAD/SM2/stl/swing_con2.stl
13.2 x 9.37 x 1.80
