EricLeFort/Capstone-Project/doc/CAD/Drawings/STL/tubing_alignment_arm[2].stl

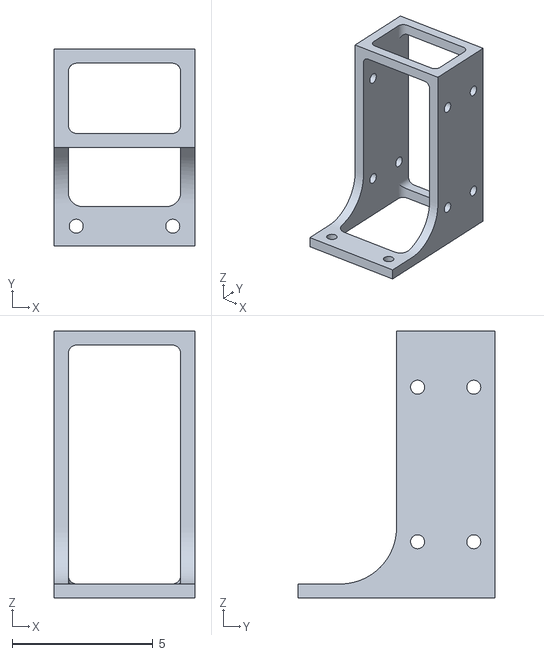
[picture p123: CAD file, 2017-04-15]
doc/CAD/Drawings/STL/tubing_alignment_arm[2].stl
5.00 x 7.00 x 9.50
