EricLeFort/Capstone-Project/doc/CAD/SM2/stl/Swinging_connection.stl

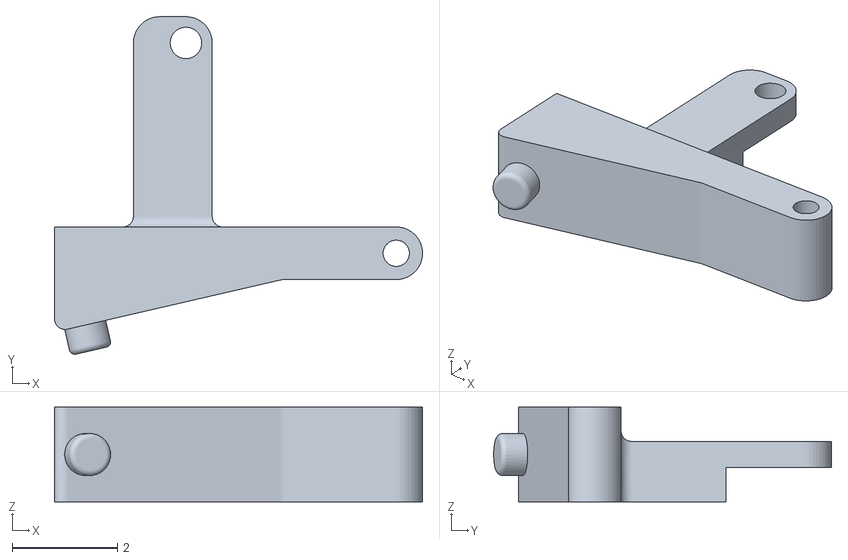
[picture p124: CAD file, 2017-03-07]
doc/CAD/SM2/stl/Swinging_connection.stl
7.00 x 6.42 x 1.80
