EricLeFort/Capstone-Project/doc/CAD/Drawings/STL/X_Rail_Belt_Pulley_Connector.stl

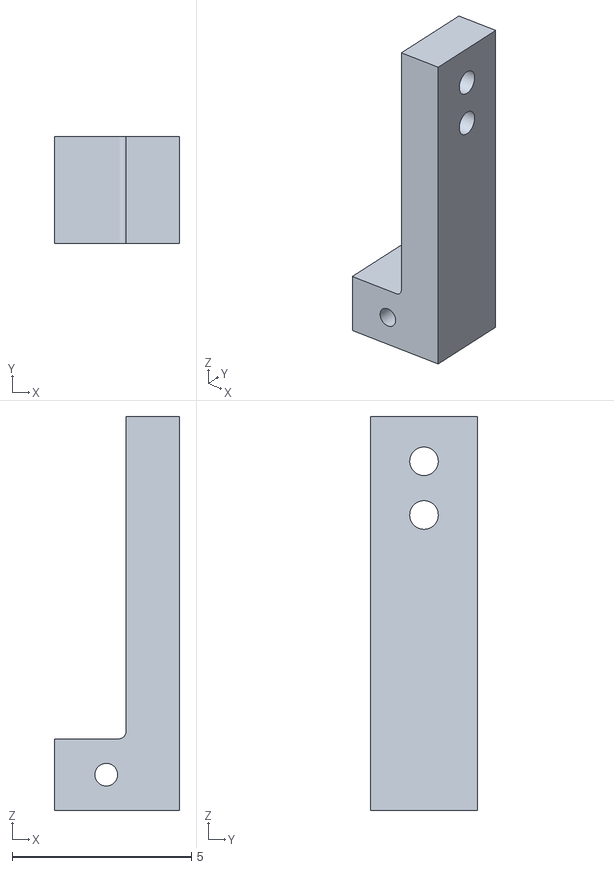
[picture p125: CAD file, 2017-04-15]
doc/CAD/Drawings/STL/X_Rail_Belt_Pulley_Connector.stl
3.50 x 3.00 x 11.0
