EricLeFort/Capstone-Project/doc/CAD/SM2/stl/Piston_Holder[2].stl

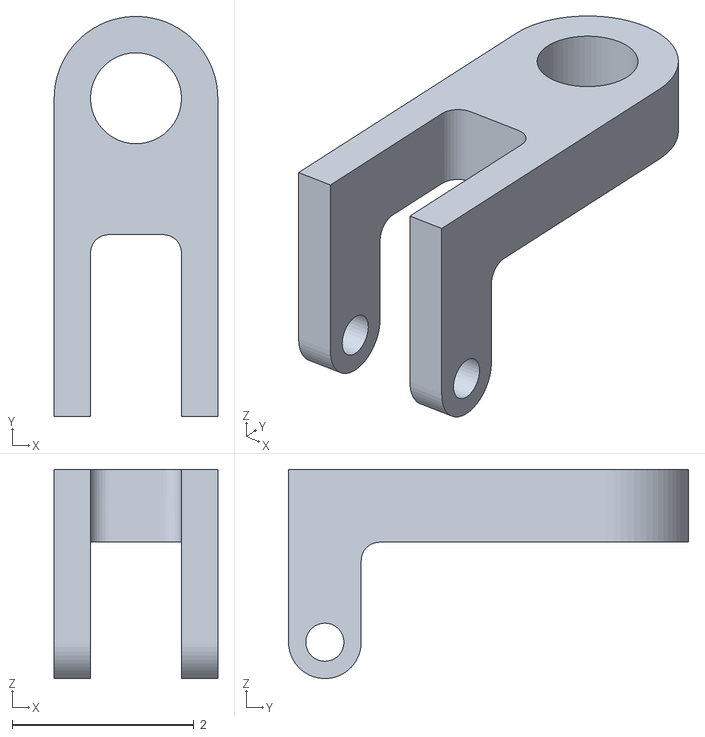
[picture p126: CAD file, 2017-03-03]
doc/CAD/SM2/stl/Piston_Holder[2].stl
1.80 x 4.40 x 2.30
