EricLeFort/Capstone-Project/doc/CAD/Drawings/STL/tubing_alignment_arm.stl

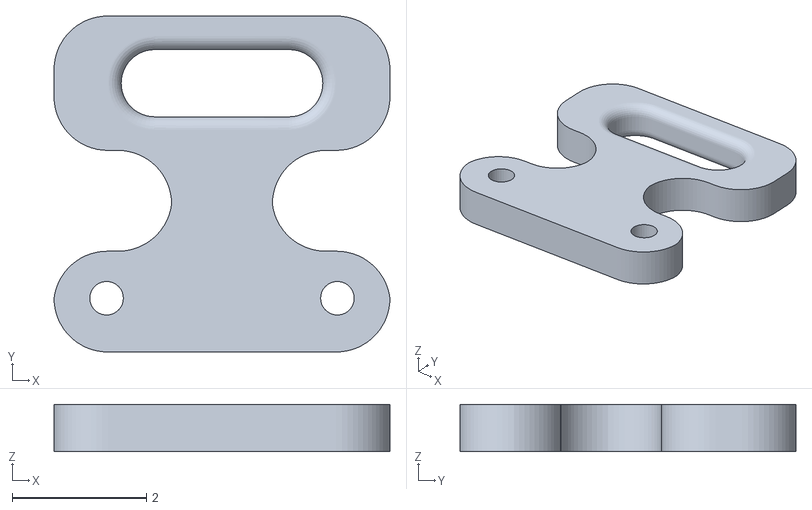
[picture p127: CAD file, 2017-04-15]
doc/CAD/Drawings/STL/tubing_alignment_arm.stl
5.00 x 5.00 x 0.7
