EricLeFort/Capstone-Project/doc/CAD/SM2/stl/hinge_for_swing.stl

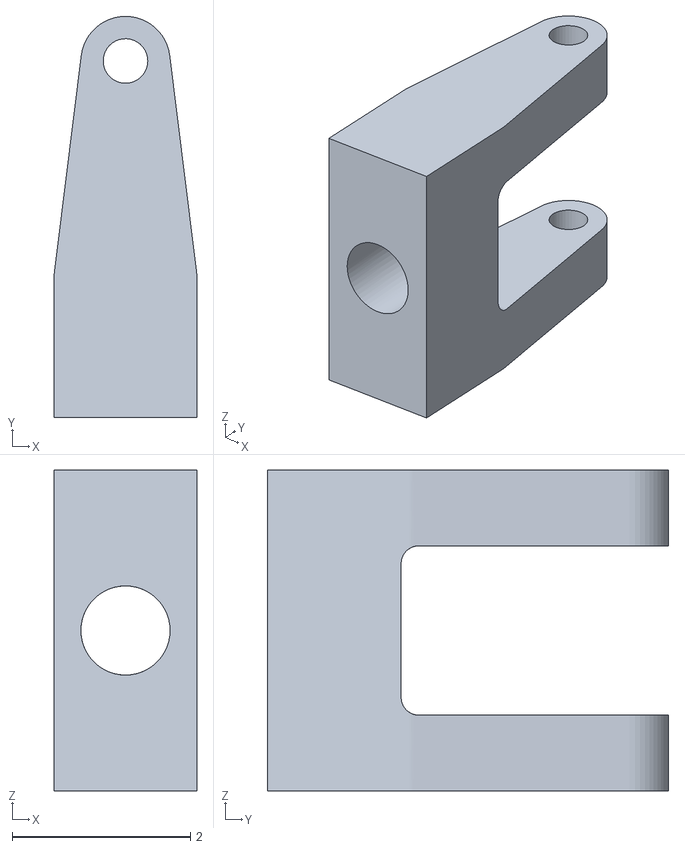
[picture p128: CAD file, 2017-02-24]
doc/CAD/SM2/stl/hinge_for_swing.stl
1.60 x 4.50 x 3.60
