EricLeFort/Capstone-Project/doc/CAD/Drawings/STL/Arm_Pulley_Connector.stl

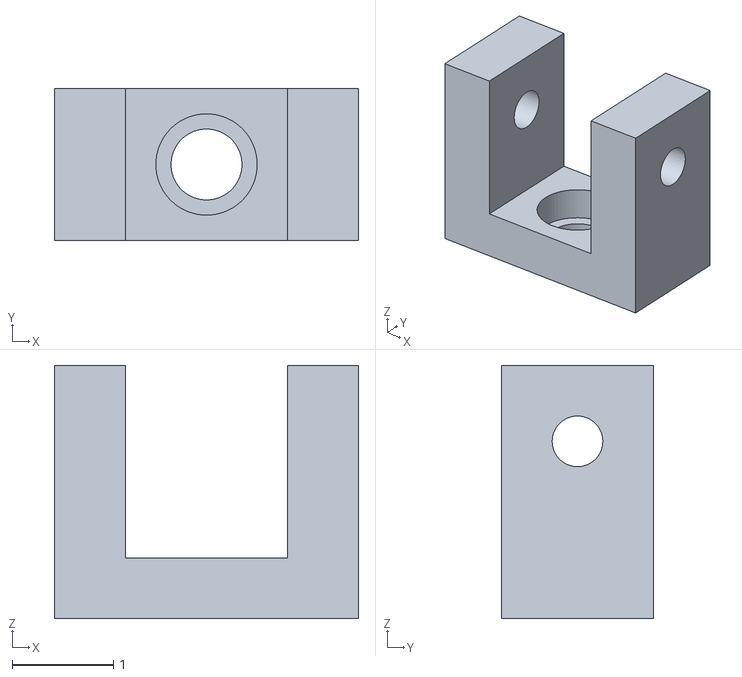
[picture p129: CAD file, 2017-03-12]
doc/CAD/Drawings/STL/Arm_Pulley_Connector.stl
3.00 x 1.50 x 2.50
