EricLeFort/Capstone-Project/doc/CAD/SM2/stl/Piston_Holder.stl

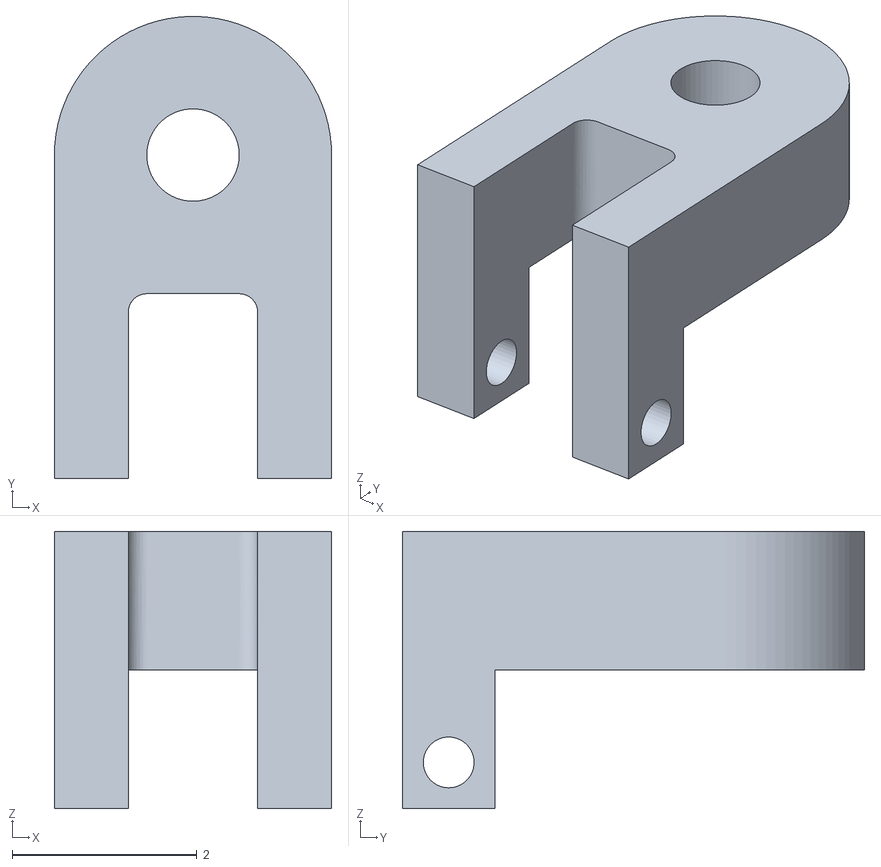
[picture p130: CAD file, 2017-02-24]
doc/CAD/SM2/stl/Piston_Holder.stl
3.00 x 5.00 x 3.00
