EricLeFort/Capstone-Project/(list of files, cad)

Other CAD files:
doc/CAD/Drawings/EE_base_laser_cut(autocad).dwg
doc/CAD/Drawings/parts/Rail_Large_Piece.dwg
doc/CAD/Drawings/EE_base_laser_cut.dwg
doc/CAD/Drawings/parts/Rail_Pulley_Connector.dwg
doc/CAD/Drawings/NEMA 23 Holder.dwg
doc/CAD/Drawings/L-Bracket.dwg
doc/CAD/Drawings/Arm-SquareBar-Rev3-1.dwg
doc/CAD/Drawings/Arm-SquareBar-Rev3.dwg
doc/CAD/Drawings/Y_Rail-SquareBar-Rev3-1.dwg
doc/CAD/Drawings/Arm_Base-SquareBar-Rev3-2.dwg
doc/CAD/Drawings/PulleyHolder.dwg
doc/CAD/Drawings/X_Rail_Components.dwg
doc/CAD/Drawings/1-2in_13tpi.dwg
doc/CAD/Drawings/X_Rail_Components(printable).dwg
doc/CAD/Drawings/X_Rail_Components(Needs Prep for laser cut).dwg
doc/CAD/Drawings/X_Rail-SquareBar-Rev3-1.dwg
doc/CAD/Drawings/Exploded Views/OldVersions/Overall_Shooting_Mechanism2.0001.ipn
doc/CAD/Drawings/Exploded Views/Overall_Shooting_Mechanism2.ipn
doc/CAD/Drawings/Exploded Views/X_rail_Assembly_Rev3.ipn
doc/CAD/Drawings/OldVersions/1-2in_13tpi.0001.dwg
doc/CAD/Drawings/OldVersions/Arm-SquareBar-Rev3-1.0001.dwg
doc/CAD/Drawings/OldVersions/Arm-SquareBar-Rev3.0001.dwg
doc/CAD/Drawings/OldVersions/Arm-SquareBar-Rev3.0002.dwg
doc/CAD/Drawings/OldVersions/Arm_Base-SquareBar-Rev3.0001.dwg
doc/CAD/Drawings/OldVersions/EE_base_laser_cut.0001.dwg
doc/CAD/Drawings/OldVersions/NEMA 23 Holder.0001.dwg
doc/CAD/Drawings/OldVersions/X_Rail-SquareBar-Rev3-1.0001.dwg
doc/CAD/Drawings/OldVersions/X_Rail_Components(Needs Prep for laser cut).0002.dwg
doc/CAD/Drawings/OldVersions/X_Rail_Components(printable).0002.dwg
doc/CAD/Drawings/OldVersions/X_Rail_Components.0001.dwg
doc/CAD/Drawings/OldVersions/Y_Rail-SquareBar-Rev3-1.0001.dwg
doc/CAD/Drawings/parts/NEMA 23 Holder.dwg
doc/CAD/EndEffectorBase/Assembly1.iam
doc/CAD/EndEffectorBase/BallBearing.ipt
doc/CAD/EndEffectorBase/BallBearingCone.ipt
doc/CAD/EndEffectorBase/BallBearingConeLockNut.ipt
doc/CAD/EndEffectorBase/BallBearingCup.ipt
doc/CAD/EndEffectorBase/BallBearingCupMount.ipt
doc/CAD/EndEffectorBase/BallBearingCupMountBottom.ipt
doc/CAD/EndEffectorBase/EEThreadedRod.ipt
doc/CAD/EndEffectorBase/EEThreadedRodNut.ipt
doc/CAD/EndEffectorBase/OldVersions/Assembly1.0020.iam
doc/CAD/EndEffectorBase/OldVersions/BallBearing.0001.ipt
doc/CAD/EndEffectorBase/OldVersions/BallBearingCupMount.0001.ipt
doc/CAD/EndEffectorBase/OldVersions/BallBearingCupMountBottom.0011.ipt
doc/CAD/EndEffectorBase/OldVersions/BigPositionDisk.0008.ipt
doc/CAD/EndEffectorBase/OldVersions/BigPositionDisk.0009.ipt
doc/CAD/EndEffectorBase/OldVersions/EEThreadedRod.0002.ipt
doc/CAD/EndEffectorBase/OldVersions/SmallPositionDisk.0010.ipt
doc/CAD/EndEffectorBase/SmallPositionDisk.ipt
doc/CAD/EndEffectorBase2/9mmRodNut.ipt
doc/CAD/EndEffectorBase2/Assembly1.iam
doc/CAD/EndEffectorBase2/BallBearing.ipt
doc/CAD/EndEffectorBase2/BallBearingCenterer.ipt
doc/CAD/EndEffectorBase2/BallBearingCone.ipt
doc/CAD/EndEffectorBase2/BallBearingHolderBottom.ipt
doc/CAD/EndEffectorBase2/BallBearingHolderTop.ipt
doc/CAD/EndEffectorBase2/BigGearCenterer.ipt
doc/CAD/EndEffectorBase2/BigPositionDisk.ipt
doc/CAD/EndEffectorBase2/BottomWheelHolder.ipt
doc/CAD/EndEffectorBase2/EE-Base-Belt-Holder.ipt
doc/CAD/EndEffectorBase2/EE-Base-Belt-HolderLeft.ipt
doc/CAD/EndEffectorBase2/EE-Base-Belt-HolderRight.ipt
doc/CAD/EndEffectorBase2/MotorBracket.ipt
doc/CAD/EndEffectorBase2/OldVersions/9mmRodNut.0002.ipt
doc/CAD/EndEffectorBase2/OldVersions/Assembly1.0039.iam
doc/CAD/EndEffectorBase2/OldVersions/Assembly1.0042.iam
doc/CAD/EndEffectorBase2/OldVersions/BallBearing.0001.ipt
doc/CAD/EndEffectorBase2/OldVersions/BallBearingCenterer.0001.ipt
doc/CAD/EndEffectorBase2/OldVersions/BallBearingHolderBottom.0008.ipt
doc/CAD/EndEffectorBase2/OldVersions/BallBearingHolderOutside.0001.ipt
doc/CAD/EndEffectorBase2/OldVersions/BallBearingHolderTop.0008.ipt
doc/CAD/EndEffectorBase2/OldVersions/BigGearCenterer.0001.ipt
doc/CAD/EndEffectorBase2/OldVersions/BigPositionDisk.0010.ipt
doc/CAD/EndEffectorBase2/OldVersions/BottomWheelHolder.0008.ipt
doc/CAD/EndEffectorBase2/OldVersions/EE-Base-Belt-Holder.0006.ipt
doc/CAD/EndEffectorBase2/OldVersions/EE-Base-Belt-HolderLeft.0001.ipt
doc/CAD/EndEffectorBase2/OldVersions/MotorBracket.0005.ipt
doc/CAD/EndEffectorBase2/OldVersions/SmallPositionDisk.0011.ipt
doc/CAD/EndEffectorBase2/OldVersions/SmallPositionDisk.0012.ipt
doc/CAD/EndEffectorBase2/OldVersions/ThreadBar90.0001.ipt
doc/CAD/EndEffectorBase2/SmallPositionDisk.ipt
doc/CAD/EndEffectorBase2/ThreadBar127.ipt
doc/CAD/EndEffectorBase2/ThreadBar90.ipt
doc/CAD/Gears/OldVersions/Spur Gear11.0001.ipt
doc/CAD/Gears/OldVersions/Spur Gear21.0002.ipt
doc/CAD/Gears/OldVersions/Spur Gear21.0002_1.ipt
doc/CAD/Gears/OldVersions/Spur Gears1.0003.iam
doc/CAD/Gears/OldVersions/sample.0002.iam
doc/CAD/Gears/Spur Gear11.ipt
doc/CAD/Gears/Spur Gear21.ipt
doc/CAD/Gears/Spur Gears1.iam
doc/CAD/HighLevel/Arm.ipt
doc/CAD/HighLevel/ArmBase3.ipt
doc/CAD/HighLevel/Bridge.ipt
doc/CAD/HighLevel/CameraMount.ipt
doc/CAD/HighLevel/EF-Arm.ipt
doc/CAD/HighLevel/EF-Base.ipt
doc/CAD/HighLevel/End-Effector.ipt
doc/CAD/HighLevel/OldVersions/Arm.0003.ipt
doc/CAD/HighLevel/OldVersions/ArmBase3.0003.ipt
doc/CAD/HighLevel/OldVersions/Bridge.0001.ipt
doc/CAD/HighLevel/OldVersions/CameraMount.0004.ipt
doc/CAD/HighLevel/OldVersions/EF-Arm.0002.ipt
doc/CAD/HighLevel/OldVersions/EF-Base.0001.ipt
doc/CAD/HighLevel/OldVersions/End-Effector.0001.ipt
doc/CAD/HighLevel/OldVersions/Rail.0002.ipt
doc/CAD/HighLevel/OldVersions/YRail.0001.ipt
doc/CAD/HighLevel/OldVersions/highlevel.0011.iam
doc/CAD/HighLevel/Rail.ipt
doc/CAD/HighLevel/YRail.ipt
doc/CAD/HighLevel/highlevel.iam
doc/CAD/LinesensorHolderWasher.stl
doc/CAD/LowLevel_Rev1/EE-Rod-Rev1.ipt
doc/CAD/LowLevel_Rev1/EE_Arm-Rod-Rev1.ipt
doc/CAD/LowLevel_Rev1/EE_Base-Rod-Rev1.ipt
doc/CAD/LowLevel_Rev1/OldVersions/EE-Rod-Rev1.0001.ipt
doc/CAD/LowLevel_Rev1/OldVersions/EE_Arm-Rod-Rev1.0004.ipt
doc/CAD/LowLevel_Rev1/OldVersions/EE_Arm-Rod-Rev1.0005.ipt
doc/CAD/LowLevel_Rev1/OldVersions/EE_Arm-Rod-Rev1.0007.ipt
doc/CAD/LowLevel_Rev1/OldVersions/EE_Base-Rod-Rev1.0002.ipt
doc/CAD/LowLevel_Rev1/OldVersions/Overall_Assembly_Rev1.0022.iam
doc/CAD/LowLevel_Rev1/OldVersions/XY_Wheel-Rod-Rev1.0004.ipt
doc/CAD/LowLevel_Rev1/OldVersions/X_Rail-C_shape-Rev1.0002.ipt
doc/CAD/LowLevel_Rev1/OldVersions/X_Rail-C_shape-Rev1.0003.ipt
doc/CAD/LowLevel_Rev1/OldVersions/X_Rail-Rod-Rev1.0005.ipt
doc/CAD/LowLevel_Rev1/OldVersions/X_Wheel-Rod-Rev1.0002.ipt
doc/CAD/LowLevel_Rev1/OldVersions/X_Wheel-Rod-Rev1.0003.ipt
doc/CAD/LowLevel_Rev1/OldVersions/Y_Rail_Bridge-Rod-Rev1.0002.ipt
doc/CAD/LowLevel_Rev1/OldVersions/Y_Rail_Bridge-Rod-Rev1.0004.ipt
doc/CAD/LowLevel_Rev1/OldVersions/Y_Rail_Bridge-Rod-Rev1.0012.ipt
doc/CAD/LowLevel_Rev1/Overall_Assembly_Rev1.iam
doc/CAD/LowLevel_Rev1/XY_Wheel-Rod-Rev1.ipt
doc/CAD/LowLevel_Rev1/X_Rail-C_shape-Rev1.ipt
doc/CAD/LowLevel_Rev1/X_Rail-Rod-Rev1.ipt
doc/CAD/LowLevel_Rev1/Y_Rail_Bridge-Rod-Rev1.ipt
doc/CAD/LowLevel_Rev2/Arm_Base-Rod-Rev2.ipt
doc/CAD/LowLevel_Rev2/EE_Assembly_Rev2.iam
doc/CAD/LowLevel_Rev2/EE_Base-Rod-Rev2.ipt
doc/CAD/LowLevel_Rev2/OldVersions/Arm_Base-Rod-Rev2.0011.ipt
doc/CAD/LowLevel_Rev2/OldVersions/EE_Assembly_Rev2.0007.iam
doc/CAD/LowLevel_Rev2/OldVersions/EE_Base-Rod-Rev2.0003.ipt
doc/CAD/LowLevel_Rev2/OldVersions/Overall_Assembly_Rev2.0016.iam
doc/CAD/LowLevel_Rev2/OldVersions/Overall_Assembly_Rev2.0019.iam
doc/CAD/LowLevel_Rev2/OldVersions/Pool_Ball_Stripe.0003.ipt
doc/CAD/LowLevel_Rev2/OldVersions/X_rail_Assembly_Rev2.0010.iam
doc/CAD/LowLevel_Rev2/Overall_Assembly_Rev2.iam
doc/CAD/LowLevel_Rev2/Pool_Ball_Stripe.ipt
doc/CAD/LowLevel_Rev2/X_rail_Assembly_Rev2.iam
doc/CAD/LowLevel_Rev3/Arm-Belt-Holder.ipt
doc/CAD/LowLevel_Rev3/Arm-SquareBar-Rev3.ipt
doc/CAD/LowLevel_Rev3/Arm_Base-SquareBar-Rev3-2.ipt
doc/CAD/LowLevel_Rev3/Arm_Base-SquareBar-Rev3.ipt
doc/CAD/LowLevel_Rev3/Arm_Pulley_Connector.ipt
doc/CAD/LowLevel_Rev3/EE_Base-SquareBar-Rev3.ipt
doc/CAD/LowLevel_Rev3/EE_base/EE_base_assembly.iam
doc/CAD/LowLevel_Rev3/EE_base/ForLaserCut.iam
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
