EricLeFort/Capstone-Project/doc/CAD/Drawings/PDFs/X_Rail_Components(printable).pdf

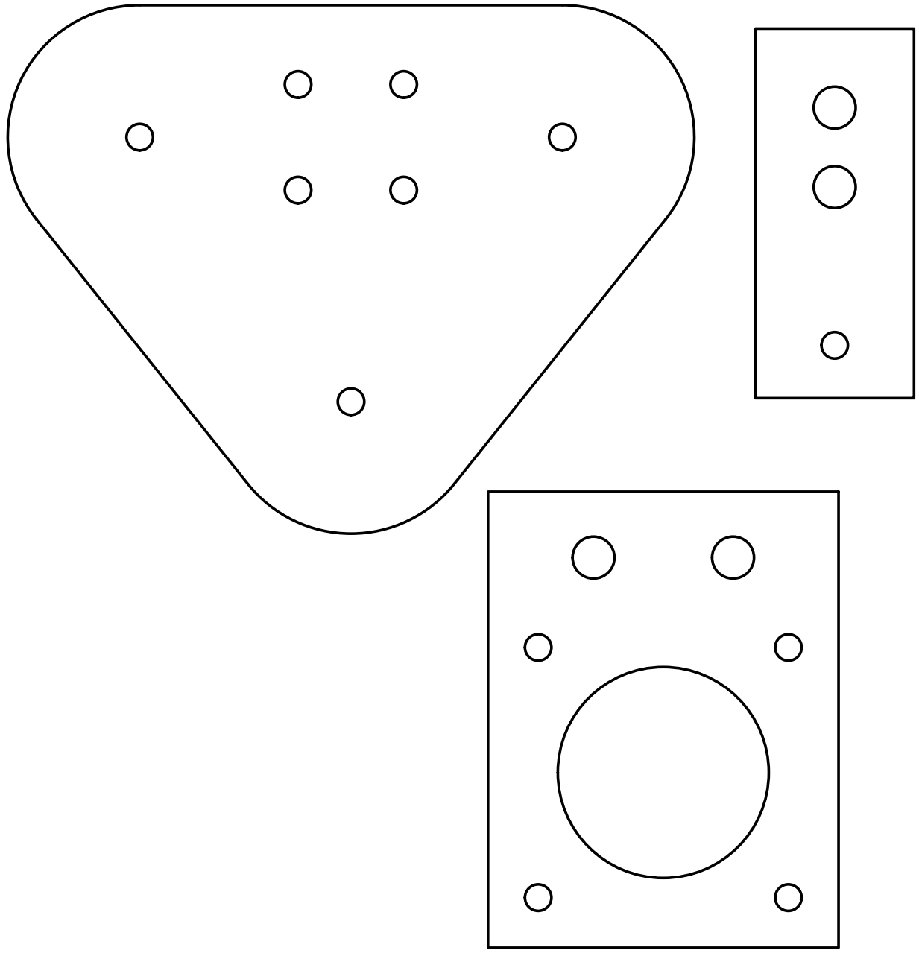
[picture p131: figure]
