EricLeFort/Capstone-Project/doc/VV/img/RESULTPHOTO1.PNG

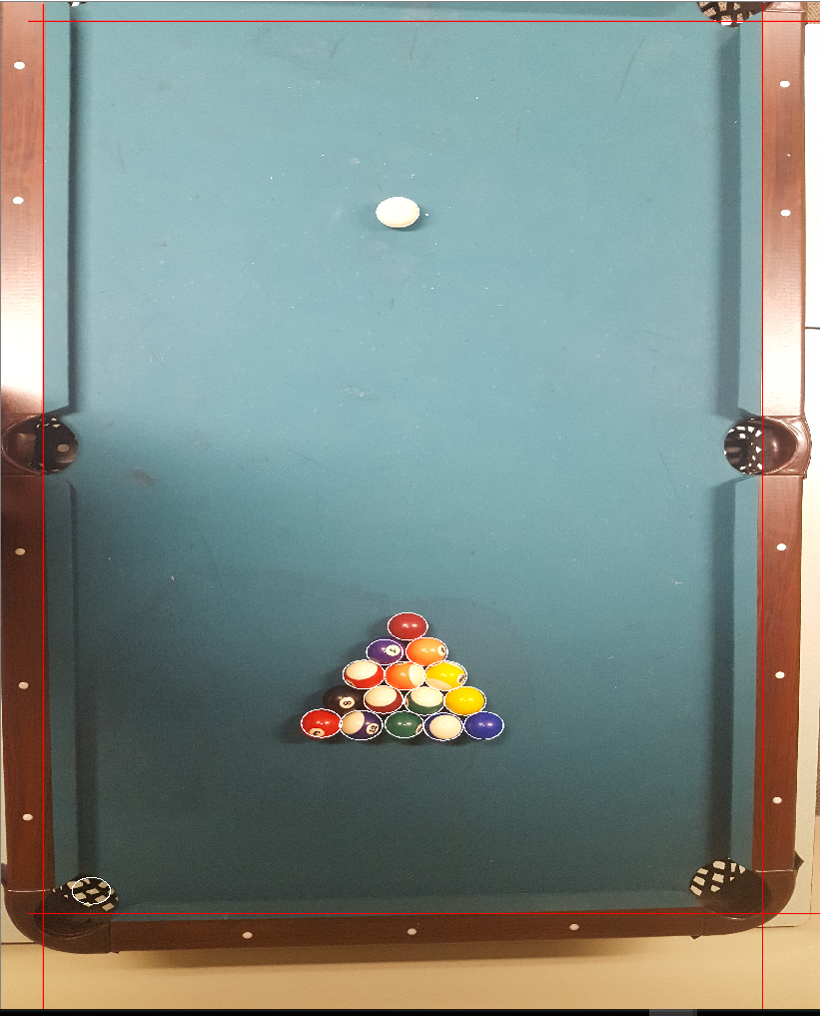
doc/VV/img/RESULTPHOTO1.PNG
