EricLeFort/Capstone-Project/doc/VV/img/RESULTPHOTO2.PNG

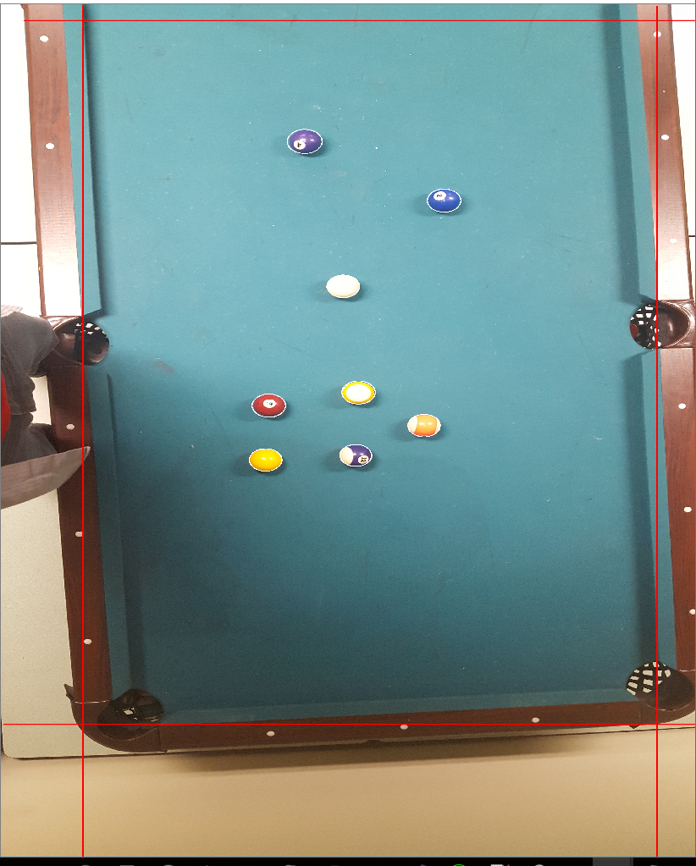
doc/VV/img/RESULTPHOTO2.PNG
