EricLeFort/Capstone-Project/resources/testingImages/tableState1.jpg

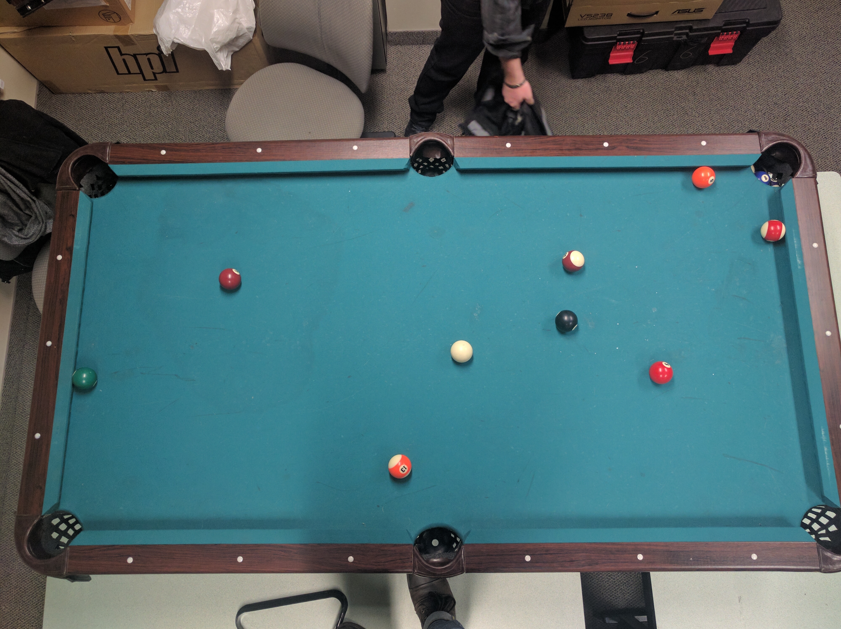
resources/testingImages/tableState1.jpg
