EricLeFort/Capstone-Project/resources/testingImages/tableState2.jpg

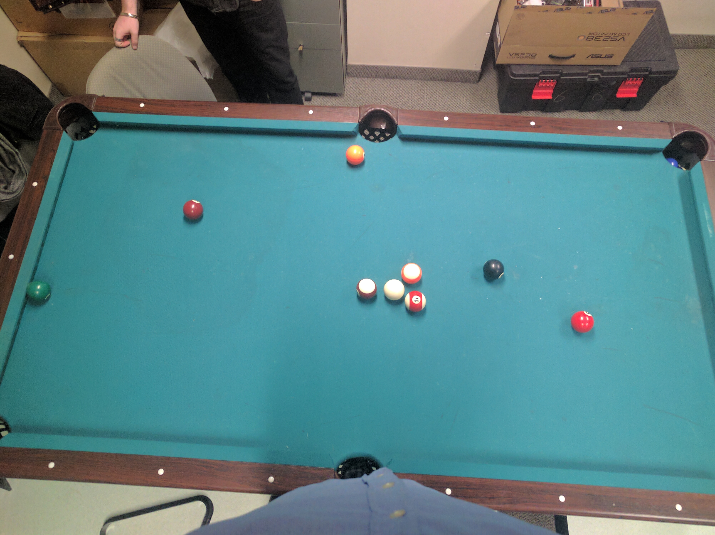
resources/testingImages/tableState2.jpg
