EricLeFort/Capstone-Project/resources/testingImages/tableState3.jpg

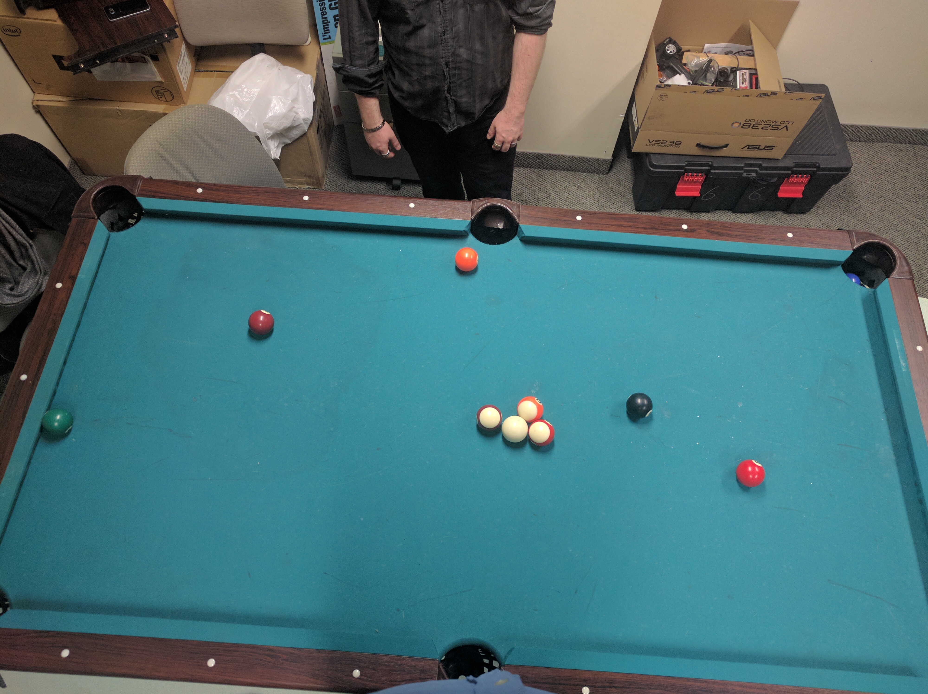
resources/testingImages/tableState3.jpg
