EricLeFort/Capstone-Project/resources/testingImages/tableState4_1.jpg

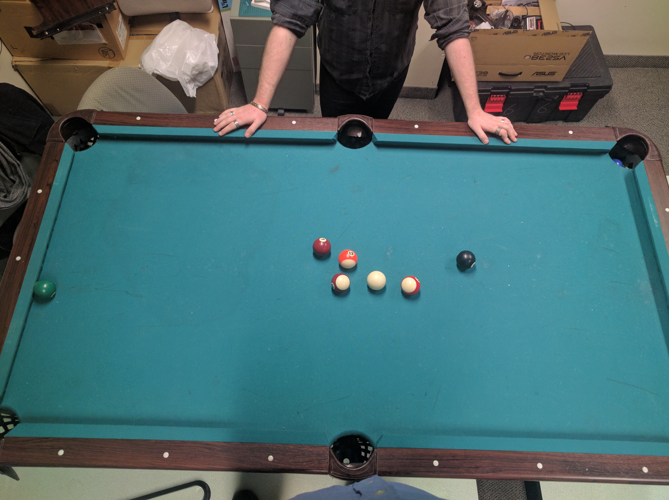
resources/testingImages/tableState4_1.jpg
