EricLeFort/Capstone-Project/resources/testingImages/tableState4_2.jpg

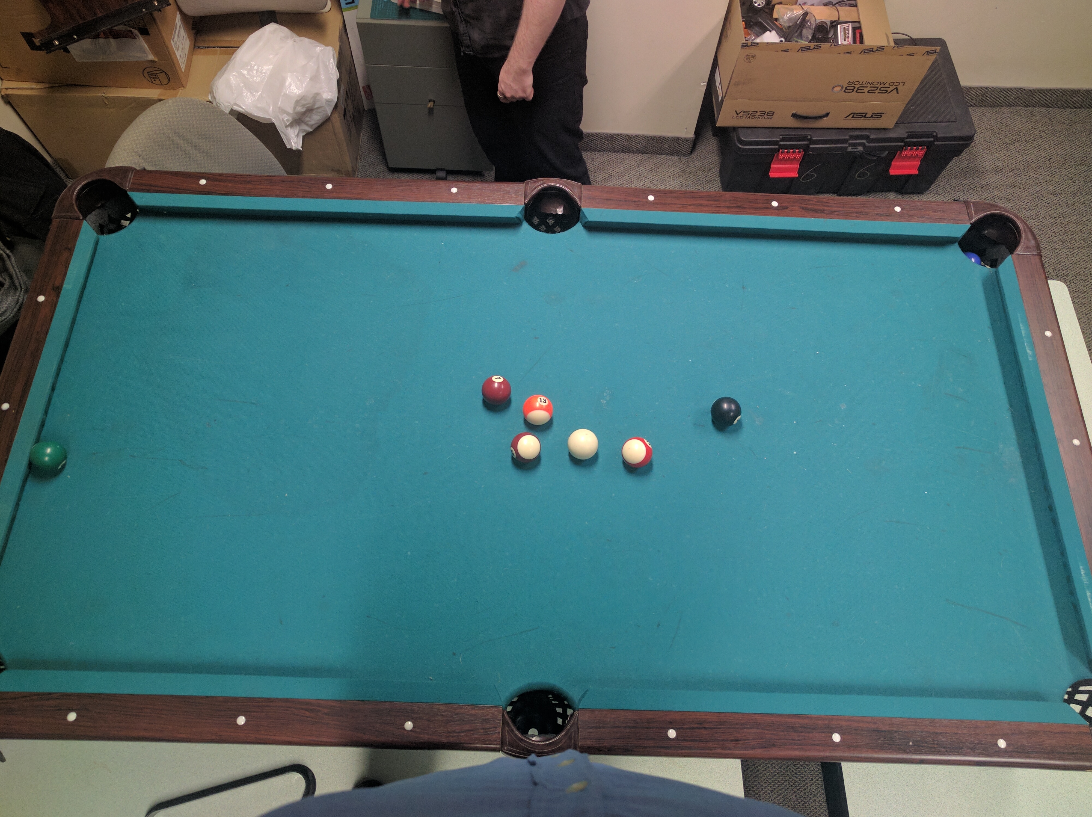
resources/testingImages/tableState4_2.jpg
