EricLeFort/Capstone-Project/resources/testingImages/tableState5.jpg

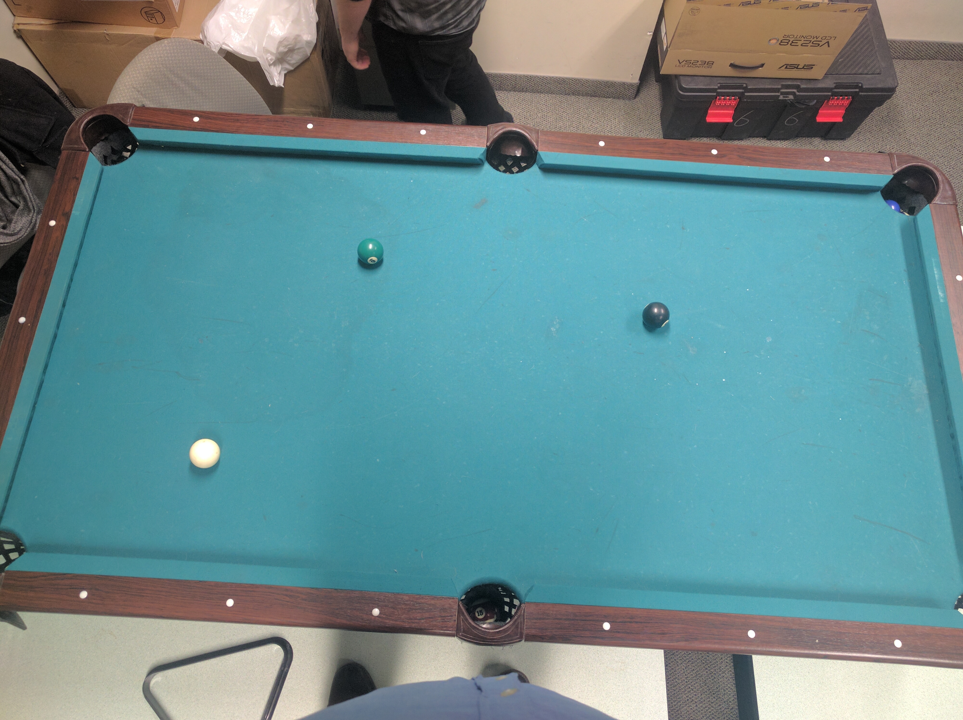
resources/testingImages/tableState5.jpg
