EricLeFort/Capstone-Project/resources/testingImages/tableState6.jpg

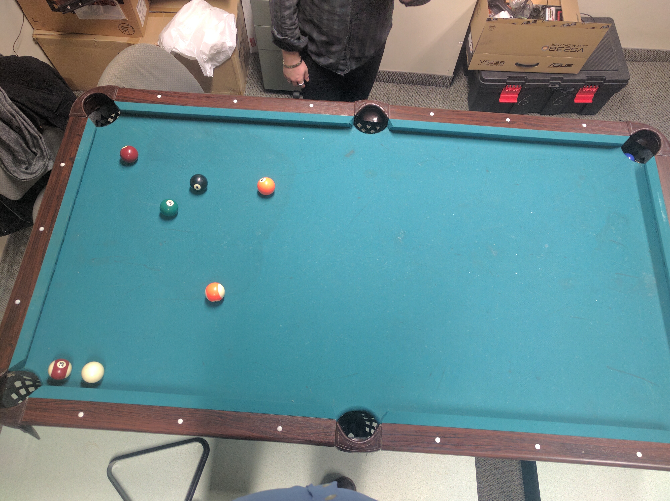
resources/testingImages/tableState6.jpg
