EricLeFort/Capstone-Project/resources/testingImages/tableState7_1.jpg

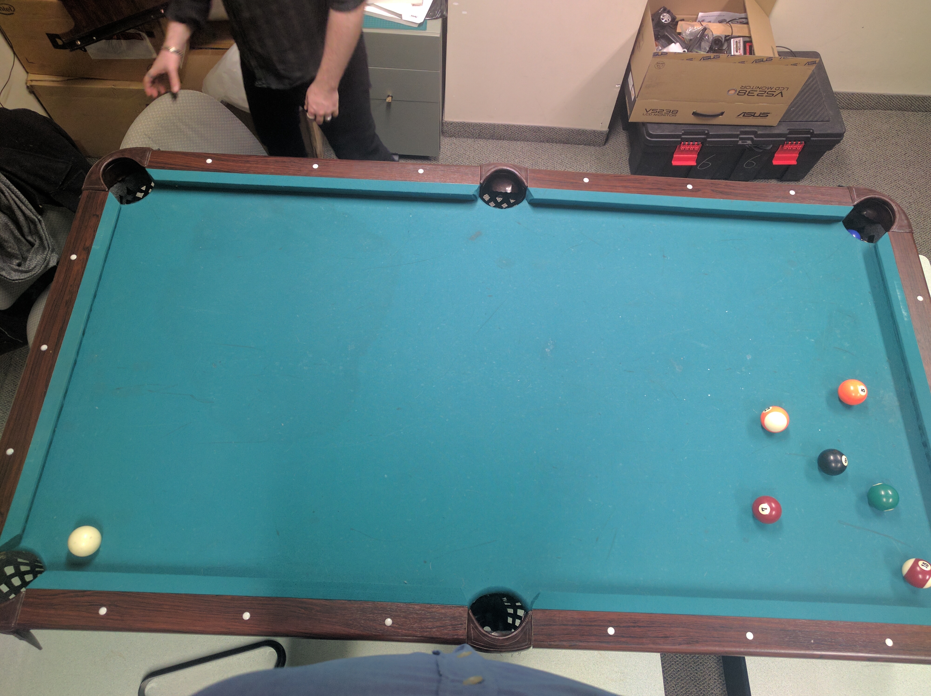
resources/testingImages/tableState7_1.jpg
