EricLeFort/Capstone-Project/resources/testingImages/tableState7_2.jpg

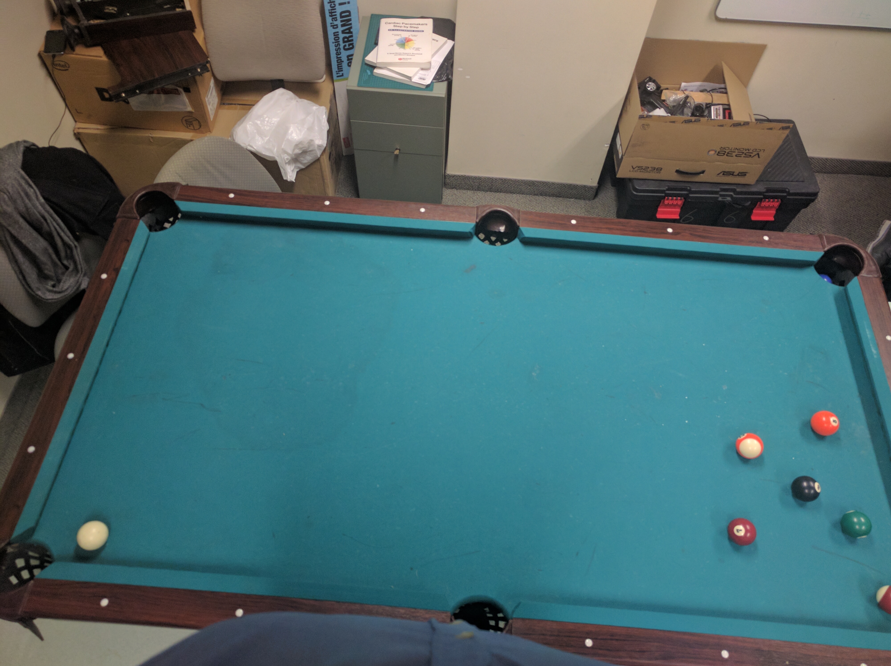
resources/testingImages/tableState7_2.jpg
