EricLeFort/Capstone-Project/resources/testingImages/tableState7_3.jpg

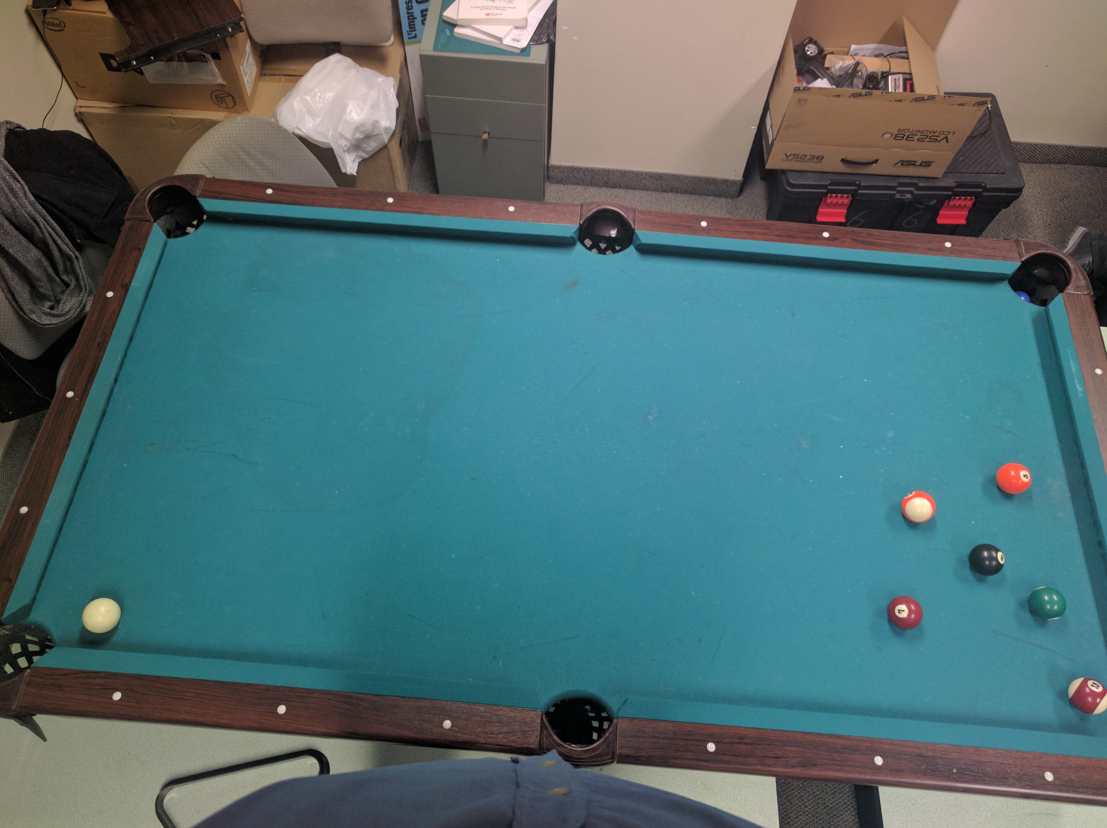
resources/testingImages/tableState7_3.jpg
