EricLeFort/Capstone-Project/resources/testingImages/tableState7_4.jpg

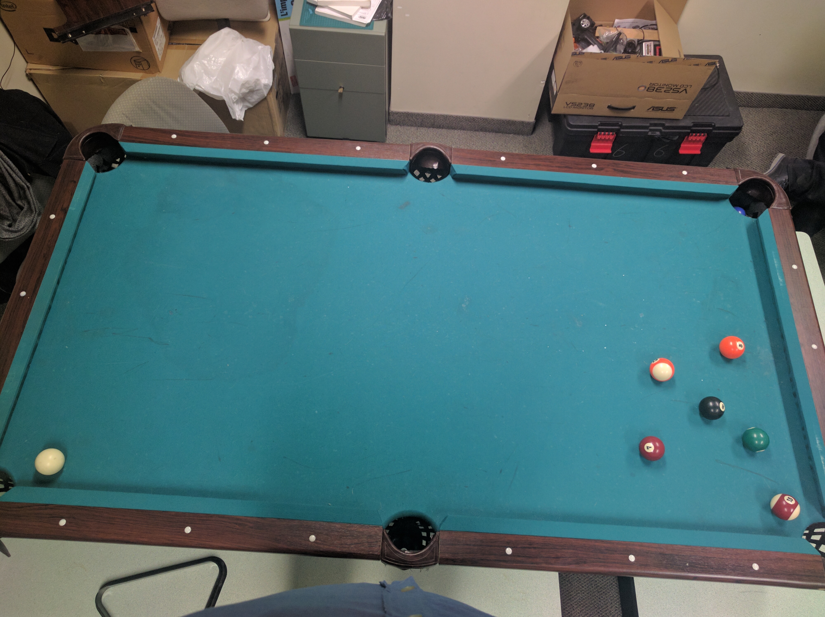
resources/testingImages/tableState7_4.jpg
