EricLeFort/Capstone-Project/doc/HazardAnalysis/HazardAnalysis.pdf

# Autonomous Pool Playing Robot

# Hazard Analysis

Ernest Selman
selmae@mcmaster.ca
1201291

Guy Meyer
meyerg@mcmaster.ca
1320231

Eric Le Fort
leforte@mcmaster.ca
1308609

Andrew Danha
danhaas@mcmaster.ca
1223881

Derek Savery
saverydj@mcmaster.ca
1219142

Max Moore
moorem8@mcmaster.ca
1320009

March 20, 2017

## Contents

1 Overview | 2
1.1 Naming Conventions & Definitions | | 2
1.1.1 | Definitions | | 2
1.1.2 | Acronyms & Abbreviations | | 2
2 Background | 3
3 Scope and Boundary | 3
4 Hazards | 4
4.1 User caught in a Pinch Point | | 5
4.2 Harmful Pneumatic Activation | | 6
4.3 Jumping Pool Balls | | 7
4.4 Dangerous Machine Traversal | | 8
4.5 Loose Objects Snagged | | 9
4.6 Sensor Interference by Outside Sources | 10
4.7 Non-Responsive UI | 11
4.8 Overheating | 12
4.9 Electric Shock | 13
4.10 Motion Interference | 14

## List of Tables

1 | Revision History | | 1
2 | Definitions | | 2
3 | Acronyms and Abbreviations | | 2

## List of Figures

1 | System FTA | | 4
2 | FTA for a user caught in a pinch point | | 5
3 | FTA for harmful pneumatic activation | | 6
4 | FTA for jumping pool balls | | 7
5 | FTA for dangerous machine traversal | | 8
6 | FTA for loose objects being snagged | | 9
7 | FTA for sensor interference by outside sources | 10
8 | FTA for non-responsive UI | 11
9 | FTA for overheating | 12
10 | FTA for Electric Shock | 13
11 | FTA for Motion Interference | 14
Date | Revision # | Comments | Authors
05/01/2017 | 0 | - Initial document creation | Eric Le Fort
06/01/2017 | 0 | - First draft | Eric Le Fort
11/03/2017 | 1 | - Revision 1 | Andrew Danha Derek Savery

Table 1: Revision History

## 1 Overview

This document’s purpose is to help illustrate potential hazards associated with the automated pool-playing robot and how those hazards are to be addressed. Hazards include both safety risks to users as well as structural/monetary risks to the machine. The Hazards section will describe the section in more detail as well as provide an overall Fault-Tree Analysis (FTA) for this system. Each hazard will have its own subsection which will describe the hazard, discuss mitigation and/or plans of avoidance as well as provide a more detailed view of the portion of the FTA it concerns.

Certain sections may refer to the supporting documents: High-Level Hardware Design and High-Level Software Design for this project.

### 1.1 Naming Conventions & Definitions

This section outlines the various definitions, acronyms and abbreviations that will be used throughout this document in order to familiarize the reader prior to reading.

### 1.1.1 Definitions

Table 2 lists the definitions used in this document. The definitions given below are specific to this document and may not be identical to definitions of these terms in common use. The purpose of this section is to assist the user in understanding the requirements for the system.

Table 2: Definitions

Term | Meaning
X-axis | Distance along the length of the pool table
Y-axis | Distance across the width of the pool table
Z-axis | Height above the pool table
End-effector | The end of the arm that will strike the cue ball
θ | Rotational angle of end-effector
Cue | End-effector

### 1.1.2 Acronyms & Abbreviations

Table 3 lists the acronyms and abbreviations used in this document.

Table 3: Acronyms and Abbreviations

Acronym/Abbreviation | Meaning
VR | Visual Recognition
µC | Micro-Controller
FTA | Fault-Tree Analysis

## 2 Background

The potential hazards associated with this system can be found by examining other products and their solutions to the respective hazards.

This machine uses a similar traversal system as a household 3D printer. 3D printers contain multiple moving parts and are labeled with warnings to keep hands and fingers clear during operation, due to the multiple pinch points. Some 3D printers solve this issue by enclosing the entire printer in a sealed environment. 3D printers can also pose as an electrical shock hazard, as with any electrical equipment. 3D printers also include delicate electronics and sensors. Users are advised to handle with care since hampering with them can cause the 3D printer to operate incorrectly.

## 3 Scope and Boundary

Hazard analysis performed in this document will be contained to the scope of mechanical, electrical, and software aspects of the machine.

Integrity of the pool table, pool balls, and pool cues will not be discussed. Robustness of raw materials used in the physical build of the mechanical system will not be discussed. Reliability of the motors, sensors, transformer unit, AC/DC unit, electrical wiring, motor controllers, µC, and pc unit will not be discussed unless it relates to a specific way in which the components are to be used. The stated individual components will in this way be treated as black-box systems in which the reliability of outputs are assumed.

All hazards are applicable to the case in which a single user is interacting with the machine with the assumption made that the user is not behaving in an intentionally destructive manner.

## 4 Hazards

This section will outline all identified hazards associated with this system. Each hazard will be described, plans for avoid-ing and/or mitigating the effects of that risk will be stated, and a more-detailed FTA for that hazard will be provided.

The following diagram is the FTA for the system with the hazard specific details abstracted out.

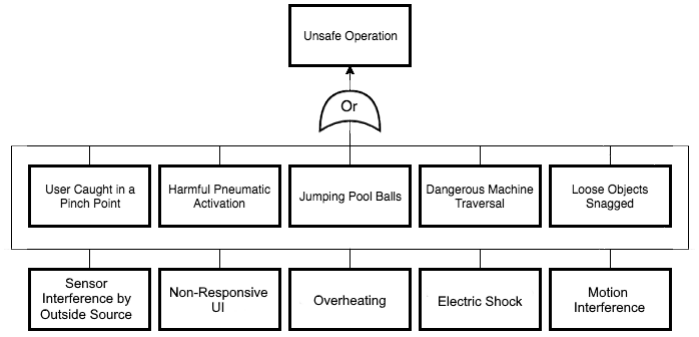
[picture p157: figure]

Figure 1: System FTA

### 4.1 User caught in a Pinch Point

Description
When parts in a machine move in close proximity to one another, there is always a risk of harmful pinching. In this project, there are two locations where this may pose a notable risk: where the x-rails meet the arm base and where the y-rail meets the end-effector base.

Plans for Avoidance/Mitigation
All pinch points will be clearly marked in order to signify the danger they present. Furthermore, emergency stop buttons will be located within reach of all pinch points in the case that a user finds themselves being harmed. This allows the damage to be minimized as much as possible in the case of a pinch. Also, a warning will be printed in a visible location on the system in order to warn users of this risk.

The following diagram provides specific details for this hazard:

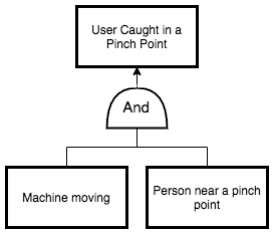
[picture p158: figure]

Figure 2: FTA for a user caught in a pinch point.

### 4.2 Harmful Pneumatic Activation

Description
The pneumatic actuator will involve a very fast-moving component in order to strike the cue ball with sufficient force. If there is something in the way of the end-effector other than the cue ball such as the table, other parts of the machine, or a person, there is likely to be resulting damage.

Plans for Avoidance/Mitigation
When the machine is about to take a shot a warning message or sound can be audibly played by the controller in order to alert the user to the upcoming movement. The machine will pause after this sound to allow the user time to stop the machine if there is an issue.

The following diagram provides specific details for this hazard:

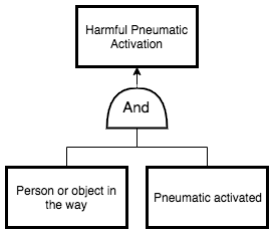
[picture p159: figure]

Figure 3: FTA for harmful pneumatic activation.

### 4.3 Jumping Pool Balls

Description
Pool balls have a tendency to jump off the table if struck in a certain way. If the ball bounces off of the table, there is potential for damage to the machine, the surrounding environment, or a person.

Plans for Avoidance/Mitigation
The end-effector will be designed in such a way that even when striking at its maximum force, the pool balls will never lose contact with the table. However, the user will still be playing on the table and might jump the balls. There is not much able to be done in terms of protecting other people or the surrounding environment unfortunately but the machine itself will be made in such a way that it is durable in areas where a jumping ball will be likely to hit it.

The following diagram provides specific details for this hazard:

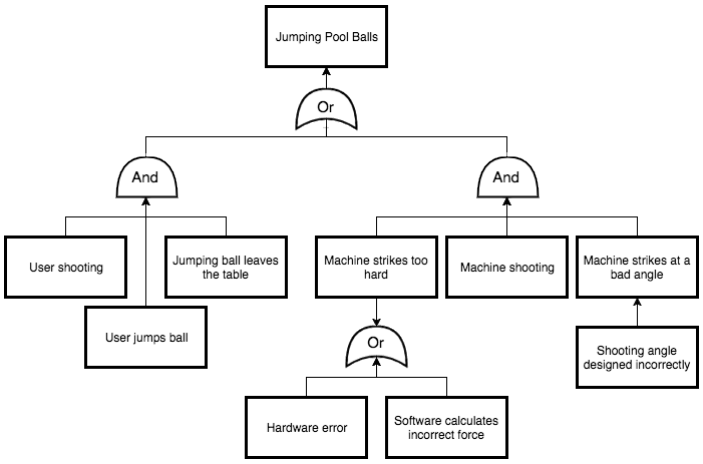
[picture p160: figure]

Figure 4: FTA for jumping pool balls.

### 4.4 Dangerous Machine Traversal

Description
While the machine is traversing, anything in the way may be at risk. For example, depending on the speed, there could be damage due to impact. Another less severe example could involve knocking off items on the edges of the table.

Plans for Avoidance/Mitigation
In order to avoid high speed impacts, the controller will simply not permit motion faster than a certain, safe speed. In terms of the knocking of items off the table, a warning will be printed in a visible location on the system in order to warn users of that risk. In addition, a warning message or sound can be audibly played by the controller in order to alert the user to upcoming movement. The machine will pause after this sound to allow the user time to stop the machine if there is an issue.

The following diagram provides specific details for this hazard:

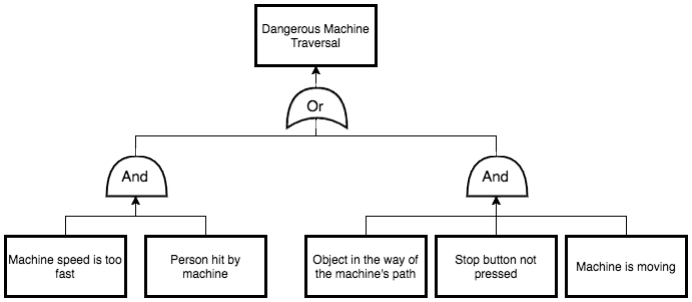
[picture p161: figure]

Figure 5: FTA for dangerous machine traversal.

### 4.5 Loose Objects Snagged

Description
At various locations – namely the pinch points listed earlier as well as the rotational motor on the end-effector base and the belts on the x- and y-rails – loose clothing, jewellery or long hair may be caught and pulled in. If these objects are attached to a person, this can lead to strangulation or being pulled into dangerous areas of the machine.

Plans for Avoidance/Mitigation
For this hazard protective guards will be mounted around moving parts in order to prevent the machine from snagging loose objects. Additionally, emergency stop buttons will be located within reach of all moving parts in the case that an object should become snagged. Lastly, a warning will be printed in a visible location on the system in order to warn users of this risk.

The following diagram provides specific details for this hazard:

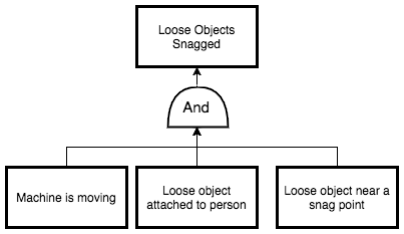
[picture p162: figure]

Figure 6: FTA for loose objects being snagged.

### 4.6 Sensor Interference by Outside Sources

Description
The machine makes use of delicate sensors in order to facilitate safe and accurate motion along the x-rail, y-rail, and rotation arm. Should these sensors be interfered with such that they no longer generate expected results the performance of the machine will be jeopardized. Physical activation of the sensors by outside sources can cause the machine to lose track of it’s current position thus resulting in faulty shot taking. Deactivation of the sensors can cause the machine to run into the ends of the x and y rails, thus resulting in damage to the machine.

Plans for Avoidance/Mitigation
In order to avoid physical interference to the sensors by outside sources the sensors will be encased in protective shielding that will make it difficult for accidental manual activation to occur. Furthermore, the sensors will only be monitored by the software system while the machine is in motion. Any physical interference which occurs during the user’s turn (user operation) will thereby be ignored. In order to avoid undesired deactivation of sensors the sensor wiring will be encased in durable heat shrink tubing and will be closely affixed to the machine so as to minimize potential catch points.

The following diagram provides specific details for this hazard:

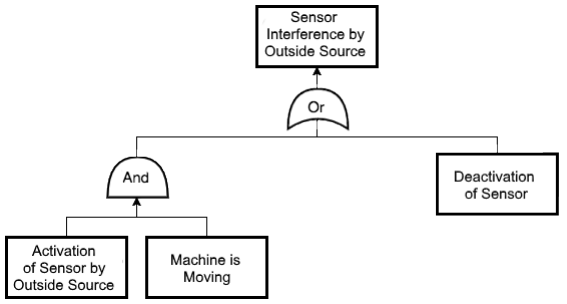
[picture p163: figure]

Figure 7: FTA for sensor interference by outside sources.

### 4.7 Non-Responsive UI

Description
The machine makes use of user input buttons in order to allow the user to control the machine. The functionality of the user buttons allows the user to inform the machine that: the user wishes to take a turn (stop all automated machine functionality), the user wishes for the machine to take a turn, or the user wishes for the machine to move/stop moving to either ends of the table such that the user can take an unobstructed shot. In the case that these user controls should become unresponsive the performance of the machine can become undesirable and therefore dangerous.

Plans for Avoidance/Mitigation
In order to mitigate the likelihood of unresponsive UI the system will be designed such that reliablility of user buttons are a priority. The action of a button press should give reliable and repeatable results. The system will be thoroughly tested to ensure that the hardware and software associated with user buttons are robust and responsive. Furthermore, in the event that UI becomes unresponsive there will be an emergency shut off switch located near the user buttons which when thrown will introduce a break in the power supply of the circuit and stop all motion of the machine.

The following diagram provides specific details for this hazard:

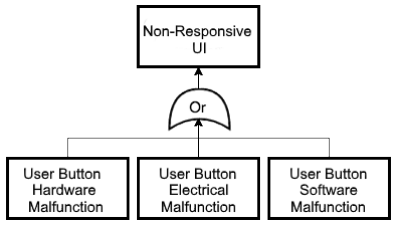
[picture p164: figure]

Figure 8: FTA for non-responsive UI.

### 4.8 Overheating

Description
The machine makes use of high-torque stepper motors to facilitate motion in the x, y and r directions. These motors draw high levels of current and are controlled through the use of motor controllers hooked into the µC. The motor controllers can generate a considerable level of heat during normal operation of the machine. This heat may result in injury to any users who come in contact with the motor controllers or may result in destruction of the motor controllers themselves.

Plans for Avoidance/Mitigation
In order to mitigate the threat of injury from user interaction with high temperature components the µC with attached motor controllers will be isolated via ventilated and thermally resistant protective shielding. Furthermore, each motor controller will have a heatsink attached via thermally conductive adhesive. This will serve to protect the controllers from destruction due to overheating.

The following diagram provides specific details for this hazard:

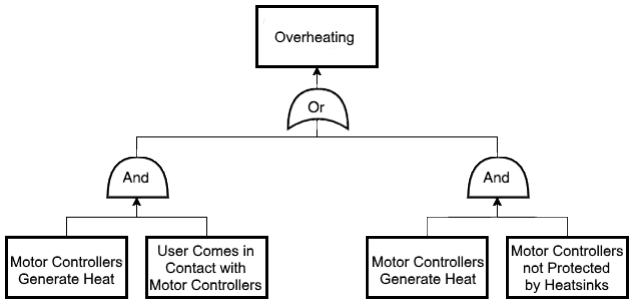
[picture p165: figure]

Figure 9: FTA for overheating.

### 4.9 Electric Shock

Description
The machine has motor leads running along the sides of the pool table, wires connecting the sensors distributed along the table to the µC, and wires to connect the µC to power. Some of these wires are prone to tear since they will be extended and twisted as the system traverses over the table. The wires may also be accidentally pulled by the user and break as a result. If the insulation on any of these wires is broken it could pose as an electric shock hazard to a user operating the system.

Plans for Avoidance/Mitigation
In order to mitigate the threat of injury from electric shock all wires will be neatly tucked into the system as to not interfere with a user operating the system. Wires will be affixed so as to keep wire slack from hanging, this will act to mitigate a tripping hazard in addition to electric shock.

The following diagram provides specific details for this hazard:

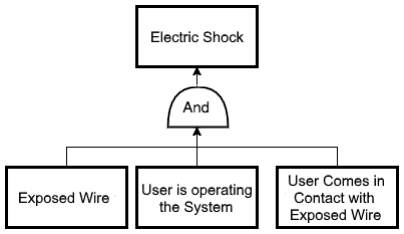
[picture p166: figure]

Figure 10: FTA for Electric Shock.

### 4.10 Motion Interference

Description
Since the user will be playing very closely to the machine there is high potential for outside interference to the system’s motion. The timing belt is a primary source of interference since it is sensitive to wear. If the timing belt wears out it may potentially slip, causing unintentional movement of the system. Motors are another source of interference. If a set of motor leads should become disconnected while the system is in operation the machine’s ability to traverse above the table will be restricted. Lastly, if a foreign object gets in the way of the machine while it is in motion this would result in interference to the system.

Plans for Avoidance/Mitigation
In order to mitigate any unintentional sources of interference the system will only begin its turn once the user presses a button. The system will also use a colour-changing LED light to indicate that it will begin moving. This will inform the user to step back from the machine. The system will be programmed to only trigger the endstop interrupts when the machine is in motion, so if the user activates the endstops during their turn the system will be unaffected. The motor leads will be tucked away neatly and out of the way so as to prevent accidental snagging of the wires.

The following diagram provides specific details for this hazard:

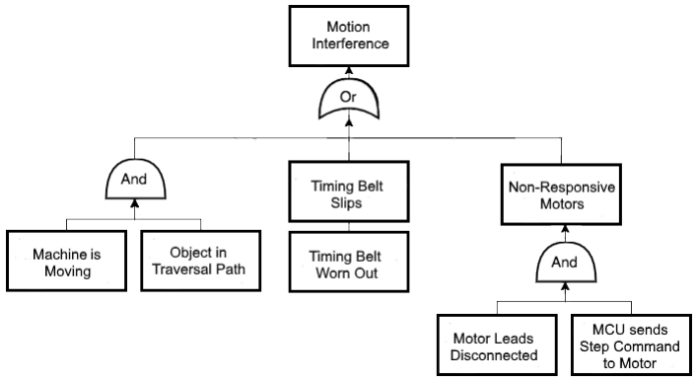
[picture p167: figure]

Figure 11: FTA for Motion Interference.
