EricLeFort/Capstone-Project/doc/CAD/Drawings/PDFs/X_Rail_Components(Needs Prep for laser cut).pdf

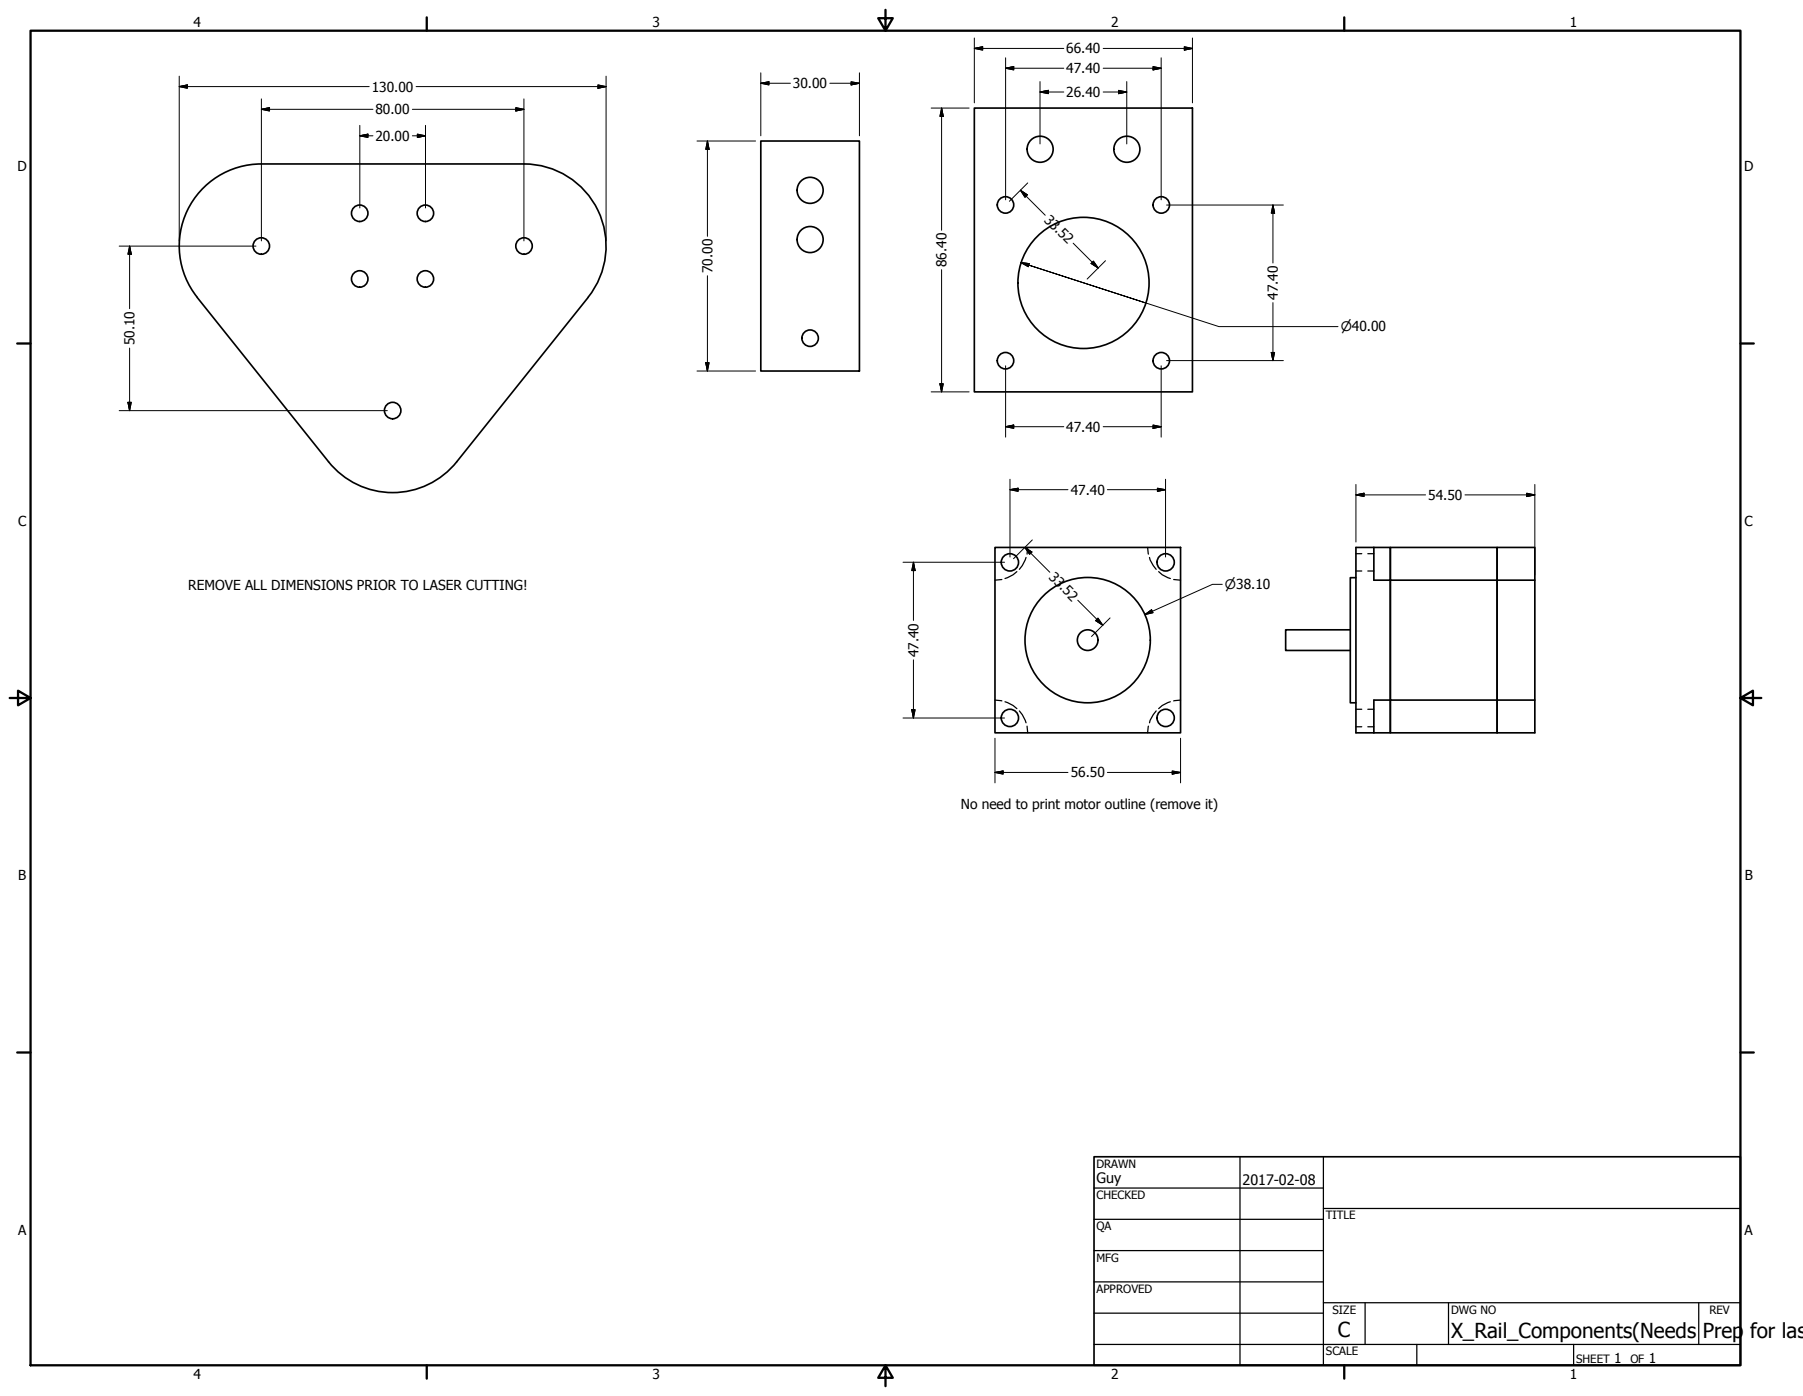
[picture p168: page 1]
SHEET 1 OF 1; DRAWN; CHECKED; MFG; APPROVED; Guy; DWG NO; X_Rail_Components(Needs; Prep for laser cut); TITLE; SIZE C; SCALE; REV

REMOVE ALL DIMENSIONS PRIOR TO LASER CUTTING!

No need to print motor outline (remove it)
