EricLeFort/Capstone-Project/doc/CAD/Drawings/PDFs/L-Bracket.pdf

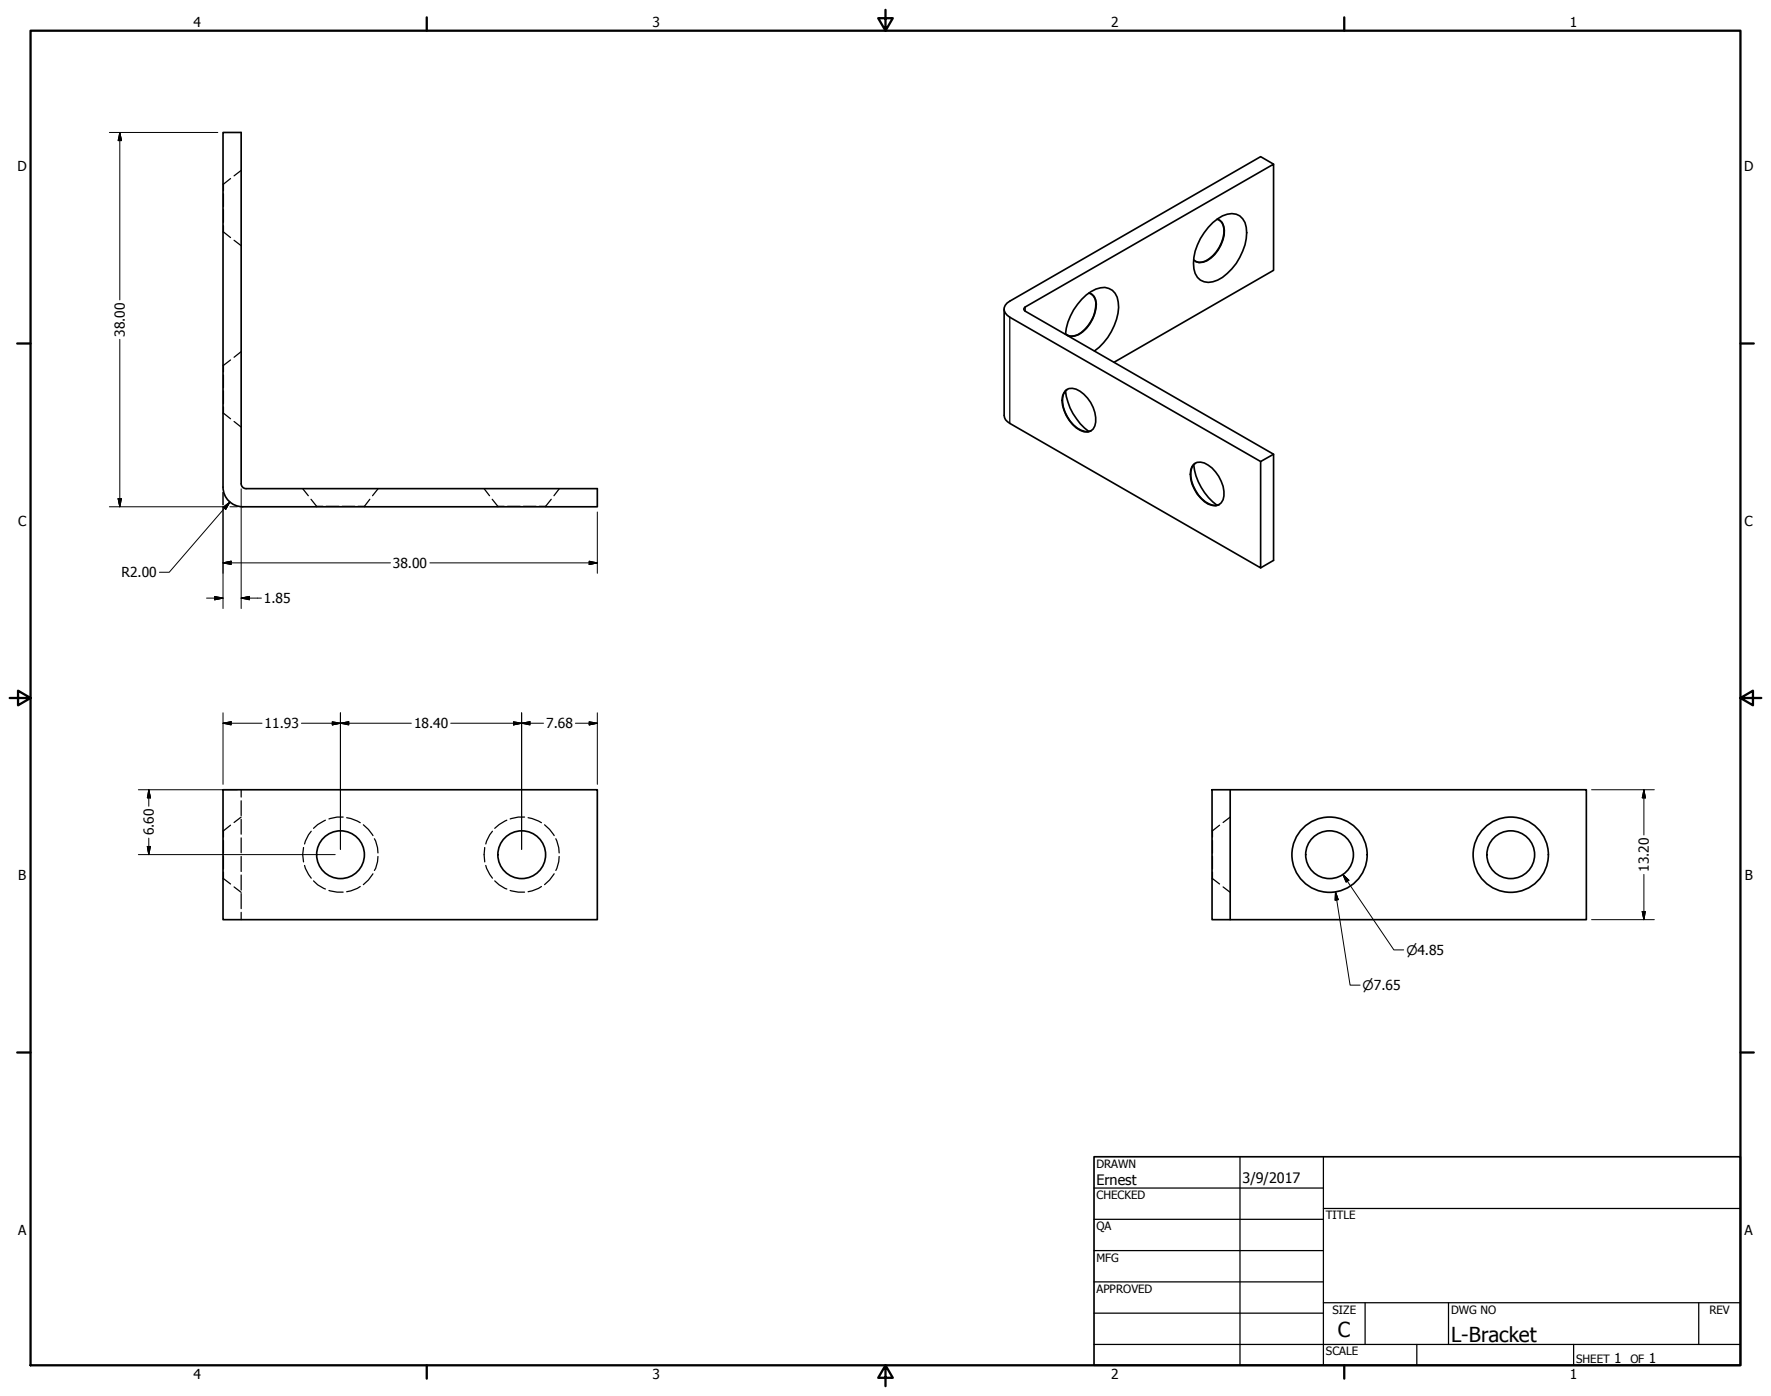
[picture p169: page 1]
SHEET 1 OF 1; DRAWN; CHECKED; MFG; APPROVED; Ernest; DWG NO L-Bracket; TITLE; SIZE C; SCALE; REV
