EricLeFort/Capstone-Project/doc/CAD/Drawings/PDFs/Arm-SquareBar-Rev3-1.pdf

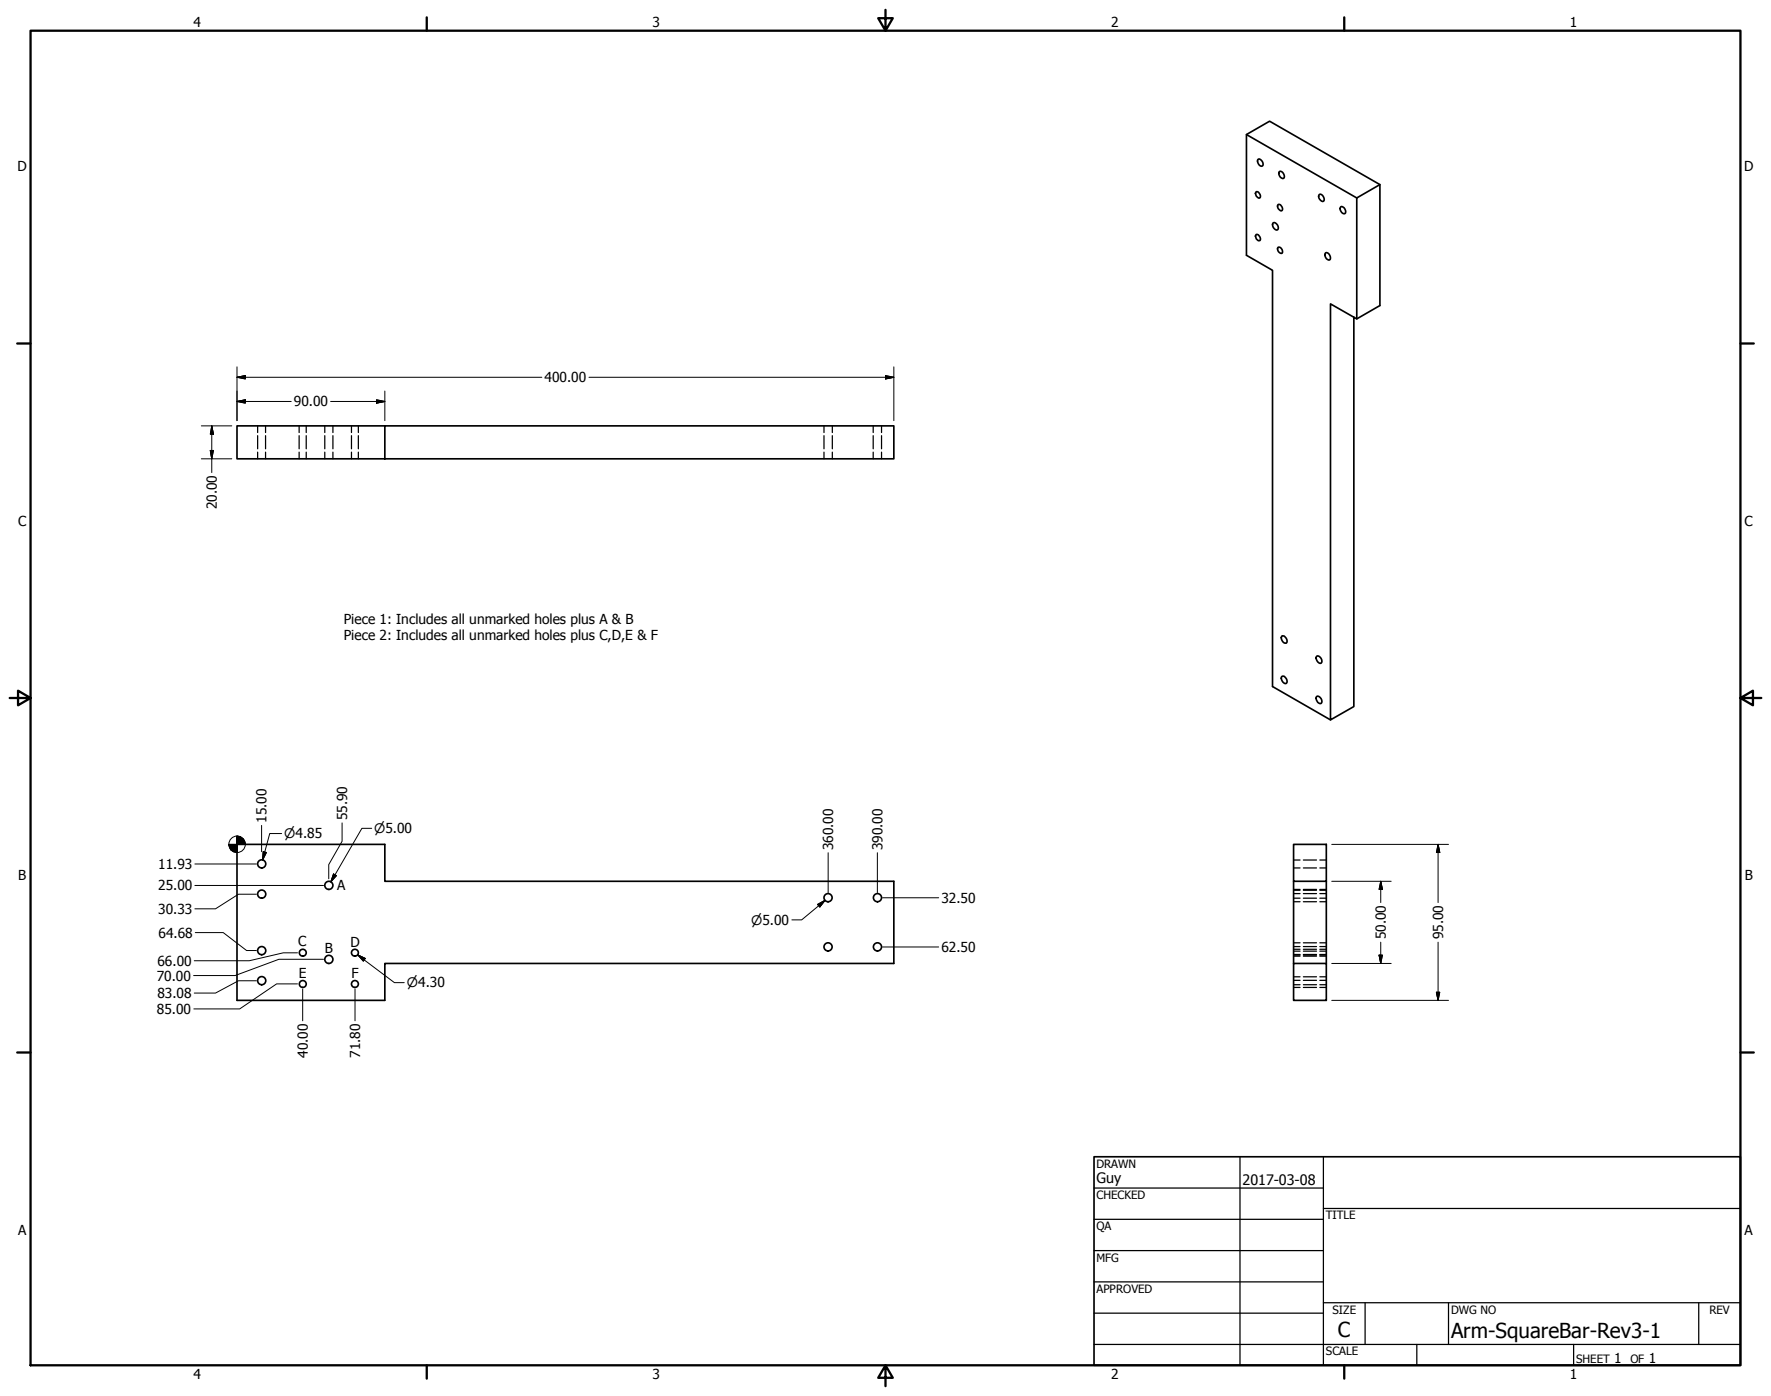
[picture p170: page 1]
SHEET 1 OF 1; DRAWN; CHECKED; MFG; APPROVED; Guy; DWG NO Arm-SquareBar-Rev3-1; TITLE; SIZE C; SCALE; REV

Piece 1: Includes all unmarked holes plus A & B
Piece 2: Includes all unmarked holes plus C,D,E & F
