EricLeFort/Capstone-Project/doc/CAD/Drawings/PDFs/Arm-SquareBar-Rev3.pdf

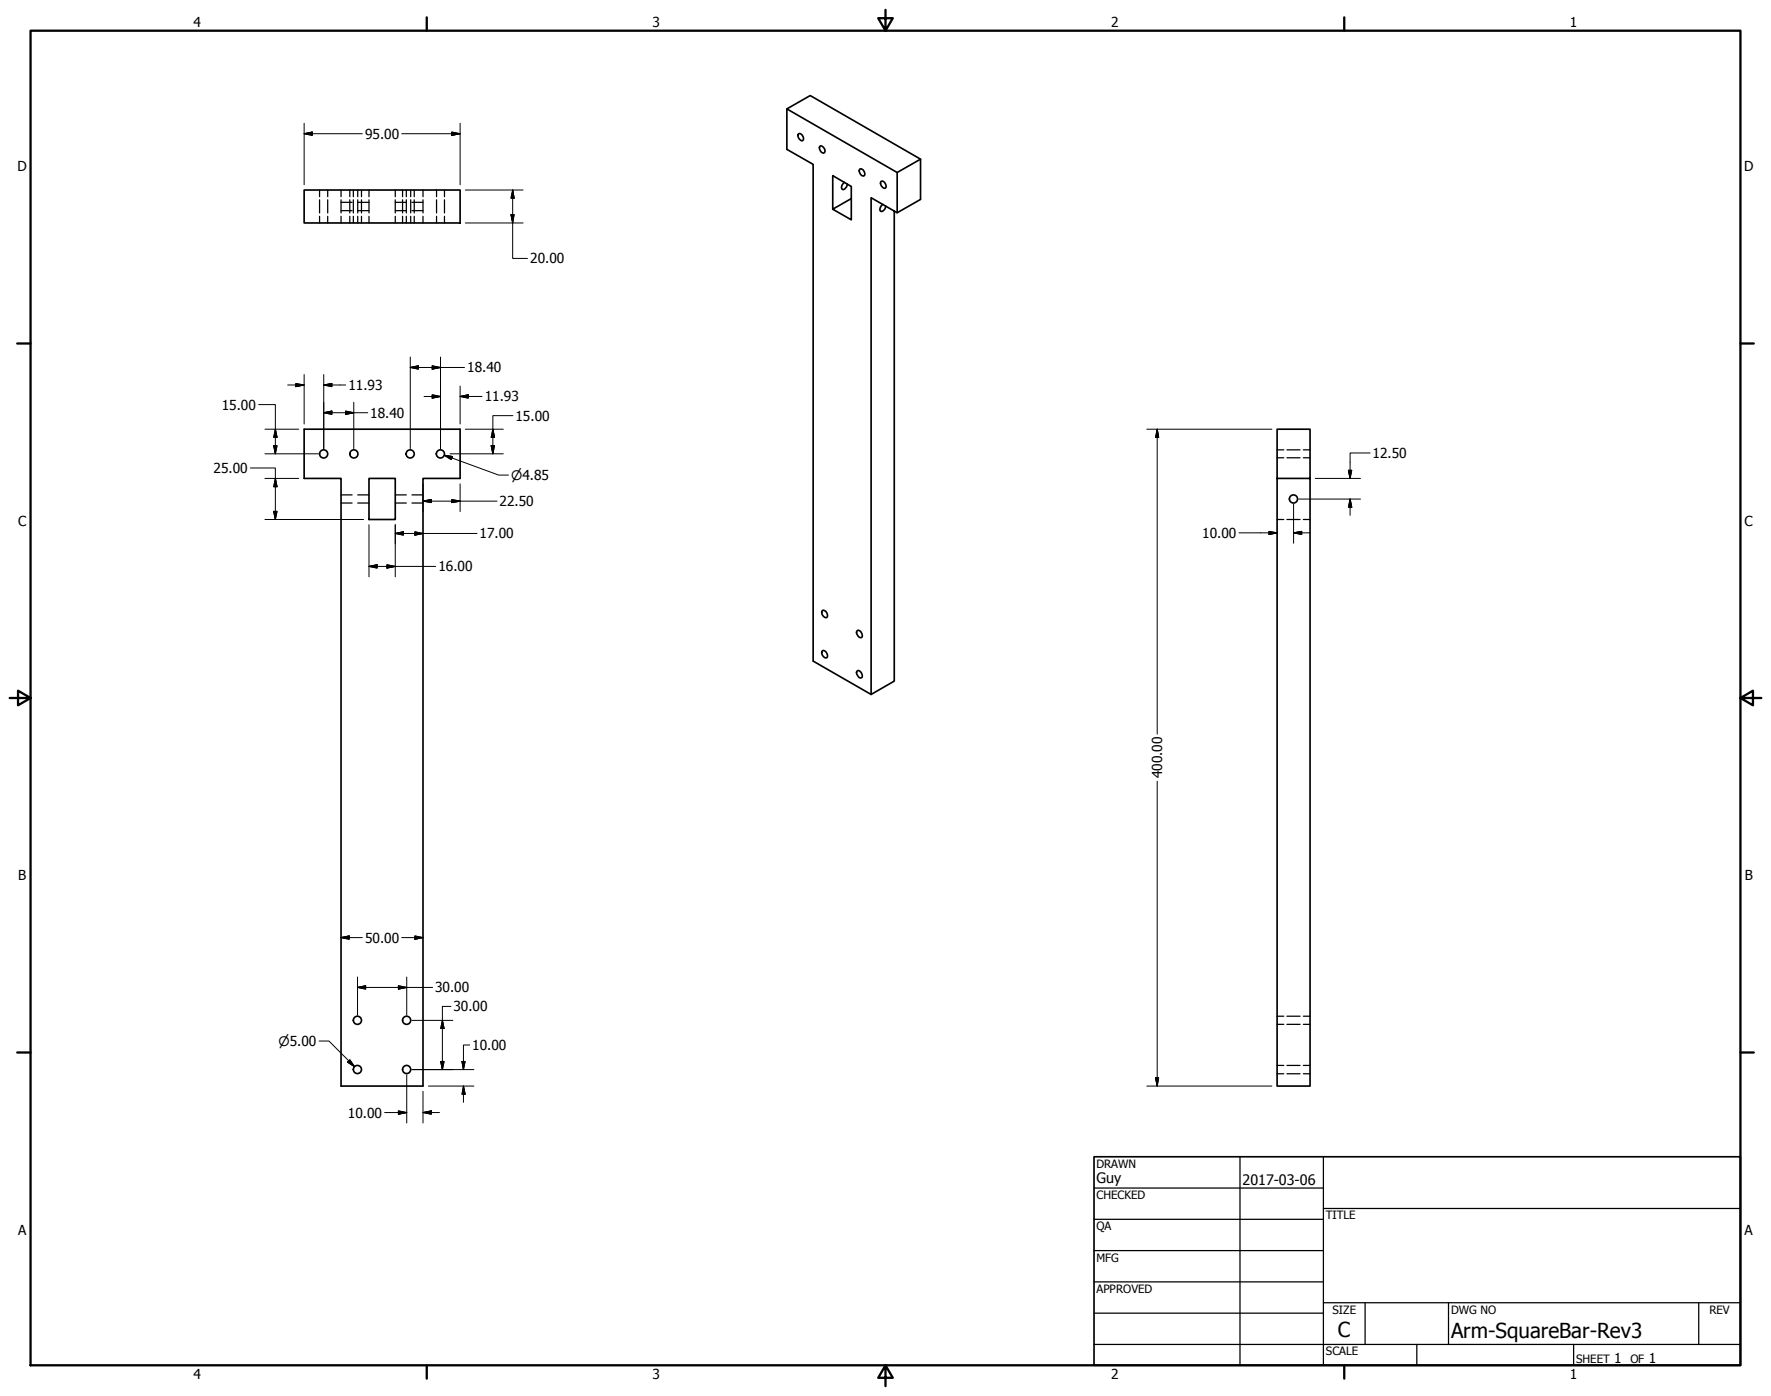
[picture p171: page 1]
SHEET 1 OF 1; DRAWN; CHECKED; MFG; APPROVED; Guy; DWG NO Arm-SquareBar-Rev3; TITLE; SIZE C; SCALE; REV
