EricLeFort/Capstone-Project/doc/CAD/Drawings/PDFs/X_Rail-SquareBar-Rev3-1.pdf

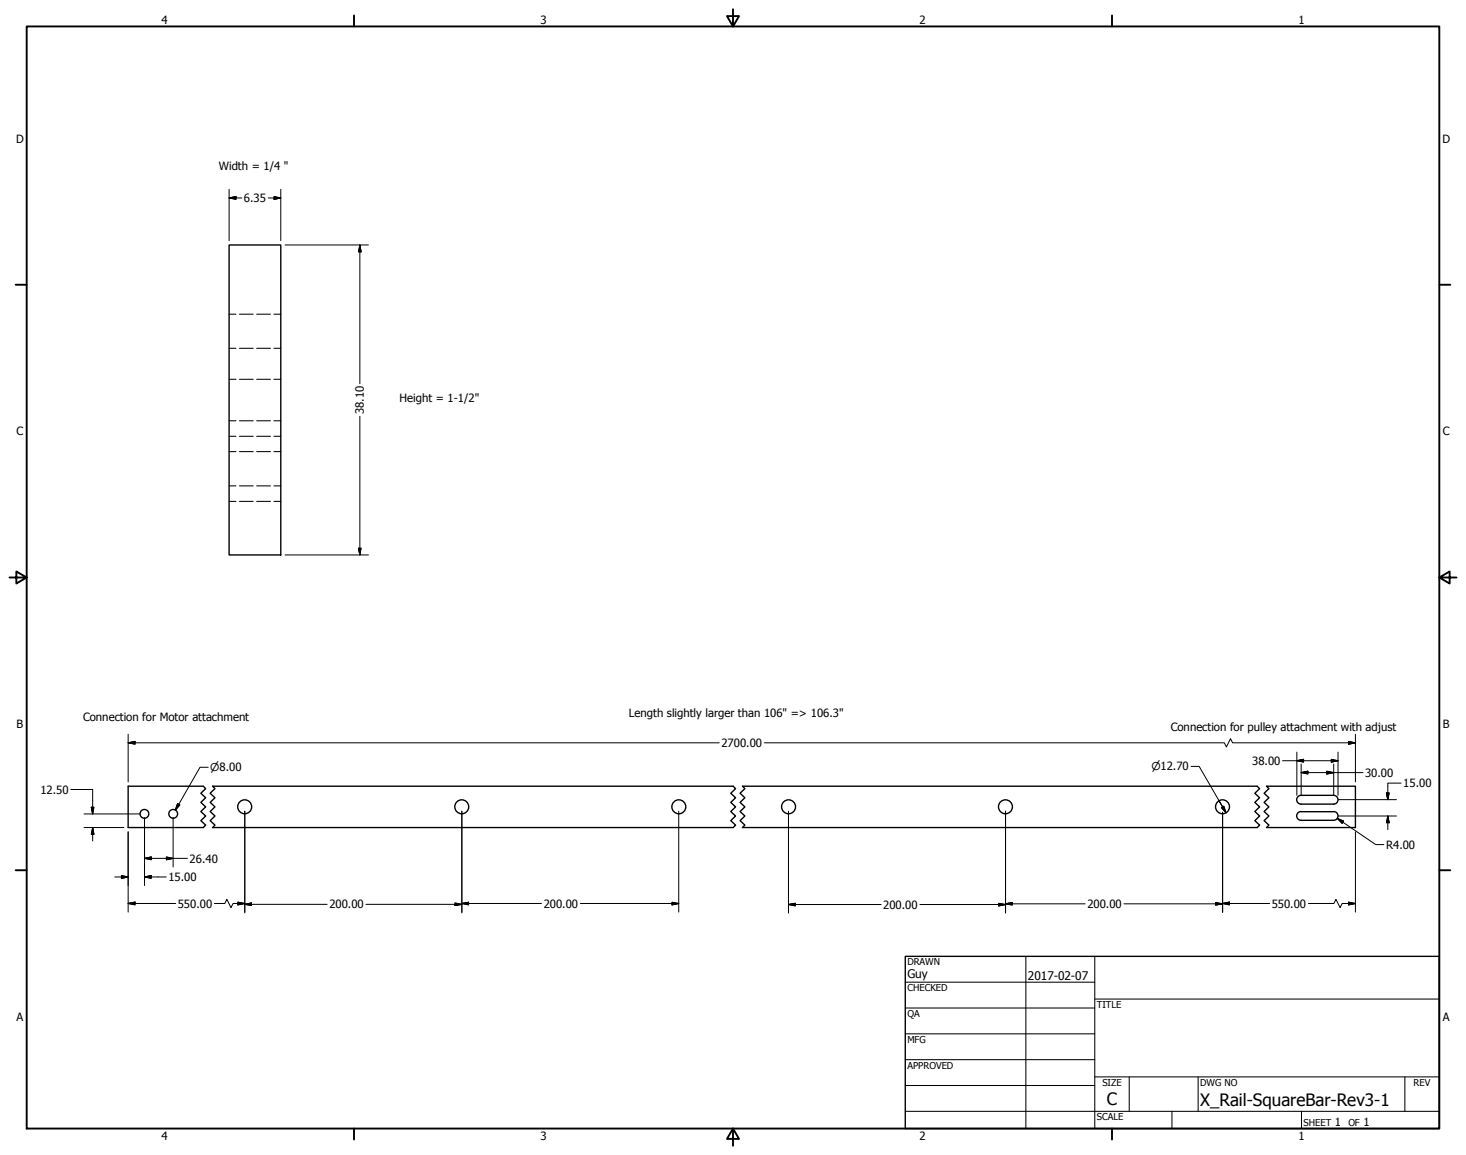
[picture p172: page 1]
SHEET 1 OF 1; DRAWN; CHECKED; MFG; APPROVED; Guy; DWG NO X_Rail-SquareBar-Rev3-1; TITLE; SIZE C; SCALE; REV; Width = 1/4 "; Height = 1-1/2"

Connection for Motor attachment

Length slightly larger than 106" => 106.3"

Connection for pulley attachment with adjust
