EricLeFort/Capstone-Project/doc/CAD/Drawings/PDFs/NEMA 23 Holder.pdf

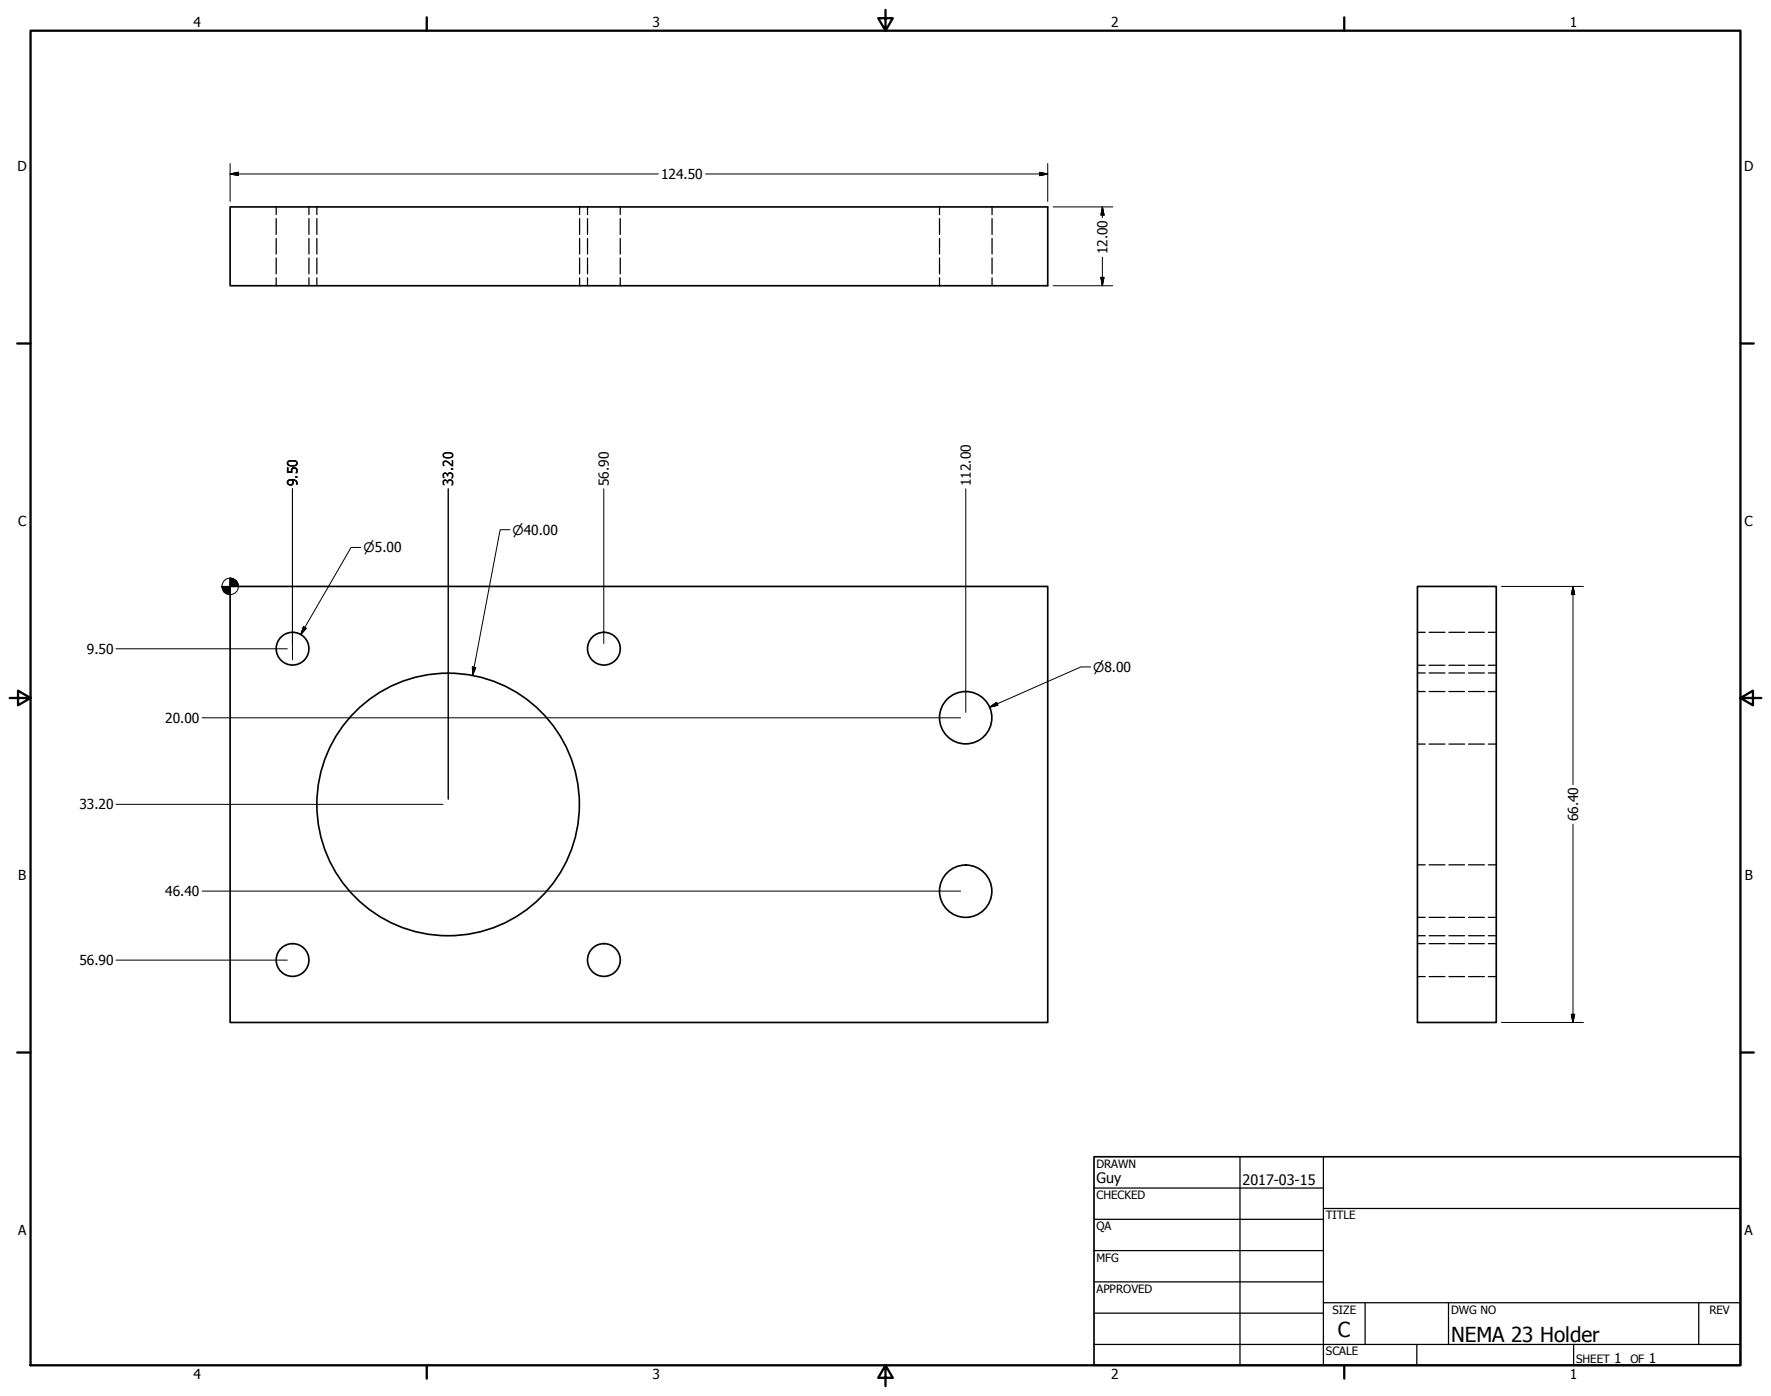
[picture p173: page 1]
SHEET 1 OF 1; DRAWN; CHECKED; MFG; APPROVED; Guy; DWG NO NEMA 23 Holder; TITLE; SIZE C; SCALE; REV
