EricLeFort/Capstone-Project/doc/CAD/Drawings/PDFs/Arm_Base-SquareBar-Rev3-2.pdf

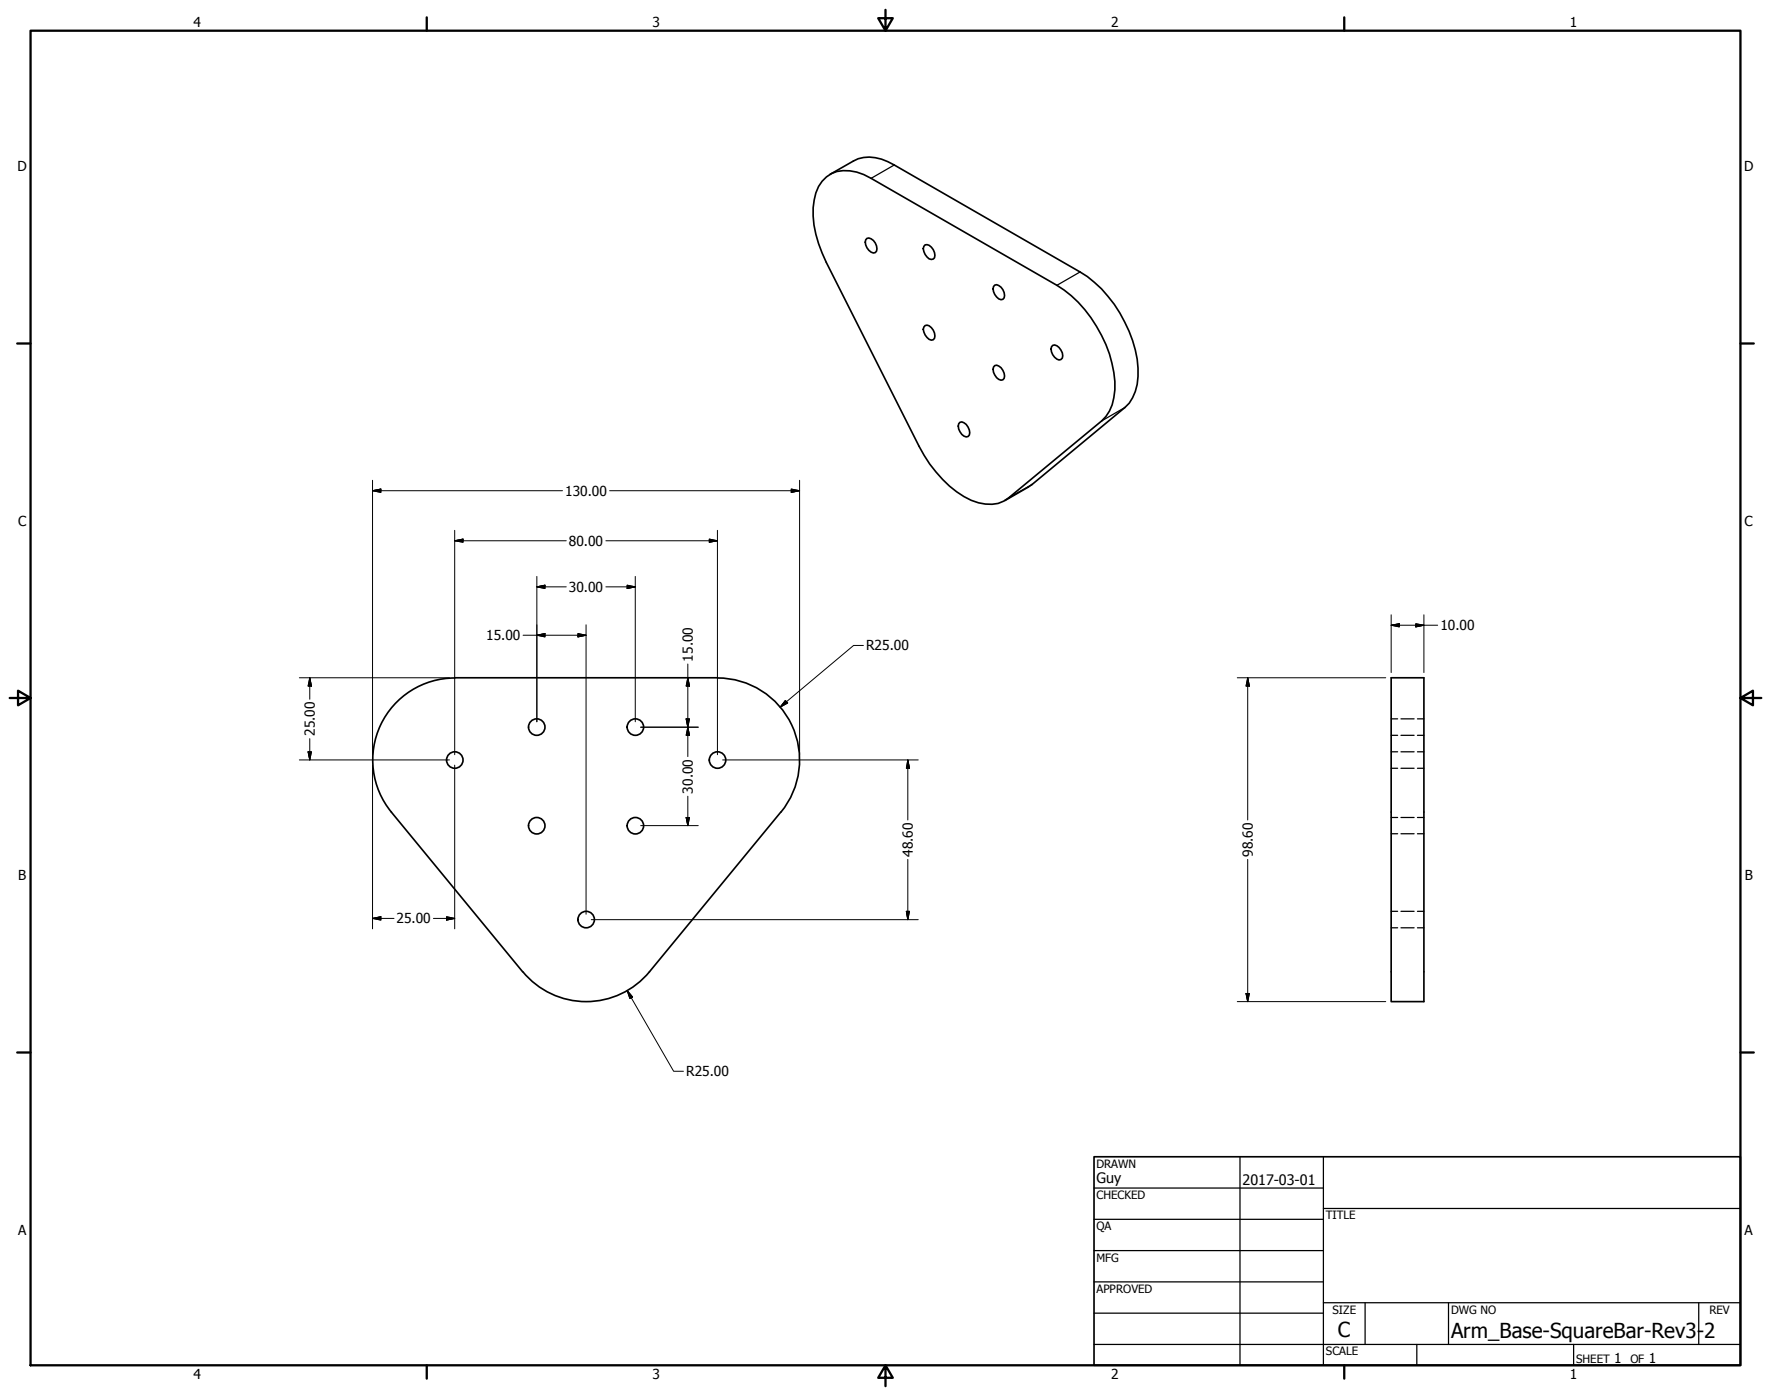
[picture p174: page 1]
SHEET 1 OF 1; DRAWN; CHECKED; MFG; APPROVED; Guy; DWG NO Arm_Base-SquareBar-Rev3-2; TITLE; SIZE C; SCALE; REV
