EricLeFort/Capstone-Project/doc/CAD/Drawings/PDFs/Y_Rail-SquareBar-Rev3-1.pdf

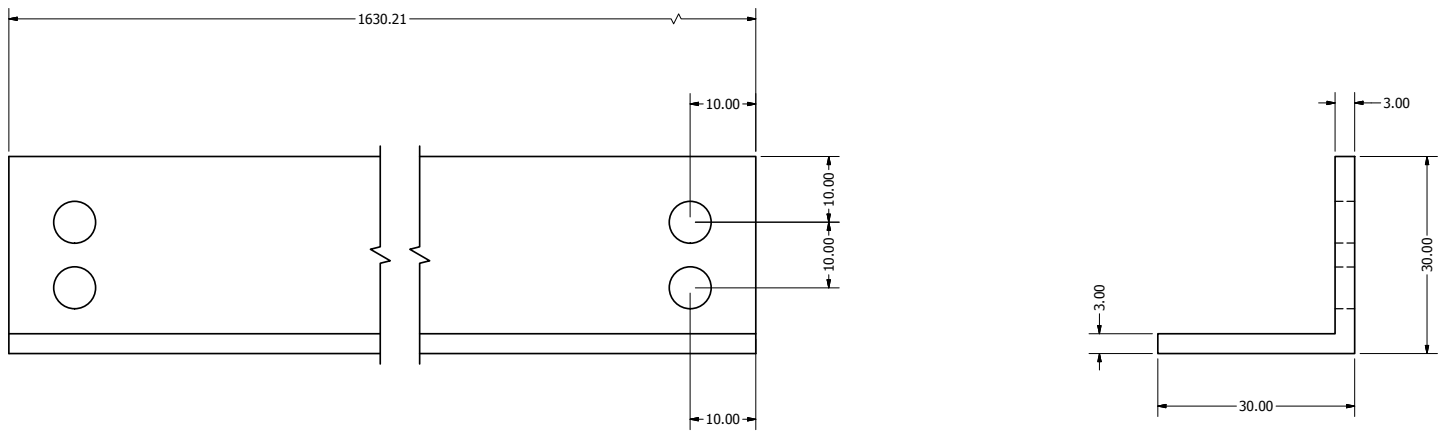
[picture p175: page 1]
SHEET 1 OF 1; DRAWN; CHECKED; MFG; APPROVED; Guy; DWG NO Y_Rail-SquareBar-Rev3-1; TITLE; SIZE C; SCALE; REV
