EricLeFort/Capstone-Project/doc/CAD/Drawings/PDFs/1-2in_13tpi.pdf

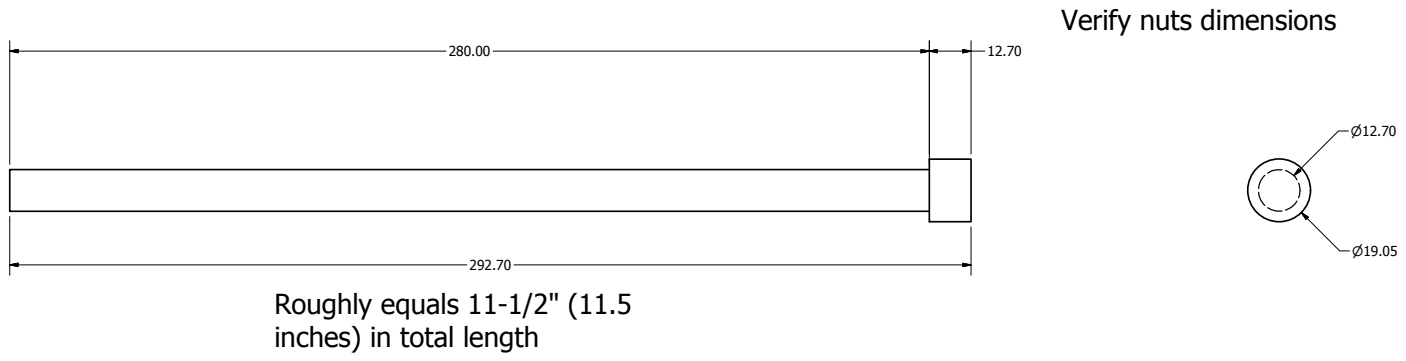
[picture p176: page 1]
SHEET 1 OF 1; DRAWN; CHECKED; MFG; APPROVED; Guy; DWG NO 1-2in_13tpi; TITLE; SIZE C; SCALE; REV

Verify nuts dimensions

Roughly equals 11-1/2" (11.5
inches) in total length
