EricLeFort/Capstone-Project/(commit log)

2016-11-25 Use case diagram completed and added
2016-11-29 Section 7 (Motor Specs) and 8 (Emerg Shutoff)
2016-11-29 added notes on what should be added to the PoC document on the software side, specifically what the algorithm for shot decision will look like and the device intercommunication.
2016-11-29 Adding main CAD - Pool Table
    [Table_Model.0009.ipt, Table_Model.ipt]
2016-12-02 Hardware High Level design CAD models
    [Arm.0003.ipt, Arm.ipt, ArmBase3.0002.ipt, ArmBase3.ipt, Bridge.0001.ipt, Bridge.ipt, EF-Arm.0002.ipt, EF-Arm.ipt]
2016-12-06 Coloured Pool Table CAD
    [Table_Model.ipt]
2016-12-06 Adding Pool Table CAD files
    [Table_Model.0009.ipt]
2016-12-06 Adding Pool Table CAD
    [Table_Model.0010.ipt]
2016-12-06 Moved around some files, initialized the high level hardware design document
    [Table_Model.0009.ipt, Table_Model.ipt]
2016-12-07 Update CAD models
    [Table_Model.0009.ipt, Table_Model.0010.ipt, Table_Model.ipt, highlevel.0003.iam, highlevel.0004.iam, highlevel.iam]
2016-12-08 First draft of hardware design almost complete
    [Table_Model.0009.ipt, Table_Model.ipt]
2016-12-16 Created High Level Camera Mount +assembly
    [ArmBase3.0002.ipt, ArmBase3.0003.ipt, ArmBase3.ipt, CameraMount.0004.ipt, CameraMount.ipt, highlevel.0004.iam, highlevel.0009.iam, highlevel.iam]
2016-12-16 Camera Mount
2016-12-17 Hardware HighLevel
    [highlevel.iam]
2016-12-17 Hardware High Level Changes
    [highlevel.0010.iam]
2016-12-17 Error changes
    [highlevel.0009.iam]
2016-12-22 Guy Meyer: Hardware - Low Level - Rev 1
    [EE-Rod-Rev1.ipt, EE_Arm-Rod-Rev1.0001.ipt, EE_Arm-Rod-Rev1.0002.ipt, EE_Arm-Rod-Rev1.0003.ipt, EE_Arm-Rod-Rev1.0004.ipt, EE_Arm-Rod-Rev1.0005.ipt, EE_Arm-Rod-Rev1.ipt, EE_Base-Rod-Rev1.0002.ipt]
2016-12-23 Adding sample rails to CAD
    [rail_lan26-160.ipt, slider_pan26-3.ipt, slider_pan26-3t.ipt, slider_pan26-5.ipt, slider_pan26-5t.ipt]
2016-12-24 Hardware LowLevel Rev2 (overall structure)
    [Arm_Base-Rod-Rev2.0007.ipt, Arm_Base-Rod-Rev2.ipt, Overall_Assembly_Rev1.0019.iam, Overall_Assembly_Rev1.0021.iam, Overall_Assembly_Rev1.iam, Overall_Assembly_Rev2.0005.iam, Overall_Assembly_Rev2.0006.iam, Overall_Assembly_Rev2.iam]
2016-12-24 Hardware Lowlevel Rev2 additions
    [Arm_Base-Rod-Rev2.0007.ipt, Arm_Base-Rod-Rev2.0010.ipt, Arm_Base-Rod-Rev2.ipt, EE_Arm-Rod-Rev1.0002.ipt, EE_Arm-Rod-Rev1.0003.ipt, EE_Arm-Rod-Rev1.0006.ipt, EE_Arm-Rod-Rev1.ipt, EE_Assembly_Rev2.0004.iam]
2016-12-25 Hardware LowLevel assembly additions
    [EE_Assembly_Rev2.0004.iam, EE_Assembly_Rev2.0005.iam, EE_Assembly_Rev2.iam, X_rail_Assembly_Rev2.0007.iam, X_rail_Assembly_Rev2.0008.iam, X_rail_Assembly_Rev2.iam]
2016-12-26 Hardware Lowlevel assembly
    [Arm_Base-Rod-Rev2.0010.ipt, Arm_Base-Rod-Rev2.0011.ipt, Arm_Base-Rod-Rev2.ipt, EE-Rod-Rev1.0001.ipt, EE-Rod-Rev1.ipt, EE_Arm-Rod-Rev1.0001.ipt, EE_Arm-Rod-Rev1.0006.ipt, EE_Arm-Rod-Rev1.0007.ipt]
2017-01-09 Hardware LowLevel design Rev3
    [Arm-SquareBar-Rev3.0001.ipt, Arm-SquareBar-Rev3.ipt, Arm_Base-SquareBar-Rev3.0002.ipt, Arm_Base-SquareBar-Rev3.0003.ipt, Arm_Base-SquareBar-Rev3.ipt, Overall_Assembly_Rev1.0021.iam, Overall_Assembly_Rev1.0022.iam, Overall_Assembly_Rev1.iam]
2017-01-10 Hardware LowLevel Rev3 - XRails - modified
    [Arm_Base-SquareBar-Rev3.0004.ipt, Arm_Base-SquareBar-Rev3.ipt, XY_Wheel-SquareBar-Rev3.0001.ipt, XY_Wheel-SquareBar-Rev3.0002.ipt, XY_Wheel-SquareBar-Rev3.ipt, X_Rai-SquareBar-Rev3.0001.ipt, X_Rai-SquareBar-Rev3.0002.ipt, X_Rai-SquareBar-Rev3.ipt]
2017-01-11 Hardware LowLevel Rev 3 Y and X rail modelling
    [Arm-SquareBar-Rev3.0002.ipt, Arm-SquareBar-Rev3.ipt, Arm_Base-SquareBar-Rev3.0005.ipt, Arm_Base-SquareBar-Rev3.ipt, EE_Base-SquareBar-Rev3.ipt, XY_Wheel-SquareBar-Rev3.0003.ipt, XY_Wheel-SquareBar-Rev3.ipt, X_Rai-SquareBar-Rev3.0003.ipt]
2017-01-12 Low level design of the shooting mechanism
    [BackStopper.0007.ipt, BackStopper.ipt, CueBeltHorder.0006.ipt, CueBeltHorder.ipt, CueHolder.0001.ipt, CueHolder.ipt, CueHolderBottom.0014.ipt, CueHolderBottom.0015.ipt]
2017-01-13 Hardware LowLevel X and Y Rail addition and mods
    [3-16in_1 1-4in_Bolt.0002.ipt, 3-16in_1 1-4in_Bolt.ipt, 3-16in_1-16in_nut(num2).0001.ipt, 3-16in_1-16in_nut(num2).ipt, 3-16in_7-16in_washer(num8).0001.ipt, 3-16in_7-16in_washer(num8).ipt, Arm-SquareBar-Rev3.0001.ipt, Arm-SquareBar-Rev3.0004.ipt]
2017-01-14 low level design of the end effector base. Sofar just the central axle.
    [Assembly1.0002.iam, Assembly1.iam, BallBearing.0001.ipt, BallBearing.ipt, BallBearingCone.ipt, BallBearingConeLockNut.ipt, BallBearingCup.ipt, BallBearingCupMount.0001.ipt]
2017-01-14 Hardware very LowLevel X and Y rail mods
    [EE_Base-SquareBar-Rev3.0002.ipt, EE_Base-SquareBar-Rev3.0004.ipt, EE_Base-SquareBar-Rev3.0009.ipt, EE_Base-SquareBar-Rev3.0011.ipt, EE_Base-SquareBar-Rev3.ipt, Spur Gear11.0001.ipt, Spur Gear11.ipt, Spur Gear21.0001.ipt]
2017-01-16 problems adding y rails
2017-01-16 Eric's troubleshooting
    [Assembly1.0002.iam, Assembly1.0003.iam, Assembly1.iam, EE_Base-SquareBar-Rev3.0011.ipt, EE_Base-SquareBar-Rev3.0012.ipt, EE_Base-SquareBar-Rev3.ipt, Y_rail_Assembly_Rev3.0017.iam, Y_rail_Assembly_Rev3.0020.iam]
2017-01-22 Hardware Lowlevel design Rev3 - Overall Assembly need width dimension for y axis
    [3-16in_1 1-4in_Bolt.0002.ipt, 3-16in_1 1-4in_Bolt.0003.ipt, 3-16in_1 1-4in_Bolt.ipt, Arm_Base-SquareBar-Rev3.0002.ipt, Arm_Base-SquareBar-Rev3.0007.ipt, Arm_Base-SquareBar-Rev3.0008.ipt, Arm_Base-SquareBar-Rev3.ipt, NEMA 23 Holder.0001.ipt]
2017-01-24 From ernest hopefully it won't break anything
    [Assembly1.iam, Base.0001.ipt, Base.ipt, Cuerpo.0001.ipt, Cuerpo.ipt, Eje.0001.ipt, Eje.ipt, MountB.0006.ipt]
2017-01-24 updates to overall assembly
    [1-2in_13tpi x 6 in.ipt, EE_Base-SquareBar-Rev3.0012.ipt, EE_Base-SquareBar-Rev3.0013.ipt, EE_Base-SquareBar-Rev3.ipt, NEMA 17 with T5 Pulley.0002.iam, NEMA 17 with T5 Pulley.0003.iam, NEMA 17 with T5 Pulley.iam, Overall_Assembly_Rev3.0001.iam]
2017-01-25 Hardware Overall improvements
    [1-2in_13tpi x 6 in.0001.ipt, 1-2in_13tpi x 6 in.ipt, 1-2in_13tpi x 8 in.ipt, Arm-SquareBar-Rev3.0002.ipt, Arm-SquareBar-Rev3.0004.ipt, Arm-SquareBar-Rev3.0006.ipt, Arm-SquareBar-Rev3.ipt, EE_Base-SquareBar-Rev3.0013.ipt]
2017-01-30 Rearenging of files and folders on the Cad folder
    [Assembly1.iam, Base.0001.ipt, Base.ipt, Cuerpo.0001.ipt, Cuerpo.ipt, Eje.0001.ipt, Eje.ipt, M1173041- NEMA 17.0029.ipt]
2017-01-30 main hardware design
    [Assembly1.0003.iam, Assembly1.0006.iam, Assembly1.iam, Y_rail_Assembly_Rev3.0031.iam, Y_rail_Assembly_Rev3.0032.iam, Y_rail_Assembly_Rev3.iam]
2017-02-06 Lots of changes, simulation is on the backburner. Automatically running matlab program (machine specific)
    [TableState.csv]
2017-02-07 Untested android server socket added, beginnings of the uCListener
    [TableState.csv]
2017-02-08 Fixed overall assembly and added drawings of X rails
    [Overall_Assembly_Rev3.0006.iam, Overall_Assembly_Rev3.0009.iam, Overall_Assembly_Rev3.iam, ShootingMechanism.0024.iam, ShootingMechanism.0025.iam, ShootingMechanism.iam, X_Rai-SquareBar-Rev3.0012.ipt, X_Rai-SquareBar-Rev3.0013.ipt]
2017-02-13 EventHandler module revision 0, PCCommunicator to Camera communication revision 0
2017-02-13 Changes to endeffectorBase and ShootingMechanism
    [AdjusterSmallBottom.0002.ipt, AdjusterSmallTop.0002.ipt, Assembly1.0003.iam, Assembly1.0017.iam, Assembly1.iam, BackStopper.0008.ipt, BackStopper.ipt, BallBearingCupMountBottom.0011.ipt]
2017-02-14 Laser cutter drawings for x rail components
    [NEMA 23 Holder.0001.ipt, NEMA 23 Holder.0002.ipt, NEMA 23 Holder.ipt, X_Rail_Components(Needs Prep for laser cut).0002.dwg, X_Rail_Components(Needs Prep for laser cut).dwg, X_Rail_Components(printable).0002.dwg, X_Rail_Components(printable).dwg]
2017-02-14 update x rail components laser cut printable PDF
2017-02-17 Shooting mechanism model doesn't have some constrains
    [CueBeltHorder.0006.ipt, CueBeltHorder.0014.ipt, CueBeltHorder.ipt, CueHolderBottom.0014.ipt, CueHolderBottom.0015.ipt, CueHolderBottom.0021.ipt, CueHolderBottom.ipt, CueHolderLBBottom.0013.ipt]
2017-02-19 adding presentation slides
    [1-2in_13tpi x 8 in.0002.ipt, 1-2in_13tpi x 8 in.ipt, 1-2in_13tpi.0001.dwg, 1-2in_13tpi.dwg, 3-16in_1 1-4in_Bolt.0003.ipt, 3-16in_1 1-4in_Bolt.0004.ipt, 3-16in_1 1-4in_Bolt.ipt, Arm_Base-SquareBar-Rev3.0005.ipt]
2017-02-24 Current status of the simulation update
    [TableState.csv]
2017-02-24 New shooting mechanism with piston
    [MountBar.0002.ipt, MountBar.0003.ipt, MountBar.ipt, Overall_Assembly_Rev3.0012.iam, Overall_Assembly_Rev3.0016.iam, Overall_Assembly_Rev3.iam, Overall_Shooting_Mechanism2.0017.iam, Overall_Shooting_Mechanism2.iam]
2017-02-28 Work done on simulator, initiated VV document
    [TableState.csv]
2017-02-28 Ball collisions ready for real world testing, inPocket() to be improved
    [TableState.csv]
2017-02-28 Test case template
2017-03-01 new ee and v&v stuff
    [Arm-SquareBar-Rev3.0005.ipt, Arm-SquareBar-Rev3.0007.ipt, Arm-SquareBar-Rev3.ipt, Arm_Base-SquareBar-Rev3.0011.ipt, Arm_Base-SquareBar-Rev3.0012.ipt, Arm_Base-SquareBar-Rev3.ipt, Assembly1.iam, MountBar.0003.ipt]
2017-03-01 is now printing to a file as per specification, x is y and y is x, and the compuation of ball colour needs to be completed.
2017-03-02 Added traceability table template, just needs to be filled in
2017-03-03 Added ids, created blank traceability matrices
2017-03-03 hardware cad and VV tests added
    [Arm-SquareBar-Rev3.0002.dwg, Arm-SquareBar-Rev3.0006.ipt, Arm-SquareBar-Rev3.0007.ipt, Arm-SquareBar-Rev3.0009.ipt, Arm-SquareBar-Rev3.0010.ipt, Arm-SquareBar-Rev3.dwg, Arm-SquareBar-Rev3.ipt, Arm_Base-SquareBar-Rev3-2.dwg]
2017-03-03 Descriptions added, some traceability matrix filled in
2017-03-03 Document layout complete, traceability left
2017-03-05 added cad for ee base + new shooting mechanism parts
    [EE_base_assembly.0001.iam, EE_base_assembly.iam, Overall_Assembly_Rev3.0020.iam, Overall_Assembly_Rev3.0024.iam, Overall_Assembly_Rev3.iam, Overall_Shooting_Mechanism2.0023.iam, Overall_Shooting_Mechanism2.0025.iam, Overall_Shooting_Mechanism2.iam]
2017-03-05 cad ee base and final overall cad
    [EE_base_assembly.0001.iam, EE_base_assembly.0002.iam, EE_base_assembly.iam, Overall_Assembly_Rev3.0024.iam, Overall_Assembly_Rev3.0025.iam, Overall_Assembly_Rev3.iam, Rail_Pulley_Connector.0002.ipt, Rail_Pulley_Connector.0003.ipt]
2017-03-05 Adding the L-Bracket cad files
    [L-Bracket.ipt]
2017-03-06 Bug fixes: bad quadrant for ball collision, underflow in scoring
    [TableState.csv]
2017-03-07 cad lowlevel arm drawings and arm base
    [Arm-SquareBar-Rev3.0001.dwg, Arm-SquareBar-Rev3.0009.ipt, Arm-SquareBar-Rev3.0011.ipt, Arm-SquareBar-Rev3.dwg, Arm-SquareBar-Rev3.ipt, Assembly1.iam, Overall_Assembly_Rev3.0025.iam, Overall_Assembly_Rev3.0026.iam]
2017-03-07 new 1/2in rod for sm2
    [1-2in_eebase_connector.0001.ipt, 1-2in_eebase_connector.ipt, Overall_Assembly_Rev3.0026.iam, Overall_Assembly_Rev3.0027.iam, Overall_Assembly_Rev3.iam, Overall_Shooting_Mechanism2.0025.iam, Overall_Shooting_Mechanism2.0027.iam, Overall_Shooting_Mechanism2.iam]
2017-03-07 Adding phone and phone holder CAD models
    [Assembly1.0006.iam, Assembly1.0017.iam, Assembly1.0018.iam, Assembly1.iam, HolderFront.0001.ipt, HolderFront.ipt, HolderMid.0001.ipt, HolderMid.ipt]
2017-03-07 Updating CAD models
2017-03-08 Adding new rev of EEBase
    [Assembly1.0003.iam, Assembly1.iam, BallBearing.ipt, BigPositionDisk.ipt, HolderFront.0001.ipt, HolderFront.0002.ipt, HolderFront.ipt, HolderMid.0001.ipt]
2017-03-10 more cad stuuf
    [1-2in_eebase_connector.0001.ipt, 1-2in_eebase_connector.0002.ipt, 1-2in_eebase_connector.ipt, Arm-SquareBar-Rev3-1.0001.dwg, Arm-SquareBar-Rev3-1.dwg, Arm-SquareBar-Rev3.0011.ipt, Arm-SquareBar-Rev3.0013.ipt, Arm-SquareBar-Rev3.ipt]
2017-03-10 Update EE base rev 2 and adding arm belt holder
    [6-32_Bolt.ipt, 6-32_Nut.ipt, 9mmRodNut.0002.ipt, 9mmRodNut.ipt, Arm-Belt-Holder.0001.ipt, Arm-Belt-Holder.ipt, Assembly1.0003.iam, Assembly1.0008.iam]
2017-03-10 hardware cad updates (arm holes)
    [Arm-SquareBar-Rev3.0014.ipt, Arm-SquareBar-Rev3.0015.ipt, Arm-SquareBar-Rev3.ipt, NEMA 23 Holder.0003.ipt, NEMA 23 Holder.0004.ipt, NEMA 23 Holder.ipt, Overall_Assembly_Rev3.0032.iam, Overall_Assembly_Rev3.0033.iam]
2017-03-10 Updating EE base 2
    [Assembly1.0008.iam, Assembly1.0009.iam, Assembly1.0019.iam, Assembly1.0020.iam, Assembly1.iam, BallBearingHolderBottom.0001.ipt, BallBearingHolderBottom.0003.ipt, BallBearingHolderBottom.ipt]
2017-03-10 Updating CAD components
    [LinesensorHolderBottom.0002.ipt, LinesensorHolderBottom.0003.ipt, LinesensorHolderBottom.ipt]
2017-03-11 Updates to EE base 2
    [6-32_Bolt.ipt, 6-32_Nut.ipt, Assembly1.0009.iam, Assembly1.0010.iam, Assembly1.iam, BallBearingHolderBottom.0003.ipt, BallBearingHolderBottom.0004.ipt, BallBearingHolderBottom.ipt]
2017-03-12 arm pulley connector and cad changes
    [Arm_Pulley_Connector.0001.ipt, Arm_Pulley_Connector.ipt, Overall_Assembly_Rev3.0033.iam, Overall_Assembly_Rev3.0034.iam, Overall_Assembly_Rev3.iam, Y_rail_Assembly_Rev3.0040.iam, Y_rail_Assembly_Rev3.0043.iam, Y_rail_Assembly_Rev3.0044.iam]
2017-03-12 stl of arm-pulley connector and new stl folder under CAD >> Drawings
    [Arm_Pulley_Connector.stl]
2017-03-12 Undates to EE base CAD model
    [Assembly1.0010.iam, Assembly1.0014.iam, Assembly1.iam, BallBearingHolderBottom.0004.ipt, BallBearingHolderBottom.0006.ipt, BallBearingHolderBottom.ipt, BallBearingHolderTop.0005.ipt, BallBearingHolderTop.0007.ipt]
2017-03-14 Cupdate EE base models and Y rail rev 3 model
    [Assembly1.0014.iam, Assembly1.0019.iam, Assembly1.iam, EE_base_assembly.0013.iam, EE_base_assembly.0016.iam, EE_base_assembly.iam, HolderFront.0003.ipt, HolderFront.0004.ipt]
2017-03-15 Updating EE base CAD model
    [Assembly1.0019.iam, Assembly1.0034.iam, Assembly1.iam, BottomWheelHolder.0006.ipt, BottomWheelHolder.ipt, EE_base_assembly.0016.iam, EE_base_assembly.0018.iam, EE_base_assembly.iam]
2017-03-15 EE base plates in same plane for laser cut
    [ForLaserCut.iam]
2017-03-15 Update final design of EE_Base CAD
    [Arm-Belt-Holder.0001.ipt, Arm-Belt-Holder.0002.ipt, Arm-Belt-Holder.ipt, Arm-SquareBar-Rev3.0010.ipt, Arm-SquareBar-Rev3.0015.ipt, Arm-SquareBar-Rev3.0017.ipt, Arm-SquareBar-Rev3.ipt, Assembly1.0034.iam]
2017-03-15 Some work on Arduino code, certain parts complete (untested) other parts are a shell to be filled in
2017-03-20 cad changes
    [Assembly1.0034.iam, Assembly1.0035.iam, Assembly1.iam, NEMA 23 Holder.0001.dwg, NEMA 23 Holder.0004.ipt, NEMA 23 Holder.0005.ipt, NEMA 23 Holder.dwg, NEMA 23 Holder.ipt]
2017-03-20 accounting for .25 mm in laser cutter
    [Assembly1.0035.iam, Assembly1.0036.iam, Assembly1.iam, EE_base_assembly.0021.iam, EE_base_assembly.0022.iam, EE_base_assembly.iam, SideLeft.0009.ipt, SideLeft.0010.ipt]
2017-03-20 ee base laser cut
    [EE_base_laser_cut.dwg]
2017-03-22 laser cutting prep for ee base
    [EE_base_laser_cut(autocad).dwg]
2017-03-24 Tested on pool table for x-rail
    ~ x-rail functionality works consistently with end-stops, user-buttons, and serial-line movement request
    ~ next is to test y-rail with x-rail on pool table
2017-03-26 cad addition (fine detail) + Hardware fullDesign Doc revisions and additions
    [1-2in_eebase_connector.0003.ipt, 1-2in_eebase_connector.ipt, 3-16in_1 1-4in_Bolt.0004.ipt, 3-16in_1 1-4in_Bolt.0005.ipt, 3-16in_1 1-4in_Bolt.ipt, 3in_bolt_for_belt_tightening.0001.ipt, 3in_bolt_for_belt_tightening.ipt, 8mm_x_rail_connection.0001.ipt]
2017-03-27 Changes to EE base laser cut parts
    [Assembly1.0036.iam, Assembly1.0037.iam, Assembly1.iam, EE_base_assembly.0022.iam, EE_base_assembly.0023.iam, EE_base_assembly.iam, SideLeft.0010.ipt, SideLeft.0011.ipt]
2017-03-27 EE Base bottom plate, hole reduction
    [bottom.0019.ipt, bottom.0020.ipt, bottom.ipt]
2017-03-27 cad changes, exploded views and doc revisions
    [1-2in_13tpi x 8 in.0002.ipt, 1-2in_13tpi x 8 in.0003.ipt, 1-2in_13tpi x 8 in.ipt, 3in_bolt_for_belt_tightening.0001.ipt, 3in_bolt_for_belt_tightening.0002.ipt, 3in_bolt_for_belt_tightening.ipt, 8mm_x_rail_connection.0001.ipt, 8mm_x_rail_connection.0002.ipt]
2017-03-27 changes to EE base
    [bottom.0020.ipt, bottom.0022.ipt, bottom.ipt]
2017-03-27 changes to ee base hole sizes
    [EE_base_assembly.0023.iam, EE_base_assembly.0024.iam, EE_base_assembly.iam, SideLeft.0011.ipt, SideLeft.0012.ipt, SideLeft.ipt, SideRight.0011.ipt, SideRight.0012.ipt]
2017-03-28 x-rail speedup slowdown functionality
2017-04-03 changes to eebase 3d printed components
    [Assembly1.0037.iam, Assembly1.0040.iam, Assembly1.0042.iam, Assembly1.iam, BallBearingHolderBottom.0006.ipt, BallBearingHolderBottom.0008.ipt, BallBearingHolderBottom.ipt, BallBearingHolderTop.0007.ipt]
2017-04-09 Tested for Y-Rail endstops and R motor motion
2017-04-11 Update for R sensors
2017-04-11 Arduino-Java comms ready, some testing code as well
2017-04-12 Lots of testing code added -- Ball, PCCommunicator, Shot
    [GoodTableState1.csv, GoodTableState2.csv, InvalidTableState1.csv, InvalidTableState2.csv, InvalidTableState3.csv]
2017-04-13 More testing code -- SimulationInstance, TableState
    [GoodTableState3.csv, GoodTableState4.csv]
2017-04-15 cad additions and little parts for the pneumatics
    [Assembly1.0037.iam, Assembly1.0039.iam, Assembly1.iam, EE_base_assembly.0024.iam, EE_base_assembly.0027.iam, EE_base_assembly.iam, EE_base_connection.0005.ipt, EE_base_connection.ipt]
2017-04-16 added the "switchscript" which will switch to sidesync and takea photo, as well as the source code for it (.ahk)
2017-04-17 Merged in comms functionality to Derek and Andrews code as well as style fixes
    [microController.ino]
2017-04-17 Move L/R button, Serial Comms, Take Shot Trig
2017-04-17 Small change to user button
2017-04-22 Fix for EE orientation
    [microController.ino]
2017-04-25 Fix R calibrate
2017-04-26 Merging in the changes on Maxs computer, from Eric
    [TableState.csv]
2017-04-26 updated VR for boosted precision, running version
    [TableState.csv]
2017-04-26 Fixed initial speed, delete tablestate file after use, visual for optimal shot
    [microController.ino]
2017-04-27 Added changes from Maxs computer
    [TableState.csv]
2017-04-27 Small updates
    [TableState.csv]
2017-04-27 Solved the big simulation issue
    [TableState.csv]
2017-04-27 Allow pull
    [TableState.csv]
2017-04-27 Simulation scoring fixes
    [TableState.csv]
2017-04-27 VR fixes
    [TableState.csv]
2017-05-02 all changes made in final week ... woo, we're done.
    [TableState.csv]
2017-05-07 Cleaned up Arduino code, removed unnecessary files
2017-05-13 Changes to get VR working on Mac
    [TableState.csv]
