EricLeFort/Capstone-Project/resources/testingImages/good_balls.jpg

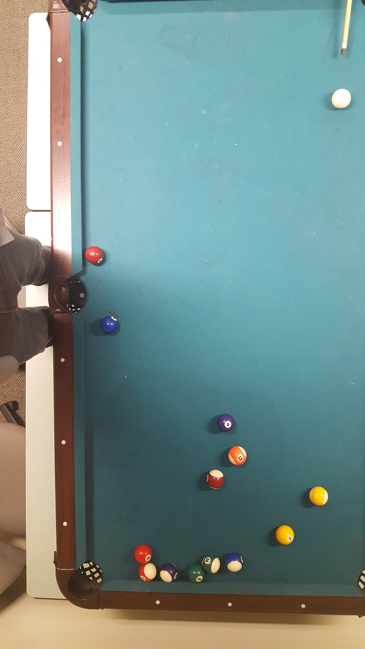
resources/testingImages/good_balls.jpg
